pedrofausto/EMC08/ports/design/reports/report_area.txt

============================================================
  Generated by:           Encounter(R) RTL Compiler v07.20-s009_1
  Generated on:           Oct 01 2010  03:59:04 PM
  Module:                 PORT_TOP
  Technology library:     D_CELLS_MOSLP_typ_1_80V_25C V 2.1.0
  Operating conditions:   TYPICAL (balanced_tree)
  Wireload mode:          enclosed
  Area mode:              timing library
============================================================

Instance  Cells  Cell Area  Net Area   Wireload     
----------------------------------------------------
PORT_TOP     32        197        71       0_1k (S) 

 (S) = wireload was automatically selected
