pedrofausto/EMC08/timers/verification/reports/timer2/report_detail_module.html

ICCR HTML Report

Go to First Summary Coverage File
Go to First Detail Coverage File

COVERAGE FILE: | Go to detail report for this coverage file

/home/student/DFund-SBTUSER_6_1_1/Data/SBTBASIC/timer_emc08/verif/timer2_e/cov_work/design/tmr2_cov_test_f1/icc.data

Coverage Summary Report, Module-Based
B = Block, BR = Branch, E = Expression
ToC(%) = Total coverage percentage

Coverage data sorted by: Block Expression
Coverage data sorted using: coverage percentages

ToC(%)  B(%)              E(%)              Name
------------------------------------------------
0        -- (0/0)          -- (0/0)         timers_timer2_top_pdcf_pdf
0        -- (0/0)          -- (0/0)         top_timer2
65       65 (27/41)        65 (13/20)       timers_timer2_acg
68       72 (13/18)        64 (11/17)       timers_timer2_pdf
93       92 (13/14)       100 (2/2)         timers_timer2_pdcf
100     100 (3/3)          -- (0/0)         timer2_tb

COVERAGE FILE: | Go to detail report for this coverage file

/home/student/DFund-SBTUSER_6_1_1/Data/SBTBASIC/timer_emc08/verif/timer2_e/cov_work/design/tmr2_cov_test_f2/icc.data

Coverage Summary Report, Module-Based
B = Block, BR = Branch, E = Expression
ToC(%) = Total coverage percentage

Coverage data sorted by: Block Expression
Coverage data sorted using: coverage percentages

ToC(%)  B(%)              E(%)              Name
------------------------------------------------
0        -- (0/0)          -- (0/0)         timers_timer2_top_pdcf_pdf
0        -- (0/0)          -- (0/0)         top_timer2
68       72 (13/18)        64 (11/17)       timers_timer2_pdf
85       85 (35/41)        85 (17/20)       timers_timer2_acg
93       92 (13/14)       100 (2/2)         timers_timer2_pdcf
100     100 (3/3)          -- (0/0)         timer2_tb

COVERAGE FILE: | Go to detail report for this coverage file

/home/student/DFund-SBTUSER_6_1_1/Data/SBTBASIC/timer_emc08/verif/timer2_e/cov_work/design/tmr2_cov_test_f3/icc.data

Coverage Summary Report, Module-Based
B = Block, BR = Branch, E = Expression
ToC(%) = Total coverage percentage

Coverage data sorted by: Block Expression
Coverage data sorted using: coverage percentages

ToC(%)  B(%)              E(%)              Name
------------------------------------------------
0        -- (0/0)          -- (0/0)         timers_timer2_top_pdcf_pdf
0        -- (0/0)          -- (0/0)         top_timer2
68       72 (13/18)        64 (11/17)       timers_timer2_pdf
90       90 (37/41)        90 (18/20)       timers_timer2_acg
93       92 (13/14)       100 (2/2)         timers_timer2_pdcf
100     100 (3/3)          -- (0/0)         timer2_tb

COVERAGE FILE: | Go to detail report for this coverage file

/home/student/DFund-SBTUSER_6_1_1/Data/SBTBASIC/timer_emc08/verif/timer2_e/cov_work/design/tap_test_merge/icc.data

Coverage Summary Report, Module-Based
B = Block, BR = Branch, E = Expression
ToC(%) = Total coverage percentage

Coverage data sorted by: Block Expression
Coverage data sorted using: coverage percentages

ToC(%)  B(%)              E(%)              Name
------------------------------------------------
0        -- (0/0)          -- (0/0)         timers_timer2_top_pdcf_pdf
0        -- (0/0)          -- (0/0)         top_timer2
68       72 (13/18)        64 (11/17)       timers_timer2_pdf
93       92 (13/14)       100 (2/2)         timers_timer2_pdcf
93       92 (38/41)        95 (19/20)       timers_timer2_acg
100     100 (3/3)          -- (0/0)         timer2_tb

COVERAGE FILE: | Go to summary report for this coverage file

/home/student/DFund-SBTUSER_6_1_1/Data/SBTBASIC/timer_emc08/verif/timer2_e/cov_work/design/tmr2_cov_test_f1/icc.data

All Block Detail Report, Module/Entity-Based

Module/Entity name: timer2_tb

File name: /home/student/DFund-SBTUSER_6_1_1/Data/SBTBASIC/timer_emc08/verif/timer2_e/rtl_t2/tmr2_tb.v

Number of covered blocks: 3 of 3

Number of blocks marked COV: 0

Number of blocks marked IGN: 0

 cnt  block line number             line origin description
-----------------------------------------------------------------------
   1     110                           110   begin
   1     113                           113   #(PERIOD/2)			;
   1     115                           115   #(PERIOD/2)			;

Module/Entity name: timers_timer2_pdcf

File name: /home/student/DFund-SBTUSER_6_1_1/Data/SBTBASIC/timer_emc08/verif/timer2_e/rtl_t2/timers_timer2_pdcf.v

Number of covered blocks: 13 of 14

Number of blocks marked COV: 0

Number of blocks marked IGN: 0

 cnt  block line number             line origin description
-----------------------------------------------------------------------
   1      55                            55   begin
   1      57     true part of           56   if(!timers_timer2_pdcf_reset_i_b) 
   1      62     false part of          56   if(!timers_timer2_pdcf_reset_i_b) 
   1      71                            71   begin
   1      78                            78   begin
   1      80     a case item of         79   case (selector)
   1      84     a case item of         79   case (selector)
   1      88     a case item of         79   case (selector)
   1      92     a case item of         79   case (selector)
   1      96     a case item of         79   case (selector)
   1     100     a case item of         79   case (selector)
   1     104     a case item of         79   case (selector)
   1     108     a case item of         79   case (selector)
   0      79  *  implicit default:      79   case (selector)

Module/Entity name: timers_timer2_pdf

File name: /home/student/DFund-SBTUSER_6_1_1/Data/SBTBASIC/timer_emc08/verif/timer2_e/rtl_t2/timers_timer2_pdf.v

Number of covered blocks: 13 of 18

Number of blocks marked COV: 0

Number of blocks marked IGN: 0

 cnt  block line number             line origin description
-----------------------------------------------------------------------
   1      60                            60   begin
   1      62     true part of           61   if (!timers_timer2_reset_i)
   1      70     false part of          61   if (!timers_timer2_reset_i)
   1      75     true part of           74   if(timers_timer2_pdf_enable_i)
   1      81     false part of          74   if(timers_timer2_pdf_enable_i)
   1      85                            85   q_flop <= timers_timer2_pht_o         ; // output flop
   1      90     true part of           89   if (timers_sfr_tcon2_edsel_i)
   1      94     false part of          89   if (timers_sfr_tcon2_edsel_i)
   1     103                           103   begin
   1     110                           110   begin
   0     113     true part of          112   if(timers_sfr_tcon2_dfsel_i) // Digital filter sampling selection
   0     115     true part of          114   if(pdf_2sample[0] && pdf_2sample[1])
   0     118     true part of          117   if(pdf_2sample[1] && pdf_2sample[2])
   0     124     false part of         117   if(pdf_2sample[1] && pdf_2sample[2])
   0     130     false part of         114   if(pdf_2sample[0] && pdf_2sample[1])
   1     135     false part of         112   if(timers_sfr_tcon2_dfsel_i) // Digital filter sampling selection
   1     138     true part of          137   if(pdf_2sample[0] && pdf_2sample[1])
   1     142     false part of         137   if(pdf_2sample[0] && pdf_2sample[1])

Module/Entity name: timers_timer2_acg

File name: /home/student/DFund-SBTUSER_6_1_1/Data/SBTBASIC/timer_emc08/verif/timer2_e/rtl_t2/timers_timer2_acg.v

Number of covered blocks: 27 of 41

Number of blocks marked COV: 0

Number of blocks marked IGN: 0

 cnt  block line number             line origin description
-----------------------------------------------------------------------
   1      74                            74   begin
   1      76     true part of           75   if ( !timers_timer2_acg_reset_i_b )
   1      89     false part of          75   if ( !timers_timer2_acg_reset_i_b )
   1     111                           111   begin
   1     115     a case item of        113   case( state )
   1     118     true part of          117   if(phy_tooth == 1'b0)
   1     120     false part of         117   if(phy_tooth == 1'b0)
   1     123     a case item of        113   case( state )
   1     126     true part of          125   if(angle_clk == 24'd0)
   1     128     false part of         125   if(angle_clk == 24'd0)
   1     131     a case item of        113   case( state )
   1     134     true part of          133   if(ctrl_tooth == 1'b1)
   1     137     false part of         133   if(ctrl_tooth == 1'b1)
   0     140     a case item of        113   case( state )
   0     143     true part of          142   if(ctrl_tooth == 1'b1)
   0     146     false part of         142   if(ctrl_tooth == 1'b1)
   0     149     a case item of        113   case( state )
   1     158                           158   begin
   1     162     a case item of        160   case(state)
   1     170     true part of          169   if(phy_tooth)
   1     175     false part of         169   if(phy_tooth)
   1     181     a case item of        160   case(state)
   1     188     a case item of        160   case(state)
   0     193     true part of          192   if(phy_tooth)
   1     200     false part of         192   if(phy_tooth)
   0     206     a case item of        160   case(state)
   0     209     true part of          208   if(phy_tooth)
   0     216     false part of         208   if(phy_tooth)
   0     160  *  implicit default:     160   case(state)
   1     227                           227   if(state == STATE_DEC)
   1     228     true part of          227   if(state == STATE_DEC)
   0     230     true part of          229   if(!acr_inc)
   1     235     false part of         229   if(!acr_inc)
   1     240     false part of         227   if(state == STATE_DEC)
   0     242     true part of          241   if(state == STATE_INC)
   0     244     true part of          243   if(!acr_inc)
   0     249     false part of         243   if(!acr_inc)
   1     254     false part of         241   if(state == STATE_INC)
   1     259                           259   if(acr_aux2[24] == 1'b1)
   0     260     true part of          259   if(acr_aux2[24] == 1'b1)
   1     267     false part of         259   if(acr_aux2[24] == 1'b1)

All Expression Detail Report, Module/Entity-Based

Coverage Table Legend

- don't care

O (odd), E (even), B (both), X (not scored), V (marked covered),

I (marked ignore) for parity trees

COV Marked covered by user - included in covered and totals

IGN Marked ignore by user or through COM - excluded from

uncovered and totals

CON Impossible expression term as determined by instrumentation

due to literal constants - excluded from uncovered and totals

rval Resulting value of the expression for coverage purposes given

the input values

<-n-> Shows the n-th term composition

Module/Entity name: timers_timer2_pdcf
File name: /home/student/DFund-SBTUSER_6_1_1/Data/SBTBASIC/timer_emc08/verif/timer2_e/rtl_t2/timers_timer2_pdcf.v
Number of covered expressions: 2 of 2
Number of expr items marked COV: 0
Number of expr items marked IGN: 0

Line Coverage Expression description -------------------------------------------------------------------------------- 56 100% (2/2) if(!timers_timer2_pdcf_reset_i_b) !timers_timer2_pdcf_reset_i_b <-------------1-------------> hit | <1> ! ----------- 1 | 1 1 | 0

Module/Entity name: timers_timer2_pdf
File name: /home/student/DFund-SBTUSER_6_1_1/Data/SBTBASIC/timer_emc08/verif/timer2_e/rtl_t2/timers_timer2_pdf.v
Number of covered expressions: 11 of 17
Number of expr items marked COV: 0
Number of expr items marked IGN: 0

Line Coverage Expression description -------------------------------------------------------------------------------- 61 100% (2/2) if (!timers_timer2_reset_i) !timers_timer2_reset_i <---------1----------> hit | <1> ! ----------- 1 | 1 1 | 0 86 100% (3/3) rise <= timers_timer2_pht_o & ~q_flop ; // rise detector timers_timer2_pht_o & ( ~q_flop ) <--------1---------> <--2---> hit | rval | <1> <2> ---------------------- 1 | 1 | 1 0 1 | 0 | - 1 1 | 0 | 0 - 87 100% (3/3) fall <= ~timers_timer2_pht_o & q_flop ; // fall detector ( ~timers_timer2_pht_o ) & q_flop <---------1---------> <--2---> hit | rval | <1> <2> ---------------------- 1 | 1 | 0 1 1 | 0 | - 0 1 | 0 | 1 - 114 0% (0/3) if(pdf_2sample[0] && pdf_2sample[1]) pdf_2sample[0] && pdf_2sample[1] <------1------> <-------2-------> hit | <1> <2> && --------------- 0 | 0 - 0 | - 0 0 | 1 1 117 0% (0/3) if(pdf_2sample[1] && pdf_2sample[2]) pdf_2sample[1] && pdf_2sample[2] <------1------> <-------2-------> hit | <1> <2> && --------------- 0 | 0 - 0 | - 0 0 | 1 1 137 100% (3/3) if(pdf_2sample[0] && pdf_2sample[1]) pdf_2sample[0] && pdf_2sample[1] <------1------> <-------2-------> hit | <1> <2> && --------------- 1 | 0 - 1 | - 0 1 | 1 1

Module/Entity name: timers_timer2_acg
File name: /home/student/DFund-SBTUSER_6_1_1/Data/SBTBASIC/timer_emc08/verif/timer2_e/rtl_t2/timers_timer2_acg.v
Number of covered expressions: 13 of 20
Number of expr items marked COV: 0
Number of expr items marked IGN: 0

Line Coverage Expression description -------------------------------------------------------------------------------- 75 100% (2/2) if ( !timers_timer2_acg_reset_i_b ) !timers_timer2_acg_reset_i_b <------------1-------------> hit | <1> ! ----------- 1 | 1 1 | 0 117 100% (2/2) if(phy_tooth == 1'b0) phy_tooth == 1'b0 <---1----> <--2--> hit | <1> <2> == ------------------------- 1 | lhs == rhs 1 | lhs != rhs 125 100% (2/2) if(angle_clk == 24'd0) angle_clk == 24'd0 <---1----> <--2---> hit | <1> <2> == ------------------------- 1 | lhs == rhs 1 | lhs != rhs 133 100% (2/2) if(ctrl_tooth == 1'b1) ctrl_tooth == 1'b1 <----1----> <--2--> hit | <1> <2> == ------------------------- 1 | lhs == rhs 1 | lhs != rhs 142 0% (0/2) if(ctrl_tooth == 1'b1) ctrl_tooth == 1'b1 <----1----> <--2--> hit | <1> <2> == ------------------------- 0 | lhs == rhs 0 | lhs != rhs 227 100% (2/2) if(state == STATE_DEC) state == STATE_DEC <-1--> <----2-----> hit | <1> <2> == ------------------------- 1 | lhs == rhs 1 | lhs != rhs 229 50% (1/2) if(!acr_inc) !acr_inc <--1---> hit | <1> ! ----------- 1 | 1 0 | 0 241 50% (1/2) if(state == STATE_INC) state == STATE_INC <-1--> <----2-----> hit | <1> <2> == ------------------------- 0 | lhs == rhs 1 | lhs != rhs 243 0% (0/2) if(!acr_inc) !acr_inc <--1---> hit | <1> ! ----------- 0 | 1 0 | 0 259 50% (1/2) if(acr_aux2[24] == 1'b1) acr_aux2[24] == 1'b1 <-----1-----> <--2--> hit | <1> <2> == ------------------------- 0 | lhs == rhs 1 | lhs != rhs

COVERAGE FILE: | Go to summary report for this coverage file

/home/student/DFund-SBTUSER_6_1_1/Data/SBTBASIC/timer_emc08/verif/timer2_e/cov_work/design/tmr2_cov_test_f2/icc.data

All Block Detail Report, Module/Entity-Based

Module/Entity name: timer2_tb

File name: /home/student/DFund-SBTUSER_6_1_1/Data/SBTBASIC/timer_emc08/verif/timer2_e/rtl_t2/tmr2_tb.v

Number of covered blocks: 3 of 3

Number of blocks marked COV: 0

Number of blocks marked IGN: 0

 cnt  block line number             line origin description
-----------------------------------------------------------------------
   1     110                           110   begin
   1     113                           113   #(PERIOD/2)			;
   1     115                           115   #(PERIOD/2)			;

Module/Entity name: timers_timer2_pdcf

File name: /home/student/DFund-SBTUSER_6_1_1/Data/SBTBASIC/timer_emc08/verif/timer2_e/rtl_t2/timers_timer2_pdcf.v

Number of covered blocks: 13 of 14

Number of blocks marked COV: 0

Number of blocks marked IGN: 0

 cnt  block line number             line origin description
-----------------------------------------------------------------------
   1      55                            55   begin
   1      57     true part of           56   if(!timers_timer2_pdcf_reset_i_b) 
   1      62     false part of          56   if(!timers_timer2_pdcf_reset_i_b) 
   1      71                            71   begin
   1      78                            78   begin
   1      80     a case item of         79   case (selector)
   1      84     a case item of         79   case (selector)
   1      88     a case item of         79   case (selector)
   1      92     a case item of         79   case (selector)
   1      96     a case item of         79   case (selector)
   1     100     a case item of         79   case (selector)
   1     104     a case item of         79   case (selector)
   1     108     a case item of         79   case (selector)
   0      79  *  implicit default:      79   case (selector)

Module/Entity name: timers_timer2_pdf

File name: /home/student/DFund-SBTUSER_6_1_1/Data/SBTBASIC/timer_emc08/verif/timer2_e/rtl_t2/timers_timer2_pdf.v

Number of covered blocks: 13 of 18

Number of blocks marked COV: 0

Number of blocks marked IGN: 0

 cnt  block line number             line origin description
-----------------------------------------------------------------------
   1      60                            60   begin
   1      62     true part of           61   if (!timers_timer2_reset_i)
   1      70     false part of          61   if (!timers_timer2_reset_i)
   1      75     true part of           74   if(timers_timer2_pdf_enable_i)
   1      81     false part of          74   if(timers_timer2_pdf_enable_i)
   1      85                            85   q_flop <= timers_timer2_pht_o         ; // output flop
   1      90     true part of           89   if (timers_sfr_tcon2_edsel_i)
   1      94     false part of          89   if (timers_sfr_tcon2_edsel_i)
   1     103                           103   begin
   1     110                           110   begin
   0     113     true part of          112   if(timers_sfr_tcon2_dfsel_i) // Digital filter sampling selection
   0     115     true part of          114   if(pdf_2sample[0] && pdf_2sample[1])
   0     118     true part of          117   if(pdf_2sample[1] && pdf_2sample[2])
   0     124     false part of         117   if(pdf_2sample[1] && pdf_2sample[2])
   0     130     false part of         114   if(pdf_2sample[0] && pdf_2sample[1])
   1     135     false part of         112   if(timers_sfr_tcon2_dfsel_i) // Digital filter sampling selection
   1     138     true part of          137   if(pdf_2sample[0] && pdf_2sample[1])
   1     142     false part of         137   if(pdf_2sample[0] && pdf_2sample[1])

Module/Entity name: timers_timer2_acg

File name: /home/student/DFund-SBTUSER_6_1_1/Data/SBTBASIC/timer_emc08/verif/timer2_e/rtl_t2/timers_timer2_acg.v

Number of covered blocks: 35 of 41

Number of blocks marked COV: 0

Number of blocks marked IGN: 0

 cnt  block line number             line origin description
-----------------------------------------------------------------------
   1      74                            74   begin
   1      76     true part of           75   if ( !timers_timer2_acg_reset_i_b )
   1      89     false part of          75   if ( !timers_timer2_acg_reset_i_b )
   1     111                           111   begin
   1     115     a case item of        113   case( state )
   1     118     true part of          117   if(phy_tooth == 1'b0)
   1     120     false part of         117   if(phy_tooth == 1'b0)
   1     123     a case item of        113   case( state )
   1     126     true part of          125   if(angle_clk == 24'd0)
   1     128     false part of         125   if(angle_clk == 24'd0)
   1     131     a case item of        113   case( state )
   1     134     true part of          133   if(ctrl_tooth == 1'b1)
   1     137     false part of         133   if(ctrl_tooth == 1'b1)
   1     140     a case item of        113   case( state )
   0     143     true part of          142   if(ctrl_tooth == 1'b1)
   1     146     false part of         142   if(ctrl_tooth == 1'b1)
   0     149     a case item of        113   case( state )
   1     158                           158   begin
   1     162     a case item of        160   case(state)
   1     170     true part of          169   if(phy_tooth)
   1     175     false part of         169   if(phy_tooth)
   1     181     a case item of        160   case(state)
   1     188     a case item of        160   case(state)
   1     193     true part of          192   if(phy_tooth)
   1     200     false part of         192   if(phy_tooth)
   1     206     a case item of        160   case(state)
   0     209     true part of          208   if(phy_tooth)
   1     216     false part of         208   if(phy_tooth)
   0     160  *  implicit default:     160   case(state)
   1     227                           227   if(state == STATE_DEC)
   1     228     true part of          227   if(state == STATE_DEC)
   1     230     true part of          229   if(!acr_inc)
   1     235     false part of         229   if(!acr_inc)
   1     240     false part of         227   if(state == STATE_DEC)
   1     242     true part of          241   if(state == STATE_INC)
   0     244     true part of          243   if(!acr_inc)
   1     249     false part of         243   if(!acr_inc)
   1     254     false part of         241   if(state == STATE_INC)
   1     259                           259   if(acr_aux2[24] == 1'b1)
   0     260     true part of          259   if(acr_aux2[24] == 1'b1)
   1     267     false part of         259   if(acr_aux2[24] == 1'b1)

All Expression Detail Report, Module/Entity-Based

Coverage Table Legend

- don't care

O (odd), E (even), B (both), X (not scored), V (marked covered),

I (marked ignore) for parity trees

COV Marked covered by user - included in covered and totals

IGN Marked ignore by user or through COM - excluded from

uncovered and totals

CON Impossible expression term as determined by instrumentation

due to literal constants - excluded from uncovered and totals

rval Resulting value of the expression for coverage purposes given

the input values

<-n-> Shows the n-th term composition

Module/Entity name: timers_timer2_pdcf
File name: /home/student/DFund-SBTUSER_6_1_1/Data/SBTBASIC/timer_emc08/verif/timer2_e/rtl_t2/timers_timer2_pdcf.v
Number of covered expressions: 2 of 2
Number of expr items marked COV: 0
Number of expr items marked IGN: 0

Line Coverage Expression description -------------------------------------------------------------------------------- 56 100% (2/2) if(!timers_timer2_pdcf_reset_i_b) !timers_timer2_pdcf_reset_i_b <-------------1-------------> hit | <1> ! ----------- 1 | 1 1 | 0

Module/Entity name: timers_timer2_pdf
File name: /home/student/DFund-SBTUSER_6_1_1/Data/SBTBASIC/timer_emc08/verif/timer2_e/rtl_t2/timers_timer2_pdf.v
Number of covered expressions: 11 of 17
Number of expr items marked COV: 0
Number of expr items marked IGN: 0

Line Coverage Expression description -------------------------------------------------------------------------------- 61 100% (2/2) if (!timers_timer2_reset_i) !timers_timer2_reset_i <---------1----------> hit | <1> ! ----------- 1 | 1 1 | 0 86 100% (3/3) rise <= timers_timer2_pht_o & ~q_flop ; // rise detector timers_timer2_pht_o & ( ~q_flop ) <--------1---------> <--2---> hit | rval | <1> <2> ---------------------- 1 | 1 | 1 0 1 | 0 | - 1 1 | 0 | 0 - 87 100% (3/3) fall <= ~timers_timer2_pht_o & q_flop ; // fall detector ( ~timers_timer2_pht_o ) & q_flop <---------1---------> <--2---> hit | rval | <1> <2> ---------------------- 1 | 1 | 0 1 1 | 0 | - 0 1 | 0 | 1 - 114 0% (0/3) if(pdf_2sample[0] && pdf_2sample[1]) pdf_2sample[0] && pdf_2sample[1] <------1------> <-------2-------> hit | <1> <2> && --------------- 0 | 0 - 0 | - 0 0 | 1 1 117 0% (0/3) if(pdf_2sample[1] && pdf_2sample[2]) pdf_2sample[1] && pdf_2sample[2] <------1------> <-------2-------> hit | <1> <2> && --------------- 0 | 0 - 0 | - 0 0 | 1 1 137 100% (3/3) if(pdf_2sample[0] && pdf_2sample[1]) pdf_2sample[0] && pdf_2sample[1] <------1------> <-------2-------> hit | <1> <2> && --------------- 1 | 0 - 1 | - 0 1 | 1 1

Module/Entity name: timers_timer2_acg
File name: /home/student/DFund-SBTUSER_6_1_1/Data/SBTBASIC/timer_emc08/verif/timer2_e/rtl_t2/timers_timer2_acg.v
Number of covered expressions: 17 of 20
Number of expr items marked COV: 0
Number of expr items marked IGN: 0

Line Coverage Expression description -------------------------------------------------------------------------------- 75 100% (2/2) if ( !timers_timer2_acg_reset_i_b ) !timers_timer2_acg_reset_i_b <------------1-------------> hit | <1> ! ----------- 1 | 1 1 | 0 117 100% (2/2) if(phy_tooth == 1'b0) phy_tooth == 1'b0 <---1----> <--2--> hit | <1> <2> == ------------------------- 1 | lhs == rhs 1 | lhs != rhs 125 100% (2/2) if(angle_clk == 24'd0) angle_clk == 24'd0 <---1----> <--2---> hit | <1> <2> == ------------------------- 1 | lhs == rhs 1 | lhs != rhs 133 100% (2/2) if(ctrl_tooth == 1'b1) ctrl_tooth == 1'b1 <----1----> <--2--> hit | <1> <2> == ------------------------- 1 | lhs == rhs 1 | lhs != rhs 142 50% (1/2) if(ctrl_tooth == 1'b1) ctrl_tooth == 1'b1 <----1----> <--2--> hit | <1> <2> == ------------------------- 0 | lhs == rhs 1 | lhs != rhs 227 100% (2/2) if(state == STATE_DEC) state == STATE_DEC <-1--> <----2-----> hit | <1> <2> == ------------------------- 1 | lhs == rhs 1 | lhs != rhs 229 100% (2/2) if(!acr_inc) !acr_inc <--1---> hit | <1> ! ----------- 1 | 1 1 | 0 241 100% (2/2) if(state == STATE_INC) state == STATE_INC <-1--> <----2-----> hit | <1> <2> == ------------------------- 1 | lhs == rhs 1 | lhs != rhs 243 50% (1/2) if(!acr_inc) !acr_inc <--1---> hit | <1> ! ----------- 1 | 1 0 | 0 259 50% (1/2) if(acr_aux2[24] == 1'b1) acr_aux2[24] == 1'b1 <-----1-----> <--2--> hit | <1> <2> == ------------------------- 0 | lhs == rhs 1 | lhs != rhs

COVERAGE FILE: | Go to summary report for this coverage file

/home/student/DFund-SBTUSER_6_1_1/Data/SBTBASIC/timer_emc08/verif/timer2_e/cov_work/design/tmr2_cov_test_f3/icc.data

All Block Detail Report, Module/Entity-Based

Module/Entity name: timer2_tb

File name: /home/student/DFund-SBTUSER_6_1_1/Data/SBTBASIC/timer_emc08/verif/timer2_e/rtl_t2/tmr2_tb.v

Number of covered blocks: 3 of 3

Number of blocks marked COV: 0

Number of blocks marked IGN: 0

 cnt  block line number             line origin description
-----------------------------------------------------------------------
   1     110                           110   begin
   1     113                           113   #(PERIOD/2)			;
   1     115                           115   #(PERIOD/2)			;

Module/Entity name: timers_timer2_pdcf

File name: /home/student/DFund-SBTUSER_6_1_1/Data/SBTBASIC/timer_emc08/verif/timer2_e/rtl_t2/timers_timer2_pdcf.v

Number of covered blocks: 13 of 14

Number of blocks marked COV: 0

Number of blocks marked IGN: 0

 cnt  block line number             line origin description
-----------------------------------------------------------------------
   1      55                            55   begin
   1      57     true part of           56   if(!timers_timer2_pdcf_reset_i_b) 
   1      62     false part of          56   if(!timers_timer2_pdcf_reset_i_b) 
   1      71                            71   begin
   1      78                            78   begin
   1      80     a case item of         79   case (selector)
   1      84     a case item of         79   case (selector)
   1      88     a case item of         79   case (selector)
   1      92     a case item of         79   case (selector)
   1      96     a case item of         79   case (selector)
   1     100     a case item of         79   case (selector)
   1     104     a case item of         79   case (selector)
   1     108     a case item of         79   case (selector)
   0      79  *  implicit default:      79   case (selector)

Module/Entity name: timers_timer2_pdf

File name: /home/student/DFund-SBTUSER_6_1_1/Data/SBTBASIC/timer_emc08/verif/timer2_e/rtl_t2/timers_timer2_pdf.v

Number of covered blocks: 13 of 18

Number of blocks marked COV: 0

Number of blocks marked IGN: 0

 cnt  block line number             line origin description
-----------------------------------------------------------------------
   1      60                            60   begin
   1      62     true part of           61   if (!timers_timer2_reset_i)
   1      70     false part of          61   if (!timers_timer2_reset_i)
   1      75     true part of           74   if(timers_timer2_pdf_enable_i)
   1      81     false part of          74   if(timers_timer2_pdf_enable_i)
   1      85                            85   q_flop <= timers_timer2_pht_o         ; // output flop
   1      90     true part of           89   if (timers_sfr_tcon2_edsel_i)
   1      94     false part of          89   if (timers_sfr_tcon2_edsel_i)
   1     103                           103   begin
   1     110                           110   begin
   0     113     true part of          112   if(timers_sfr_tcon2_dfsel_i) // Digital filter sampling selection
   0     115     true part of          114   if(pdf_2sample[0] && pdf_2sample[1])
   0     118     true part of          117   if(pdf_2sample[1] && pdf_2sample[2])
   0     124     false part of         117   if(pdf_2sample[1] && pdf_2sample[2])
   0     130     false part of         114   if(pdf_2sample[0] && pdf_2sample[1])
   1     135     false part of         112   if(timers_sfr_tcon2_dfsel_i) // Digital filter sampling selection
   1     138     true part of          137   if(pdf_2sample[0] && pdf_2sample[1])
   1     142     false part of         137   if(pdf_2sample[0] && pdf_2sample[1])

Module/Entity name: timers_timer2_acg

File name: /home/student/DFund-SBTUSER_6_1_1/Data/SBTBASIC/timer_emc08/verif/timer2_e/rtl_t2/timers_timer2_acg.v

Number of covered blocks: 37 of 41

Number of blocks marked COV: 0

Number of blocks marked IGN: 0

 cnt  block line number             line origin description
-----------------------------------------------------------------------
   1      74                            74   begin
   1      76     true part of           75   if ( !timers_timer2_acg_reset_i_b )
   1      89     false part of          75   if ( !timers_timer2_acg_reset_i_b )
   1     111                           111   begin
   1     115     a case item of        113   case( state )
   1     118     true part of          117   if(phy_tooth == 1'b0)
   1     120     false part of         117   if(phy_tooth == 1'b0)
   1     123     a case item of        113   case( state )
   1     126     true part of          125   if(angle_clk == 24'd0)
   1     128     false part of         125   if(angle_clk == 24'd0)
   1     131     a case item of        113   case( state )
   1     134     true part of          133   if(ctrl_tooth == 1'b1)
   1     137     false part of         133   if(ctrl_tooth == 1'b1)
   1     140     a case item of        113   case( state )
   1     143     true part of          142   if(ctrl_tooth == 1'b1)
   1     146     false part of         142   if(ctrl_tooth == 1'b1)
   0     149     a case item of        113   case( state )
   1     158                           158   begin
   1     162     a case item of        160   case(state)
   0     170     true part of          169   if(phy_tooth)
   1     175     false part of         169   if(phy_tooth)
   1     181     a case item of        160   case(state)
   1     188     a case item of        160   case(state)
   1     193     true part of          192   if(phy_tooth)
   1     200     false part of         192   if(phy_tooth)
   1     206     a case item of        160   case(state)
   1     209     true part of          208   if(phy_tooth)
   1     216     false part of         208   if(phy_tooth)
   0     160  *  implicit default:     160   case(state)
   1     227                           227   if(state == STATE_DEC)
   1     228     true part of          227   if(state == STATE_DEC)
   1     230     true part of          229   if(!acr_inc)
   1     235     false part of         229   if(!acr_inc)
   1     240     false part of         227   if(state == STATE_DEC)
   1     242     true part of          241   if(state == STATE_INC)
   1     244     true part of          243   if(!acr_inc)
   1     249     false part of         243   if(!acr_inc)
   1     254     false part of         241   if(state == STATE_INC)
   1     259                           259   if(acr_aux2[24] == 1'b1)
   0     260     true part of          259   if(acr_aux2[24] == 1'b1)
   1     267     false part of         259   if(acr_aux2[24] == 1'b1)

All Expression Detail Report, Module/Entity-Based

Coverage Table Legend

- don't care

O (odd), E (even), B (both), X (not scored), V (marked covered),

I (marked ignore) for parity trees

COV Marked covered by user - included in covered and totals

IGN Marked ignore by user or through COM - excluded from

uncovered and totals

CON Impossible expression term as determined by instrumentation

due to literal constants - excluded from uncovered and totals

rval Resulting value of the expression for coverage purposes given

the input values

<-n-> Shows the n-th term composition

Module/Entity name: timers_timer2_pdcf
File name: /home/student/DFund-SBTUSER_6_1_1/Data/SBTBASIC/timer_emc08/verif/timer2_e/rtl_t2/timers_timer2_pdcf.v
Number of covered expressions: 2 of 2
Number of expr items marked COV: 0
Number of expr items marked IGN: 0

Line Coverage Expression description -------------------------------------------------------------------------------- 56 100% (2/2) if(!timers_timer2_pdcf_reset_i_b) !timers_timer2_pdcf_reset_i_b <-------------1-------------> hit | <1> ! ----------- 1 | 1 1 | 0

Module/Entity name: timers_timer2_pdf
File name: /home/student/DFund-SBTUSER_6_1_1/Data/SBTBASIC/timer_emc08/verif/timer2_e/rtl_t2/timers_timer2_pdf.v
Number of covered expressions: 11 of 17
Number of expr items marked COV: 0
Number of expr items marked IGN: 0

Line Coverage Expression description -------------------------------------------------------------------------------- 61 100% (2/2) if (!timers_timer2_reset_i) !timers_timer2_reset_i <---------1----------> hit | <1> ! ----------- 1 | 1 1 | 0 86 100% (3/3) rise <= timers_timer2_pht_o & ~q_flop ; // rise detector timers_timer2_pht_o & ( ~q_flop ) <--------1---------> <--2---> hit | rval | <1> <2> ---------------------- 1 | 1 | 1 0 1 | 0 | - 1 1 | 0 | 0 - 87 100% (3/3) fall <= ~timers_timer2_pht_o & q_flop ; // fall detector ( ~timers_timer2_pht_o ) & q_flop <---------1---------> <--2---> hit | rval | <1> <2> ---------------------- 1 | 1 | 0 1 1 | 0 | - 0 1 | 0 | 1 - 114 0% (0/3) if(pdf_2sample[0] && pdf_2sample[1]) pdf_2sample[0] && pdf_2sample[1] <------1------> <-------2-------> hit | <1> <2> && --------------- 0 | 0 - 0 | - 0 0 | 1 1 117 0% (0/3) if(pdf_2sample[1] && pdf_2sample[2]) pdf_2sample[1] && pdf_2sample[2] <------1------> <-------2-------> hit | <1> <2> && --------------- 0 | 0 - 0 | - 0 0 | 1 1 137 100% (3/3) if(pdf_2sample[0] && pdf_2sample[1]) pdf_2sample[0] && pdf_2sample[1] <------1------> <-------2-------> hit | <1> <2> && --------------- 1 | 0 - 1 | - 0 1 | 1 1

Module/Entity name: timers_timer2_acg
File name: /home/student/DFund-SBTUSER_6_1_1/Data/SBTBASIC/timer_emc08/verif/timer2_e/rtl_t2/timers_timer2_acg.v
Number of covered expressions: 18 of 20
Number of expr items marked COV: 0
Number of expr items marked IGN: 0

Line Coverage Expression description -------------------------------------------------------------------------------- 75 100% (2/2) if ( !timers_timer2_acg_reset_i_b ) !timers_timer2_acg_reset_i_b <------------1-------------> hit | <1> ! ----------- 1 | 1 1 | 0 117 50% (1/2) if(phy_tooth == 1'b0) phy_tooth == 1'b0 <---1----> <--2--> hit | <1> <2> == ------------------------- 1 | lhs == rhs 0 | lhs != rhs 125 100% (2/2) if(angle_clk == 24'd0) angle_clk == 24'd0 <---1----> <--2---> hit | <1> <2> == ------------------------- 1 | lhs == rhs 1 | lhs != rhs 133 100% (2/2) if(ctrl_tooth == 1'b1) ctrl_tooth == 1'b1 <----1----> <--2--> hit | <1> <2> == ------------------------- 1 | lhs == rhs 1 | lhs != rhs 142 100% (2/2) if(ctrl_tooth == 1'b1) ctrl_tooth == 1'b1 <----1----> <--2--> hit | <1> <2> == ------------------------- 1 | lhs == rhs 1 | lhs != rhs 227 100% (2/2) if(state == STATE_DEC) state == STATE_DEC <-1--> <----2-----> hit | <1> <2> == ------------------------- 1 | lhs == rhs 1 | lhs != rhs 229 100% (2/2) if(!acr_inc) !acr_inc <--1---> hit | <1> ! ----------- 1 | 1 1 | 0 241 100% (2/2) if(state == STATE_INC) state == STATE_INC <-1--> <----2-----> hit | <1> <2> == ------------------------- 1 | lhs == rhs 1 | lhs != rhs 243 100% (2/2) if(!acr_inc) !acr_inc <--1---> hit | <1> ! ----------- 1 | 1 1 | 0 259 50% (1/2) if(acr_aux2[24] == 1'b1) acr_aux2[24] == 1'b1 <-----1-----> <--2--> hit | <1> <2> == ------------------------- 0 | lhs == rhs 1 | lhs != rhs

COVERAGE FILE: | Go to summary report for this coverage file

/home/student/DFund-SBTUSER_6_1_1/Data/SBTBASIC/timer_emc08/verif/timer2_e/cov_work/design/tap_test_merge/icc.data

All Block Detail Report, Module/Entity-Based

Module/Entity name: timer2_tb

File name: /home/student/DFund-SBTUSER_6_1_1/Data/SBTBASIC/timer_emc08/verif/timer2_e/rtl_t2/tmr2_tb.v

Number of covered blocks: 3 of 3

Number of blocks marked COV: 0

Number of blocks marked IGN: 0

 cnt  block line number             line origin description
-----------------------------------------------------------------------
   1     110                           110   begin
   1     113                           113   #(PERIOD/2)			;
   1     115                           115   #(PERIOD/2)			;

Module/Entity name: timers_timer2_pdcf

File name: /home/student/DFund-SBTUSER_6_1_1/Data/SBTBASIC/timer_emc08/verif/timer2_e/rtl_t2/timers_timer2_pdcf.v

Number of covered blocks: 13 of 14

Number of blocks marked COV: 0

Number of blocks marked IGN: 0

 cnt  block line number             line origin description
-----------------------------------------------------------------------
   1      55                            55   begin
   1      57     true part of           56   if(!timers_timer2_pdcf_reset_i_b) 
   1      62     false part of          56   if(!timers_timer2_pdcf_reset_i_b) 
   1      71                            71   begin
   1      78                            78   begin
   1      80     a case item of         79   case (selector)
   1      84     a case item of         79   case (selector)
   1      88     a case item of         79   case (selector)
   1      92     a case item of         79   case (selector)
   1      96     a case item of         79   case (selector)
   1     100     a case item of         79   case (selector)
   1     104     a case item of         79   case (selector)
   1     108     a case item of         79   case (selector)
   0      79  *  implicit default:      79   case (selector)

Module/Entity name: timers_timer2_pdf

File name: /home/student/DFund-SBTUSER_6_1_1/Data/SBTBASIC/timer_emc08/verif/timer2_e/rtl_t2/timers_timer2_pdf.v

Number of covered blocks: 13 of 18

Number of blocks marked COV: 0

Number of blocks marked IGN: 0

 cnt  block line number             line origin description
-----------------------------------------------------------------------
   1      60                            60   begin
   1      62     true part of           61   if (!timers_timer2_reset_i)
   1      70     false part of          61   if (!timers_timer2_reset_i)
   1      75     true part of           74   if(timers_timer2_pdf_enable_i)
   1      81     false part of          74   if(timers_timer2_pdf_enable_i)
   1      85                            85   q_flop <= timers_timer2_pht_o         ; // output flop
   1      90     true part of           89   if (timers_sfr_tcon2_edsel_i)
   1      94     false part of          89   if (timers_sfr_tcon2_edsel_i)
   1     103                           103   begin
   1     110                           110   begin
   0     113     true part of          112   if(timers_sfr_tcon2_dfsel_i) // Digital filter sampling selection
   0     115     true part of          114   if(pdf_2sample[0] && pdf_2sample[1])
   0     118     true part of          117   if(pdf_2sample[1] && pdf_2sample[2])
   0     124     false part of         117   if(pdf_2sample[1] && pdf_2sample[2])
   0     130     false part of         114   if(pdf_2sample[0] && pdf_2sample[1])
   1     135     false part of         112   if(timers_sfr_tcon2_dfsel_i) // Digital filter sampling selection
   1     138     true part of          137   if(pdf_2sample[0] && pdf_2sample[1])
   1     142     false part of         137   if(pdf_2sample[0] && pdf_2sample[1])

Module/Entity name: timers_timer2_acg

File name: /home/student/DFund-SBTUSER_6_1_1/Data/SBTBASIC/timer_emc08/verif/timer2_e/rtl_t2/timers_timer2_acg.v

Number of covered blocks: 38 of 41

Number of blocks marked COV: 0

Number of blocks marked IGN: 0

 cnt  block line number             line origin description
-----------------------------------------------------------------------
   1      74                            74   begin
   1      76     true part of           75   if ( !timers_timer2_acg_reset_i_b )
   1      89     false part of          75   if ( !timers_timer2_acg_reset_i_b )
   1     111                           111   begin
   1     115     a case item of        113   case( state )
   1     118     true part of          117   if(phy_tooth == 1'b0)
   1     120     false part of         117   if(phy_tooth == 1'b0)
   1     123     a case item of        113   case( state )
   1     126     true part of          125   if(angle_clk == 24'd0)
   1     128     false part of         125   if(angle_clk == 24'd0)
   1     131     a case item of        113   case( state )
   1     134     true part of          133   if(ctrl_tooth == 1'b1)
   1     137     false part of         133   if(ctrl_tooth == 1'b1)
   1     140     a case item of        113   case( state )
   1     143     true part of          142   if(ctrl_tooth == 1'b1)
   1     146     false part of         142   if(ctrl_tooth == 1'b1)
   0     149     a case item of        113   case( state )
   1     158                           158   begin
   1     162     a case item of        160   case(state)
   1     170     true part of          169   if(phy_tooth)
   1     175     false part of         169   if(phy_tooth)
   1     181     a case item of        160   case(state)
   1     188     a case item of        160   case(state)
   1     193     true part of          192   if(phy_tooth)
   1     200     false part of         192   if(phy_tooth)
   1     206     a case item of        160   case(state)
   1     209     true part of          208   if(phy_tooth)
   1     216     false part of         208   if(phy_tooth)
   0     160  *  implicit default:     160   case(state)
   1     227                           227   if(state == STATE_DEC)
   1     228     true part of          227   if(state == STATE_DEC)
   1     230     true part of          229   if(!acr_inc)
   1     235     false part of         229   if(!acr_inc)
   1     240     false part of         227   if(state == STATE_DEC)
   1     242     true part of          241   if(state == STATE_INC)
   1     244     true part of          243   if(!acr_inc)
   1     249     false part of         243   if(!acr_inc)
   1     254     false part of         241   if(state == STATE_INC)
   1     259                           259   if(acr_aux2[24] == 1'b1)
   0     260     true part of          259   if(acr_aux2[24] == 1'b1)
   1     267     false part of         259   if(acr_aux2[24] == 1'b1)

All Expression Detail Report, Module/Entity-Based

Coverage Table Legend

- don't care

O (odd), E (even), B (both), X (not scored), V (marked covered),

I (marked ignore) for parity trees

COV Marked covered by user - included in covered and totals

IGN Marked ignore by user or through COM - excluded from

uncovered and totals

CON Impossible expression term as determined by instrumentation

due to literal constants - excluded from uncovered and totals

rval Resulting value of the expression for coverage purposes given

the input values

<-n-> Shows the n-th term composition

Module/Entity name: timers_timer2_pdcf
File name: /home/student/DFund-SBTUSER_6_1_1/Data/SBTBASIC/timer_emc08/verif/timer2_e/rtl_t2/timers_timer2_pdcf.v
Number of covered expressions: 2 of 2
Number of expr items marked COV: 0
Number of expr items marked IGN: 0

Line Coverage Expression description -------------------------------------------------------------------------------- 56 100% (2/2) if(!timers_timer2_pdcf_reset_i_b) !timers_timer2_pdcf_reset_i_b <-------------1-------------> hit | <1> ! ----------- 1 | 1 1 | 0

Module/Entity name: timers_timer2_pdf
File name: /home/student/DFund-SBTUSER_6_1_1/Data/SBTBASIC/timer_emc08/verif/timer2_e/rtl_t2/timers_timer2_pdf.v
Number of covered expressions: 11 of 17
Number of expr items marked COV: 0
Number of expr items marked IGN: 0

Line Coverage Expression description -------------------------------------------------------------------------------- 61 100% (2/2) if (!timers_timer2_reset_i) !timers_timer2_reset_i <---------1----------> hit | <1> ! ----------- 1 | 1 1 | 0 86 100% (3/3) rise <= timers_timer2_pht_o & ~q_flop ; // rise detector timers_timer2_pht_o & ( ~q_flop ) <--------1---------> <--2---> hit | rval | <1> <2> ---------------------- 1 | 1 | 1 0 1 | 0 | - 1 1 | 0 | 0 - 87 100% (3/3) fall <= ~timers_timer2_pht_o & q_flop ; // fall detector ( ~timers_timer2_pht_o ) & q_flop <---------1---------> <--2---> hit | rval | <1> <2> ---------------------- 1 | 1 | 0 1 1 | 0 | - 0 1 | 0 | 1 - 114 0% (0/3) if(pdf_2sample[0] && pdf_2sample[1]) pdf_2sample[0] && pdf_2sample[1] <------1------> <-------2-------> hit | <1> <2> && --------------- 0 | 0 - 0 | - 0 0 | 1 1 117 0% (0/3) if(pdf_2sample[1] && pdf_2sample[2]) pdf_2sample[1] && pdf_2sample[2] <------1------> <-------2-------> hit | <1> <2> && --------------- 0 | 0 - 0 | - 0 0 | 1 1 137 100% (3/3) if(pdf_2sample[0] && pdf_2sample[1]) pdf_2sample[0] && pdf_2sample[1] <------1------> <-------2-------> hit | <1> <2> && --------------- 1 | 0 - 1 | - 0 1 | 1 1

Module/Entity name: timers_timer2_acg
File name: /home/student/DFund-SBTUSER_6_1_1/Data/SBTBASIC/timer_emc08/verif/timer2_e/rtl_t2/timers_timer2_acg.v
Number of covered expressions: 19 of 20
Number of expr items marked COV: 0
Number of expr items marked IGN: 0

Line Coverage Expression description -------------------------------------------------------------------------------- 75 100% (2/2) if ( !timers_timer2_acg_reset_i_b ) !timers_timer2_acg_reset_i_b <------------1-------------> hit | <1> ! ----------- 1 | 1 1 | 0 117 100% (2/2) if(phy_tooth == 1'b0) phy_tooth == 1'b0 <---1----> <--2--> hit | <1> <2> == ------------------------- 1 | lhs == rhs 1 | lhs != rhs 125 100% (2/2) if(angle_clk == 24'd0) angle_clk == 24'd0 <---1----> <--2---> hit | <1> <2> == ------------------------- 1 | lhs == rhs 1 | lhs != rhs 133 100% (2/2) if(ctrl_tooth == 1'b1) ctrl_tooth == 1'b1 <----1----> <--2--> hit | <1> <2> == ------------------------- 1 | lhs == rhs 1 | lhs != rhs 142 100% (2/2) if(ctrl_tooth == 1'b1) ctrl_tooth == 1'b1 <----1----> <--2--> hit | <1> <2> == ------------------------- 1 | lhs == rhs 1 | lhs != rhs 227 100% (2/2) if(state == STATE_DEC) state == STATE_DEC <-1--> <----2-----> hit | <1> <2> == ------------------------- 1 | lhs == rhs 1 | lhs != rhs 229 100% (2/2) if(!acr_inc) !acr_inc <--1---> hit | <1> ! ----------- 1 | 1 1 | 0 241 100% (2/2) if(state == STATE_INC) state == STATE_INC <-1--> <----2-----> hit | <1> <2> == ------------------------- 1 | lhs == rhs 1 | lhs != rhs 243 100% (2/2) if(!acr_inc) !acr_inc <--1---> hit | <1> ! ----------- 1 | 1 1 | 0 259 50% (1/2) if(acr_aux2[24] == 1'b1) acr_aux2[24] == 1'b1 <-----1-----> <--2--> hit | <1> <2> == ------------------------- 0 | lhs == rhs 1 | lhs != rhs
