pedrofausto/EMC08/ports/design/reports/report_gates.txt

============================================================
  Generated by:           Encounter(R) RTL Compiler v07.20-s009_1
  Generated on:           Oct 01 2010  03:59:04 PM
  Module:                 PORT_TOP
  Technology library:     D_CELLS_MOSLP_typ_1_80V_25C V 2.1.0
  Operating conditions:   TYPICAL (balanced_tree)
  Wireload mode:          enclosed
  Area mode:              timing library
============================================================

 Gate Instances   Area               Library            
--------------------------------------------------------
INX0         32  196.762    D_CELLS_MOSLP_typ_1_80V_25C 
--------------------------------------------------------
total        32  196.762                                

  Type   Instances   Area  Area % 
----------------------------------
inverter        32 196.762  100.0 
----------------------------------
total           32 196.762  100.0
