pedrofausto/EMC08/core/design/docs/FSM/opcodes.ods

Sheet: OPCODES
 |  |  |  |  |  | Cycle 1
Hex Code | Bytes | Mnem. | Operands | Mach. Cycle | Our MC | DC1 | DC2 | EX | WB | Done?
0 | 1 | NOP (http://www.keil.com/support/man/docs/is51/is51_nop.htm) |  | 1 | 1 | - | - | - | ROM – addr do PC+1 | OK
1 | 2 | AJMP (http://www.keil.com/support/man/docs/is51/is51_ajmp.htm) | addr11 | 2 | 1 | ROM – coloca addr do OP1 | ROM - recebe dado do OP1 | PC - Calcula e escreve novo valor do PC | ROM – addr do novo PC | OK
2 | 3 | LJMP (http://www.keil.com/support/man/docs/is51/is51_ljmp.htm) | addr16 | 2 | 1 | ROM – coloca addr do OP1 | ROM - recebe dado do OP1 ROM – coloca addr do OP2 | ROM – recebe dado do OP2 PC – Calcula e Escreve novo valor do PC | ROM – addr do novo PC | OK
3 | 1 | RR (http://www.keil.com/support/man/docs/is51/is51_rr.htm) | A | 1 | 1 | SFR – coloca addr do A | SFR – recebe dado do A | Calcula novo A | SFR – addr do A SFR – data do A (WR) ROM – addr do PC+1 | OK
4 | 1 | INC (http://www.keil.com/support/man/docs/is51/is51_inc.htm) | A | 1 | 1 | SFR – coloca addr do A | SFR – recebe dado do A | Calcula novo A | SFR – addr do A SFR – data do A (WR) ROM – addr do PC+1 | OK | ALU
5 | 2 | INC (http://www.keil.com/support/man/docs/is51/is51_inc.htm) | direct | 1 | 1 | ROM – coloca addr do OP1 | ROM – recebe dado do OP1 RAM/SFR – coloca addr direct | RAM/SFR – recebe dado direct Calcula novo dado do direct | RAM/SFR – addr direct RAM/SFR – dado direct ROM – addr do PC+2 | OK | ALU | op1 – Endereco op2 – Dado direct op_aux_1 – dado direct + 1
6 | 1 | INC (http://www.keil.com/support/man/docs/is51/is51_inc.htm) | @R0 | 1 | 1 | RAM – coloca addr do R0 | RAM – recebe dado do R0 RAM – coloco endereco @R0 | RAM – recebe dado do @R0 calcula novo dado @R0 | RAM – coloca addr @R0 RAM – coloca dado @R0 ROM – addr do PC+1 | OK | ALU
7 | 1 | INC (http://www.keil.com/support/man/docs/is51/is51_inc.htm) | @R1 | 1 | 1 | RAM – coloca addr do R1 | RAM – recebe dado do R1 RAM – coloco endereco @R1 | RAM – recebe dado do @R1 calcula novo dado @R1 | RAM – coloca addr @R01 RAM – coloca dado @R1 ROM – addr do PC+1 | OK | M
8 | 1 | INC (http://www.keil.com/support/man/docs/is51/is51_inc.htm) | R0 | 1 | 1 | - | RAM – coloca addr do Rn | RAM – recebe dado do Rn calcula novo dado Rn | RAM – coloca addr Rn RAM – coloca dado Rn ROM – addr do PC+1 | OK | ALU | op1 – N/A op2 – Dado Rn op_aux_1 – dado Rn + 1
9 | 1 | INC (http://www.keil.com/support/man/docs/is51/is51_inc.htm) | R1 | 1 | 1 | - | RAM – coloca addr do Rn | RAM – recebe dado do Rn calcula novo dado Rn | RAM – coloca addr Rn RAM – coloca dado Rn ROM – addr do PC+1 | OK | ALU | op1 – N/A op2 – Dado Rn op_aux_1 – dado Rn + 2
0A | 1 | INC (http://www.keil.com/support/man/docs/is51/is51_inc.htm) | R2 | 1 | 1 | - | RAM – coloca addr do Rn | RAM – recebe dado do Rn calcula novo dado Rn | RAM – coloca addr Rn RAM – coloca dado Rn ROM – addr do PC+1 | OK | ALU | op1 – N/A op2 – Dado Rn op_aux_1 – dado Rn + 3
0B | 1 | INC (http://www.keil.com/support/man/docs/is51/is51_inc.htm) | R3 | 1 | 1 | - | RAM – coloca addr do Rn | RAM – recebe dado do Rn calcula novo dado Rn | RAM – coloca addr Rn RAM – coloca dado Rn ROM – addr do PC+1 | OK | ALU | op1 – N/A op2 – Dado Rn op_aux_1 – dado Rn + 4
0C | 1 | INC (http://www.keil.com/support/man/docs/is51/is51_inc.htm) | R4 | 1 | 1 | - | RAM – coloca addr do Rn | RAM – recebe dado do Rn calcula novo dado Rn | RAM – coloca addr Rn RAM – coloca dado Rn ROM – addr do PC+1 | OK | ALU | op1 – N/A op2 – Dado Rn op_aux_1 – dado Rn + 5
0D | 1 | INC (http://www.keil.com/support/man/docs/is51/is51_inc.htm) | R5 | 1 | 1 | - | RAM – coloca addr do Rn | RAM – recebe dado do Rn calcula novo dado Rn | RAM – coloca addr Rn RAM – coloca dado Rn ROM – addr do PC+1 | OK | ALU | op1 – N/A op2 – Dado Rn op_aux_1 – dado Rn + 6
0E | 1 | INC (http://www.keil.com/support/man/docs/is51/is51_inc.htm) | R6 | 1 | 1 | - | RAM – coloca addr do Rn | RAM – recebe dado do Rn calcula novo dado Rn | RAM – coloca addr Rn RAM – coloca dado Rn ROM – addr do PC+1 | OK | ALU | op1 – N/A op2 – Dado Rn op_aux_1 – dado Rn + 7
0F | 1 | INC (http://www.keil.com/support/man/docs/is51/is51_inc.htm) | R7 | 1 | 1 | - | RAM – coloca addr do Rn | RAM – recebe dado do Rn calcula novo dado Rn | RAM – coloca addr Rn RAM – coloca dado Rn ROM – addr do PC+1 | OK | ALU | op1 – N/A op2 – Dado Rn op_aux_1 – dado Rn + 8
10 | 3 | JBC (http://www.keil.com/support/man/docs/is51/is51_jbc.htm) | bit, offset | 2 | 1 | ROM – coloca addr do OP1 | ROM - recebe dado do OP1 ROM – coloca addr do OP2 RAM/SFR – coloca addr do OP1 | ROM – recebe dado do OP2 RAM/SFR – recebe dado do OP1 PC - Calcula e escreve novo valor no PC (se necessario) | ROM – addr do novo PC (ou PC+3) *ver se soma 3 de qqr forma Clear bit (if was set) | OK | * offset em complemento de 2
11 | 2 | ACALL (http://www.keil.com/support/man/docs/is51/is51_acall.htm) | addr11 | 2 | 2 | ROM – coloca addr do OP1 SFR – coloca addr do SP | ROM - recebe dado do OP1 SFR – recebe dado do SP | PC = PC + 2 Calcula SP+1 | Seta flag CONTINUA_CICLO RAM – coloca addr do @SP+1 RAM – escreve dado (PC[7-0]) | OK
 |  | CICLO 2 |  |  |  | - | - | PC - Calcula e escreve novo valor do PC Calcula SP+2 | Clear flag CONTINUA_CICLO ROM – addr do novo PC RAM – coloca addr do @SP+2 RAM – escreve dado PC[15-8] SFR – coloca addr do SP SFR – coloca dado do SP (SP+2) | OK | *A10,A9 e A8 são tirados do proprio opcode, por isso que acall existe em várias posicoes
12 | 3 | LCALL (http://www.keil.com/support/man/docs/is51/is51_lcall.htm) | addr16 | 2 | 2 | ROM – coloca addr do OP1 SFR – coloca addr do SP | ROM - recebe dado do OP1 ROM – coloca addr do OP2 SFR – recebe dado do SP | ROM - recebe dado do OP2 Calcula SP+1 Calcula PC+3 (+1) | Seta flag CONTINUA_CICLO RAM – coloca addr do @SP RAM – escreve dado (PC[7-0]) | OK
 |  | CICLO 2 |  |  |  |  |  | PC - Calcula e escreve novo valor do PC Calcula SP+2 |  | OK
13 | 1 | RRC (http://www.keil.com/support/man/docs/is51/is51_rrc.htm) | A | 1 | 1 | SFR – coloca addr do A | SFR – recebe dado do A | Calcula novo A | SFR – addr do A SFR – data do A (WR) ROM – addr do PC+1 | OK | ALU
14 | 1 | DEC (http://www.keil.com/support/man/docs/is51/is51_dec.htm) | A | 1 | 1 | SFR – coloca addr do A | SFR – recebe dado do A | Calcula novo A | SFR – addr do A SFR – data do A (WR) ROM – addr do PC+1 | OK | ALU
15 | 2 | DEC (http://www.keil.com/support/man/docs/is51/is51_dec.htm) | direct | 1 | 1 | ROM – coloca addr do OP1 | ROM – recebe dado do OP1 RAM/SFR – coloca addr direct | RAM/SFR – recebe dado direct Calcula novo dado do direct | RAM/SFR – addr direct RAM/SFR – dado direct ROM – addr do PC+2 | OK | ALU
16 | 1 | DEC (http://www.keil.com/support/man/docs/is51/is51_dec.htm) | @R0 | 1 | 1 | RAM – coloca addr do R0 | RAM – recebe dado do R0 RAM – coloco endereco @R0 | RAM – recebe dado do @R0 calcula novo dado @R0 | RAM – coloca addr @R0 RAM – coloca dado @R0 ROM – addr do PC+1 | OK | ALU
17 | 1 | DEC (http://www.keil.com/support/man/docs/is51/is51_dec.htm) | @R1 | 1 | 1 | RAM – coloca addr do R1 | RAM – recebe dado do R1 RAM – coloco endereco @R1 | RAM – recebe dado do @R1 calcula novo dado @R1 | RAM – coloca addr @R01 RAM – coloca dado @R1 ROM – addr do PC+1 | OK | ALU
18 | 1 | DEC (http://www.keil.com/support/man/docs/is51/is51_dec.htm) | R0 | 1 | 1 | - | RAM – coloca addr do Rn | RAM – recebe dado do Rn calcula novo dado Rn | RAM – coloca addr Rn RAM – coloca dado Rn ROM – addr do PC+1 | OK | ALU
19 | 1 | DEC (http://www.keil.com/support/man/docs/is51/is51_dec.htm) | R1 | 1 | 1 | - | RAM – coloca addr do Rn | RAM – recebe dado do Rn calcula novo dado Rn | RAM – coloca addr Rn RAM – coloca dado Rn ROM – addr do PC+1 | OK | ALU
1A | 1 | DEC (http://www.keil.com/support/man/docs/is51/is51_dec.htm) | R2 | 1 | 1 | - | RAM – coloca addr do Rn | RAM – recebe dado do Rn calcula novo dado Rn | RAM – coloca addr Rn RAM – coloca dado Rn ROM – addr do PC+1 | OK | ALU
1B | 1 | DEC (http://www.keil.com/support/man/docs/is51/is51_dec.htm) | R3 | 1 | 1 | - | RAM – coloca addr do Rn | RAM – recebe dado do Rn calcula novo dado Rn | RAM – coloca addr Rn RAM – coloca dado Rn ROM – addr do PC+1 | OK | ALU
1C | 1 | DEC (http://www.keil.com/support/man/docs/is51/is51_dec.htm) | R4 | 1 | 1 | - | RAM – coloca addr do Rn | RAM – recebe dado do Rn calcula novo dado Rn | RAM – coloca addr Rn RAM – coloca dado Rn ROM – addr do PC+1 | OK | ALU
1D | 1 | DEC (http://www.keil.com/support/man/docs/is51/is51_dec.htm) | R5 | 1 | 1 | - | RAM – coloca addr do Rn | RAM – recebe dado do Rn calcula novo dado Rn | RAM – coloca addr Rn RAM – coloca dado Rn ROM – addr do PC+1 | OK | ALU
1E | 1 | DEC (http://www.keil.com/support/man/docs/is51/is51_dec.htm) | R6 | 1 | 1 | - | RAM – coloca addr do Rn | RAM – recebe dado do Rn calcula novo dado Rn | RAM – coloca addr Rn RAM – coloca dado Rn ROM – addr do PC+1 | OK | ALU
1F | 1 | DEC (http://www.keil.com/support/man/docs/is51/is51_dec.htm) | R7 | 1 | 1 | - | RAM – coloca addr do Rn | RAM – recebe dado do Rn calcula novo dado Rn | RAM – coloca addr Rn RAM – coloca dado Rn ROM – addr do PC+1 | OK | ALU
20 | 3 | JB (http://www.keil.com/support/man/docs/is51/is51_jb.htm) | bit, offset | 2 | 1 | ROM – coloca addr do OP1 | ROM - recebe dado do OP1 ROM – coloca addr do OP2 RAM/SFR – coloca addr do OP1 | ROM – recebe dado do OP2 RAM/SFR – escreve dado no OP1 PC - Calcula e escreve novo valor no PC (se necessario) | ROM – addr do novo PC (ou PC+3) *ver se soma 3 de qqr forma | OK | * offset em complemento de 2
21 | 2 | AJMP (http://www.keil.com/support/man/docs/is51/is51_ajmp.htm) | addr11 | 2 | 2 |  |  |  |  | OK
22 | 1 | RET (http://www.keil.com/support/man/docs/is51/is51_ret.htm) |  | 2 | 2 | SFR – coloca addr do SP | SFR – recebe dado do SP RAM – coloca addr do @SP | RAM – recebe dado do @SP | seta flag CICLO_CONTINUA | OK
 |  | CICLO 2 |  |  |  | RAM- coloca addr do @SP+1 | RAM – recebe addr do @SP+1 | PC – escreve novo valor no PC | clear flag CICLO_CONTINUA ROM – addr do PC+0 | OK
23 | 1 | RL (http://www.keil.com/support/man/docs/is51/is51_rl.htm) | A | 1 | 1 | SFR – coloca addr do A | SFR – recebe dado do A Calcula novo A | Calcula novo A | SFR – addr do A SFR – data do A (WR) ROM – addr do PC+1 | OK
24 | 2 | ADD (http://www.keil.com/support/man/docs/is51/is51_add.htm) | A, #immed | 1 | 1 | ROM – coloca addr do OP1 SFR – coloca addr do A | ROM - recebe dado do OP1 SFR – recebe dado do A | Calcula A + immed | ROM – addr do PC+2 SFR – coloca addr do A SFR – escreve dado no A | OK
25 | 2 | ADD (http://www.keil.com/support/man/docs/is51/is51_add.htm) | A, direct | 1 | 1 | ROM – coloca addr do OP1 SFR – coloca addr do A | ROM - recebe dado do OP1 SFR – recebe dado do A RAM/SFR – coloca addr do @OP1 | RAM/SFR – recebe dado do @OP1 Calcula A + direct | ROM – addr do PC+2 SFR – coloca addr do A SFR – escreve dado no A | OK
26 | 1 | ADD (http://www.keil.com/support/man/docs/is51/is51_add.htm) | A, @R0 | 1 | 1 | SFR – coloca addr do A RAM – coloca addr do R0 | SFR – recebe dado do A RAM – recebe dado do R0 RAM – coloca addr do @R0 | RAM – recebe dado do @R0 Calcula A + @R0 | ROM – addr do PC+1 SFR – coloca addr do A SFR – escreve dado no A | OK
27 | 1 | ADD (http://www.keil.com/support/man/docs/is51/is51_add.htm) | A, @R1 | 1 | 1 | SFR – coloca addr do A RAM – coloca addr do R1 | SFR – recebe dado do A RAM – recebe dado do R1 RAM – coloca addr do @R1 | RAM – recebe dado do @R1 Calcula A + @R1 | ROM – addr do PC+1 SFR – coloca addr do A SFR – escreve dado no A | OK
28 | 1 | ADD (http://www.keil.com/support/man/docs/is51/is51_add.htm) | A, R0 | 1 | 1 | SFR – coloca addr do A | SFR – recebe dado do A RAM – coloca addr do Rn | RAM – recebe dado do Rn Calcula A +Rn | ROM – addr do PC+1 SFR – coloca addr do A SFR – escreve dado no A | OK
29 | 1 | ADD (http://www.keil.com/support/man/docs/is51/is51_add.htm) | A, R1 | 1 | 1 | SFR – coloca addr do A | RAM – coloca addr do Rn | RAM – recebe dado do Rn Calcula A +Rn | ROM – addr do PC+1 SFR – coloca addr do A SFR – escreve dado no A | OK
2A | 1 | ADD (http://www.keil.com/support/man/docs/is51/is51_add.htm) | A, R2 | 1 | 1 | SFR – coloca addr do A | RAM – coloca addr do Rn | RAM – recebe dado do Rn Calcula A +Rn | ROM – addr do PC+1 SFR – coloca addr do A SFR – escreve dado no A | OK
2B | 1 | ADD (http://www.keil.com/support/man/docs/is51/is51_add.htm) | A, R3 | 1 | 1 | SFR – coloca addr do A | RAM – coloca addr do Rn | RAM – recebe dado do Rn Calcula A +Rn | ROM – addr do PC+1 SFR – coloca addr do A SFR – escreve dado no A | OK
2C | 1 | ADD (http://www.keil.com/support/man/docs/is51/is51_add.htm) | A, R4 | 1 | 1 | SFR – coloca addr do A | RAM – coloca addr do Rn | RAM – recebe dado do Rn Calcula A +Rn | ROM – addr do PC+1 SFR – coloca addr do A SFR – escreve dado no A | OK
2D | 1 | ADD (http://www.keil.com/support/man/docs/is51/is51_add.htm) | A, R5 | 1 | 1 | SFR – coloca addr do A | RAM – coloca addr do Rn | RAM – recebe dado do Rn Calcula A +Rn | ROM – addr do PC+1 SFR – coloca addr do A SFR – escreve dado no A | OK
2E | 1 | ADD (http://www.keil.com/support/man/docs/is51/is51_add.htm) | A, R6 | 1 | 1 | SFR – coloca addr do A | RAM – coloca addr do Rn | RAM – recebe dado do Rn Calcula A +Rn | ROM – addr do PC+1 SFR – coloca addr do A SFR – escreve dado no A | OK
2F | 1 | ADD (http://www.keil.com/support/man/docs/is51/is51_add.htm) | A, R7 | 1 | 1 | SFR – coloca addr do A | RAM – coloca addr do Rn | RAM – recebe dado do Rn Calcula A +Rn | ROM – addr do PC+1 SFR – coloca addr do A SFR – escreve dado no A | OK
30 | 3 | JNB (http://www.keil.com/support/man/docs/is51/is51_jnb.htm) | bit, offset | 2 | 1 | ROM – coloca addr do OP1 | ROM - recebe dado do OP1 ROM – coloca addr do OP2 RAM/SFR – coloca addr do OP1 | ROM – recebe dado do OP2 RAM/SFR – escreve dado no OP1 PC - Calcula e escreve novo valor no PC (se necessario) | ROM – addr do novo PC (ou PC+3) *ver se soma 3 de qqr forma | OK | * offset em complemento de 2
31 | 2 | ACALL (http://www.keil.com/support/man/docs/is51/is51_acall.htm) | addr11 | 2 | 2 |  |  |  |  | OK
32 | 1 | RETI (http://www.keil.com/support/man/docs/is51/is51_reti.htm) |  | 2 | 2 | SFR – coloca addr do SP Seta flag CONTINUA_CICLO | SFR – recebe dado do SP RAM – coloca addr do @SP | RAM – recebe dado do @SP | Informa interrupt que terminou (core_fsm_rdy_o) | OK
 |  | CICLO 2 |  |  |  | RAM- coloca addr do @SP-1 | RAM – recebe dado do @SP-1 | PC – escreve novo valor no PC | clear flag CICLO_CONTINUA ROM – addr do PC+0 SFR – coloca addr do SP SFR – escreve dado SP-2 | OK
33 | 1 | RLC (http://www.keil.com/support/man/docs/is51/is51_rlc.htm) | A | 1 | 1 | SFR – coloca addr do A | SFR – recebe dado do A | Calcula novo A | SFR – addr do A SFR – data do A (WR) ROM – addr do PC+1 | OK
34 | 2 | ADDC (http://www.keil.com/support/man/docs/is51/is51_addc.htm) | A, #immed | 1 | 1 | ROM – coloca addr do OP1 SFR – coloca addr do A | SFR – recebe dado do A ROM - recebe dado do OP1 | Calcula A + C + immed | ROM – addr do PC+2 SFR – coloca addr do A SFR – escreve dado no A | OK | *Considerando que o PSW está sendo lido o tempo todo pela FSM
35 | 2 | ADDC (http://www.keil.com/support/man/docs/is51/is51_addc.htm) | A, direct | 1 | 1 | ROM – coloca addr do OP1 SFR – coloca addr do A | ROM - recebe dado do OP1 SFR – recebe dado do A RAM/SFR – coloca addr do @OP1 | Calcula A + direct + C | ROM – addr do PC+2 SFR – coloca addr do A SFR – escreve dado no A | OK
36 | 1 | ADDC (http://www.keil.com/support/man/docs/is51/is51_addc.htm) | A, @R0 | 1 | 1 | SFR – coloca addr do A RAM – coloca addr do R0 | SFR – recebe dado do A RAM – recebe dado do R0 RAM – coloca addr do @R0 | RAM – recebe dado do @R0 Calcula A + @R0 + C | ROM – addr do PC+1 SFR – coloca addr do A SFR – escreve dado no A | OK
37 | 1 | ADDC (http://www.keil.com/support/man/docs/is51/is51_addc.htm) | A, @R1 | 1 | 1 | SFR – coloca addr do A RAM – coloca addr do R1 | SFR – recebe dado do A RAM – recebe dado do R1 RAM – coloca addr do @R1 | RAM – recebe dado do @R1 Calcula A + @R1 + C | ROM – addr do PC+1 SFR – coloca addr do A SFR – escreve dado no A | OK
38 | 1 | ADDC (http://www.keil.com/support/man/docs/is51/is51_addc.htm) | A, R0 | 1 | 1 | SFR – coloca addr do A | SFR – recebe dado do A RAM – coloca addr do Rn | RAM – recebe dado do Rn Calcula A +Rn + C | ROM – addr do PC+1 SFR – coloca addr do A SFR – escreve dado no A | OK
39 | 1 | ADDC (http://www.keil.com/support/man/docs/is51/is51_addc.htm) | A, R1 | 1 | 1 | SFR – coloca addr do A | RAM – coloca addr do Rn | RAM – recebe dado do Rn Calcula A +Rn + C | ROM – addr do PC+1 SFR – coloca addr do A SFR – escreve dado no A | OK
3A | 1 | ADDC (http://www.keil.com/support/man/docs/is51/is51_addc.htm) | A, R2 | 1 | 1 | SFR – coloca addr do A | RAM – coloca addr do Rn | RAM – recebe dado do Rn Calcula A +Rn + C | ROM – addr do PC+1 SFR – coloca addr do A SFR – escreve dado no A | OK
3B | 1 | ADDC (http://www.keil.com/support/man/docs/is51/is51_addc.htm) | A, R3 | 1 | 1 | SFR – coloca addr do A | RAM – coloca addr do Rn | RAM – recebe dado do Rn Calcula A +Rn + C | ROM – addr do PC+1 SFR – coloca addr do A SFR – escreve dado no A | OK
3C | 1 | ADDC (http://www.keil.com/support/man/docs/is51/is51_addc.htm) | A, R4 | 1 | 1 | SFR – coloca addr do A | RAM – coloca addr do Rn | RAM – recebe dado do Rn Calcula A +Rn + C | ROM – addr do PC+1 SFR – coloca addr do A SFR – escreve dado no A | OK
3D | 1 | ADDC (http://www.keil.com/support/man/docs/is51/is51_addc.htm) | A, R5 | 1 | 1 | SFR – coloca addr do A | RAM – coloca addr do Rn | RAM – recebe dado do Rn Calcula A +Rn + C | ROM – addr do PC+1 SFR – coloca addr do A SFR – escreve dado no A | OK
3E | 1 | ADDC (http://www.keil.com/support/man/docs/is51/is51_addc.htm) | A, R6 | 1 | 1 | SFR – coloca addr do A | RAM – coloca addr do Rn | RAM – recebe dado do Rn Calcula A +Rn + C | ROM – addr do PC+1 SFR – coloca addr do A SFR – escreve dado no A | OK
3F | 1 | ADDC (http://www.keil.com/support/man/docs/is51/is51_addc.htm) | A, R7 | 1 | 1 | SFR – coloca addr do A | RAM – coloca addr do Rn | RAM – recebe dado do Rn Calcula A +Rn + C | ROM – addr do PC+1 SFR – coloca addr do A SFR – escreve dado no A | OK
40 | 2 | JC (http://www.keil.com/support/man/docs/is51/is51_jc.htm) | offset | 2 | 1 | ROM – coloca addr do OP1 | ROM - recebe dado do OP1 | PC - Calcula e escreve novo valor no PC (se necessario) | ROM – addr do novo PC (ou PC+2) *ver se soma 2 de qqr forma | OK | * offset em complemento de 2
41 | 2 | AJMP (http://www.keil.com/support/man/docs/is51/is51_ajmp.htm) | addr11 | 2 | 2 |  |  |  |  | OK
42 | 2 | ORL (http://www.keil.com/support/man/docs/is51/is51_orl.htm) | direct, A | 1 | 1 | ROM – coloca addr do OP1 SFR – coloca addr do A | ROM – recebe dado do OP1 SFR – recebe dado do A RAM/SFR – coloca addr do @OP1 | RAM/SFR – recebe dado direct Calcula A OR direct | RAM/SFR – addr direct RAM/SFR – dado direct ROM – addr do PC+2 | OK
43 | 3 | ORL (http://www.keil.com/support/man/docs/is51/is51_orl.htm) | direct, #immed | 2 | 1 | ROM – coloca addr do OP1 | ROM – recebe dado do OP1 ROM – coloca addr do OP2 RAM/SFR – coloca addr do @OP1 | RAM/SFR – recebe dado direct ROM – recebe dado immed Calcula direct OR immed | RAM/SFR – addr direct RAM/SFR – dado direct ROM – addr do PC+3 | OK
44 | 2 | ORL (http://www.keil.com/support/man/docs/is51/is51_orl.htm) | A, #immed | 1 | 1 | ROM – coloca addr do OP1 SFR – coloca addr do A | ROM – recebe dado do OP1 SFR – recebe dado do A | Calcula A OR immed | ROM – addr do PC+2 SFR – coloca addr do A SFR – escreve dado no A | OK
45 | 2 | ORL (http://www.keil.com/support/man/docs/is51/is51_orl.htm) | A, direct | 1 | 1 | ROM – coloca addr do OP1 SFR – coloca addr do A | ROM – recebe dado do OP1 SFR – recebe dado do A RAM/SFR – coloca addr do @OP1 | RAM/SFR – recebe dado direct Calcula A OR direct | ROM – addr do PC+2 SFR – coloca addr do A SFR – escreve dado no A | OK
46 | 1 | ORL (http://www.keil.com/support/man/docs/is51/is51_orl.htm) | A, @R0 | 1 | 1 | SFR – coloca addr do A RAM – coloca addr do R0 | SFR – recebe dado do A RAM – recebe dado do R0 RAM – coloca addr do @R0 | RAM – recebe dado do @R0 Calcula A OR @R0 | ROM – addr do PC+1 SFR – coloca addr do A SFR – escreve dado no A | OK
47 | 1 | ORL (http://www.keil.com/support/man/docs/is51/is51_orl.htm) | A, @R1 | 1 | 1 | SFR – coloca addr do A RAM – coloca addr do R1 | SFR – recebe dado do A RAM – recebe dado do R1 RAM – coloca addr do @R1 | RAM – recebe dado do @R1 Calcula A OR @R1 | ROM – addr do PC+1 SFR – coloca addr do A SFR – escreve dado no A | OK
48 | 1 | ORL (http://www.keil.com/support/man/docs/is51/is51_orl.htm) | A, R0 | 1 | 1 | SFR – coloca addr do A | SFR – recebe dado do A RAM – coloca addr do Rn | RAM – recebe dado do Rn Calcula A OR Rn | ROM – addr do PC+1 SFR – coloca addr do A SFR – escreve dado no A | OK
49 | 1 | ORL (http://www.keil.com/support/man/docs/is51/is51_orl.htm) | A, R1 | 1 | 1 | SFR – coloca addr do A | SFR – recebe dado do A RAM – coloca addr do Rn | RAM – recebe dado do Rn Calcula A OR Rn | ROM – addr do PC+1 SFR – coloca addr do A SFR – escreve dado no A | OK
4A | 1 | ORL (http://www.keil.com/support/man/docs/is51/is51_orl.htm) | A, R2 | 1 | 1 | SFR – coloca addr do A | SFR – recebe dado do A RAM – coloca addr do Rn | RAM – recebe dado do Rn Calcula A OR Rn | ROM – addr do PC+1 SFR – coloca addr do A SFR – escreve dado no A | OK
4B | 1 | ORL (http://www.keil.com/support/man/docs/is51/is51_orl.htm) | A, R3 | 1 | 1 | SFR – coloca addr do A | SFR – recebe dado do A RAM – coloca addr do Rn | RAM – recebe dado do Rn Calcula A OR Rn | ROM – addr do PC+1 SFR – coloca addr do A SFR – escreve dado no A | OK
4C | 1 | ORL (http://www.keil.com/support/man/docs/is51/is51_orl.htm) | A, R4 | 1 | 1 | SFR – coloca addr do A | SFR – recebe dado do A RAM – coloca addr do Rn | RAM – recebe dado do Rn Calcula A OR Rn | ROM – addr do PC+1 SFR – coloca addr do A SFR – escreve dado no A | OK
4D | 1 | ORL (http://www.keil.com/support/man/docs/is51/is51_orl.htm) | A, R5 | 1 | 1 | SFR – coloca addr do A | SFR – recebe dado do A RAM – coloca addr do Rn | RAM – recebe dado do Rn Calcula A OR Rn | ROM – addr do PC+1 SFR – coloca addr do A SFR – escreve dado no A | OK
4E | 1 | ORL (http://www.keil.com/support/man/docs/is51/is51_orl.htm) | A, R6 | 1 | 1 | SFR – coloca addr do A | SFR – recebe dado do A RAM – coloca addr do Rn | RAM – recebe dado do Rn Calcula A OR Rn | ROM – addr do PC+1 SFR – coloca addr do A SFR – escreve dado no A | OK
4F | 1 | ORL (http://www.keil.com/support/man/docs/is51/is51_orl.htm) | A, R7 | 1 | 1 | SFR – coloca addr do A | SFR – recebe dado do A RAM – coloca addr do Rn | RAM – recebe dado do Rn Calcula A OR Rn | ROM – addr do PC+1 SFR – coloca addr do A SFR – escreve dado no A | OK
50 | 2 | JNC (http://www.keil.com/support/man/docs/is51/is51_jnc.htm) | offset | 2 | 1 | ROM – coloca addr do OP1 | ROM - recebe dado do OP1 | PC - Calcula e escreve novo valor no PC (se necessario) | ROM – addr do novo PC (ou PC+2) *ver se soma 2 de qqr forma | OK
51 | 2 | ACALL (http://www.keil.com/support/man/docs/is51/is51_acall.htm) | addr11 | 2 | 2 |  |  |  |  | OK
52 | 2 | ANL (http://www.keil.com/support/man/docs/is51/is51_anl.htm) | direct, A | 1 | 1 | ROM – coloca addr do OP1 SFR – coloca addr do A | ROM – recebe dado do OP1 SFR – recebe dado do A RAM/SFR – coloca addr do @OP1 | RAM/SFR – recebe dado direct Calcula A AND direct | RAM/SFR – addr direct RAM/SFR – dado direct ROM – addr do PC+2 | OK
53 | 3 | ANL (http://www.keil.com/support/man/docs/is51/is51_anl.htm) | direct, #immed | 2 | 1 | ROM – coloca addr do OP1 | ROM – recebe dado do OP1 ROM – coloca addr do OP2 RAM/SFR – coloca addr do @OP1 | RAM/SFR – recebe dado direct ROM – recebe dado immed Calcula direct AND immed | RAM/SFR – addr direct RAM/SFR – dado direct ROM – addr do PC+3 | OK
54 | 2 | ANL (http://www.keil.com/support/man/docs/is51/is51_anl.htm) | A, #immed | 1 | 1 | ROM – coloca addr do OP1 SFR – coloca addr do A | ROM – recebe dado do OP1 SFR – recebe dado do A | Calcula A AND immed | ROM – addr do PC+2 SFR – coloca addr do A SFR – escreve dado no A | OK
55 | 2 | ANL (http://www.keil.com/support/man/docs/is51/is51_anl.htm) | A, direct | 1 | 1 | ROM – coloca addr do OP1 SFR – coloca addr do A | ROM – recebe dado do OP1 SFR – recebe dado do A RAM/SFR – coloca addr do @OP1 | RAM/SFR – recebe dado direct Calcula A AND direct | ROM – addr do PC+2 SFR – coloca addr do A SFR – escreve dado no A | OK
56 | 1 | ANL (http://www.keil.com/support/man/docs/is51/is51_anl.htm) | A, @R0 | 1 | 1 | SFR – coloca addr do A RAM – coloca addr do R0 | SFR – recebe dado do A RAM – recebe dado do R0 RAM – coloca addr do @R0 | RAM – recebe dado do @R0 Calcula A AND @R0 | ROM – addr do PC+1 SFR – coloca addr do A SFR – escreve dado no A | OK
57 | 1 | ANL (http://www.keil.com/support/man/docs/is51/is51_anl.htm) | A, @R1 | 1 | 1 | SFR – coloca addr do A RAM – coloca addr do R1 | SFR – recebe dado do A RAM – recebe dado do R1 RAM – coloca addr do @R1 | RAM – recebe dado do @R1 Calcula A AND @R1 | ROM – addr do PC+1 SFR – coloca addr do A SFR – escreve dado no A | OK
58 | 1 | ANL (http://www.keil.com/support/man/docs/is51/is51_anl.htm) | A, R0 | 1 | 1 | SFR – coloca addr do A | SFR – recebe dado do A RAM – coloca addr do Rn | RAM – recebe dado do Rn Calcula A AND Rn | ROM – addr do PC+1 SFR – coloca addr do A SFR – escreve dado no A | OK
59 | 1 | ANL (http://www.keil.com/support/man/docs/is51/is51_anl.htm) | A, R1 | 1 | 1 | SFR – coloca addr do A | SFR – recebe dado do A RAM – coloca addr do Rn | RAM – recebe dado do Rn Calcula A AND Rn | ROM – addr do PC+1 SFR – coloca addr do A SFR – escreve dado no A | OK
5A | 1 | ANL (http://www.keil.com/support/man/docs/is51/is51_anl.htm) | A, R2 | 1 | 1 | SFR – coloca addr do A | SFR – recebe dado do A RAM – coloca addr do Rn | RAM – recebe dado do Rn Calcula A AND Rn | ROM – addr do PC+1 SFR – coloca addr do A SFR – escreve dado no A | OK
5B | 1 | ANL (http://www.keil.com/support/man/docs/is51/is51_anl.htm) | A, R3 | 1 | 1 | SFR – coloca addr do A | SFR – recebe dado do A RAM – coloca addr do Rn | RAM – recebe dado do Rn Calcula A AND Rn | ROM – addr do PC+1 SFR – coloca addr do A SFR – escreve dado no A | OK
5C | 1 | ANL (http://www.keil.com/support/man/docs/is51/is51_anl.htm) | A, R4 | 1 | 1 | SFR – coloca addr do A | SFR – recebe dado do A RAM – coloca addr do Rn | RAM – recebe dado do Rn Calcula A AND Rn | ROM – addr do PC+1 SFR – coloca addr do A SFR – escreve dado no A | OK
5D | 1 | ANL (http://www.keil.com/support/man/docs/is51/is51_anl.htm) | A, R5 | 1 | 1 | SFR – coloca addr do A | SFR – recebe dado do A RAM – coloca addr do Rn | RAM – recebe dado do Rn Calcula A AND Rn | ROM – addr do PC+1 SFR – coloca addr do A SFR – escreve dado no A | OK
5E | 1 | ANL (http://www.keil.com/support/man/docs/is51/is51_anl.htm) | A, R6 | 1 | 1 | SFR – coloca addr do A | SFR – recebe dado do A RAM – coloca addr do Rn | RAM – recebe dado do Rn Calcula A AND Rn | ROM – addr do PC+1 SFR – coloca addr do A SFR – escreve dado no A | OK
5F | 1 | ANL (http://www.keil.com/support/man/docs/is51/is51_anl.htm) | A, R7 | 1 | 1 | SFR – coloca addr do A | SFR – recebe dado do A RAM – coloca addr do Rn | RAM – recebe dado do Rn Calcula A AND Rn | ROM – addr do PC+1 SFR – coloca addr do A SFR – escreve dado no A | OK
60 | 2 | JZ (http://www.keil.com/support/man/docs/is51/is51_jz.htm) | offset | 2 | 1 | ROM – coloca addr do OP1 SFR – coloca addr do A | ROM – recebe dado do OP1 SFR – recebe dado do A | PC - Calcula e escreve novo valor no PC (se necessario) | ROM – addr do novo PC (ou PC+2) *ver se soma 2 de qqr forma | OK
61 | 2 | AJMP (http://www.keil.com/support/man/docs/is51/is51_ajmp.htm) | addr11 | 2 | 2 |  |  |  |  | OK
62 | 2 | XRL (http://www.keil.com/support/man/docs/is51/is51_xrl.htm) | direct, A | 1 | 1 | ROM – coloca addr do OP1 SFR – coloca addr do A | ROM – recebe dado do OP1 SFR – recebe dado do A RAM/SFR – coloca addr do @OP1 | RAM/SFR – recebe dado direct Calcula A XOR direct | RAM/SFR – addr direct RAM/SFR – dado direct ROM – addr do PC+2 | OK
63 | 3 | XRL (http://www.keil.com/support/man/docs/is51/is51_xrl.htm) | direct, #immed | 2 | 1 | ROM – coloca addr do OP1 | ROM – recebe dado do OP1 ROM – coloca addr do OP2 RAM/SFR – coloca addr do @OP1 | RAM/SFR – recebe dado direct ROM – recebe dado immed Calcula direct XOR immed | RAM/SFR – addr direct RAM/SFR – dado direct ROM – addr do PC+3 | OK
64 | 2 | XRL (http://www.keil.com/support/man/docs/is51/is51_xrl.htm) | A, #immed | 1 | 1 | ROM – coloca addr do OP1 SFR – coloca addr do A | ROM – recebe dado do OP1 SFR – recebe dado do A | Calcula A XOR immed | ROM – addr do PC+2 SFR – coloca addr do A SFR – escreve dado no A | OK
65 | 2 | XRL (http://www.keil.com/support/man/docs/is51/is51_xrl.htm) | A, direct | 1 | 1 | ROM – coloca addr do OP1 SFR – coloca addr do A | ROM – recebe dado do OP1 SFR – recebe dado do A RAM/SFR – coloca addr do @OP1 | RAM/SFR – recebe dado direct Calcula A XOR direct | ROM – addr do PC+2 SFR – coloca addr do A SFR – escreve dado no A | OK
66 | 1 | XRL (http://www.keil.com/support/man/docs/is51/is51_xrl.htm) | A, @R0 | 1 | 1 | SFR – coloca addr do A RAM – coloca addr do R0 | SFR – recebe dado do A RAM – recebe dado do R0 RAM – coloca addr do @R0 | RAM – recebe dado do @R0 Calcula A XOR @R0 | ROM – addr do PC+1 SFR – coloca addr do A SFR – escreve dado no A | OK
67 | 1 | XRL (http://www.keil.com/support/man/docs/is51/is51_xrl.htm) | A, @R1 | 1 | 1 | SFR – coloca addr do A RAM – coloca addr do R1 | SFR – recebe dado do A RAM – recebe dado do R1 RAM – coloca addr do @R1 | RAM – recebe dado do @R1 Calcula A XOR @R1 | ROM – addr do PC+1 SFR – coloca addr do A SFR – escreve dado no A | OK
68 | 1 | XRL (http://www.keil.com/support/man/docs/is51/is51_xrl.htm) | A, R0 | 1 | 1 | SFR – coloca addr do A | SFR – recebe dado do A RAM – coloca addr do Rn | RAM – recebe dado do Rn Calcula A XOR Rn | ROM – addr do PC+1 SFR – coloca addr do A SFR – escreve dado no A | OK
69 | 1 | XRL (http://www.keil.com/support/man/docs/is51/is51_xrl.htm) | A, R1 | 1 | 1 | SFR – coloca addr do A | SFR – recebe dado do A RAM – coloca addr do Rn | RAM – recebe dado do Rn Calcula A XOR Rn | ROM – addr do PC+1 SFR – coloca addr do A SFR – escreve dado no A | OK
6A | 1 | XRL (http://www.keil.com/support/man/docs/is51/is51_xrl.htm) | A, R2 | 1 | 1 | SFR – coloca addr do A | SFR – recebe dado do A RAM – coloca addr do Rn | RAM – recebe dado do Rn Calcula A XOR Rn | ROM – addr do PC+1 SFR – coloca addr do A SFR – escreve dado no A | OK
6B | 1 | XRL (http://www.keil.com/support/man/docs/is51/is51_xrl.htm) | A, R3 | 1 | 1 | SFR – coloca addr do A | SFR – recebe dado do A RAM – coloca addr do Rn | RAM – recebe dado do Rn Calcula A XOR Rn | ROM – addr do PC+1 SFR – coloca addr do A SFR – escreve dado no A | OK
6C | 1 | XRL (http://www.keil.com/support/man/docs/is51/is51_xrl.htm) | A, R4 | 1 | 1 | SFR – coloca addr do A | SFR – recebe dado do A RAM – coloca addr do Rn | RAM – recebe dado do Rn Calcula A XOR Rn | ROM – addr do PC+1 SFR – coloca addr do A SFR – escreve dado no A | OK
6D | 1 | XRL (http://www.keil.com/support/man/docs/is51/is51_xrl.htm) | A, R5 | 1 | 1 | SFR – coloca addr do A | SFR – recebe dado do A RAM – coloca addr do Rn | RAM – recebe dado do Rn Calcula A XOR Rn | ROM – addr do PC+1 SFR – coloca addr do A SFR – escreve dado no A | OK
6E | 1 | XRL (http://www.keil.com/support/man/docs/is51/is51_xrl.htm) | A, R6 | 1 | 1 | SFR – coloca addr do A | SFR – recebe dado do A RAM – coloca addr do Rn | RAM – recebe dado do Rn Calcula A XOR Rn | ROM – addr do PC+1 SFR – coloca addr do A SFR – escreve dado no A | OK
6F | 1 | XRL (http://www.keil.com/support/man/docs/is51/is51_xrl.htm) | A, R7 | 1 | 1 | SFR – coloca addr do A | SFR – recebe dado do A RAM – coloca addr do Rn | RAM – recebe dado do Rn Calcula A XOR Rn | ROM – addr do PC+1 SFR – coloca addr do A SFR – escreve dado no A | OK
70 | 2 | JNZ (http://www.keil.com/support/man/docs/is51/is51_jnz.htm) | offset | 2 | 2 | ROM – coloca addr do OP1 SFR – coloca addr do A | ROM – recebe dado do OP1 SFR – recebe dado do A | PC - Calcula e escreve novo valor no PC (se necessario) | ROM – addr do novo PC (ou PC+2) *ver se soma 2 de qqr forma | OK
71 | 2 | ACALL (http://www.keil.com/support/man/docs/is51/is51_acall.htm) | addr11 | 2 | 2 |  |  |  |  | OK
72 | 2 | ORL (http://www.keil.com/support/man/docs/is51/is51_orl.htm) | C, bit | 2 | 1 | ROM – coloca addr do OP1 | ROM – recebe dado do OP1 RAM/SFR – coloca addr do @OP1 | RAM/SFR – recebe dado bit Calcula C OR bit | SFR - addr C (PSW) SFR - dado C (PSW) ROM – addr do PC+2 | OK
73 | 1 | JMP (http://www.keil.com/support/man/docs/is51/is51_jmp.htm) | @A+DPTR | 2 | 2 | SFR – coloca addr do A | SFR – recebe dado do A SFR – coloca addr do DPL | SFR – recebe dado do DPL Calcula DPL temporario | SFR – coloca addr do DPH | OK
 |  | CICLO 2 |  |  |  | SFR – recebe dado do DPH | Calcula e DPH temporario | ROM – addr do novo PC | PC + 1 | OK
74 | 2 | MOV (http://www.keil.com/support/man/docs/is51/is51_mov.htm) | A, #immed | 1 | 1 | ROM – coloca addr do OP1 | ROM – recebe dado do OP1 | - | ROM – addr do PC+2 SFR – coloca addr do A SFR – escreve dado no A | OK
75 | 3 | MOV (http://www.keil.com/support/man/docs/is51/is51_mov.htm) | direct, #immed | 2 | 1 | ROM – coloca addr do OP1 | ROM - recebe dado do OP1 ROM – coloca addr do OP2 | ROM – recebe dado do OP2 | ROM – addr do PC+3 RAM/SFR – addr do @OP1 RAM/SFR – dado do OP2 | OK
76 | 2 | MOV (http://www.keil.com/support/man/docs/is51/is51_mov.htm) | @R0, #immed | 2 | 1 | RAM – coloca addr do Ri | ROM – coloca addr do OP1 RAM – recebe dado do Ri | ROM – recebe dado do OP1 | ROM – addr do PC+2 RAM – addr do @Ri RAM – dado do @Ri | OK
77 | 2 | MOV (http://www.keil.com/support/man/docs/is51/is51_mov.htm) | @R1, #immed | 2 | 1 | RAM – coloca addr do Ri | ROM – coloca addr do OP1 RAM – recebe dado do Ri | ROM – recebe dado do OP1 | ROM – addr do PC+2 RAM – addr do @Ri RAM – dado do @Ri | OK
78 | 2 | MOV (http://www.keil.com/support/man/docs/is51/is51_mov.htm) | R0, #immed | 1 | 1 |  | ROM – coloca addr do OP1 | ROM – recebe dado do OP1 | ROM – addr do PC+2 RAM – addr do Rn RAM – dado do Rn | OK
79 | 2 | MOV (http://www.keil.com/support/man/docs/is51/is51_mov.htm) | R1, #immed | 1 | 1 |  | ROM – coloca addr do OP1 | ROM – recebe dado do OP1 | ROM – addr do PC+2 RAM – addr do Rn RAM – dado do Rn | OK
7A | 2 | MOV (http://www.keil.com/support/man/docs/is51/is51_mov.htm) | R2, #immed | 1 | 1 |  | ROM – coloca addr do OP1 | ROM – recebe dado do OP1 | ROM – addr do PC+2 RAM – addr do Rn RAM – dado do Rn | OK
7B | 2 | MOV (http://www.keil.com/support/man/docs/is51/is51_mov.htm) | R3, #immed | 1 | 1 |  | ROM – coloca addr do OP1 | ROM – recebe dado do OP1 | ROM – addr do PC+2 RAM – addr do Rn RAM – dado do Rn | OK
7C | 2 | MOV (http://www.keil.com/support/man/docs/is51/is51_mov.htm) | R4, #immed | 1 | 1 |  | ROM – coloca addr do OP1 | ROM – recebe dado do OP1 | ROM – addr do PC+2 RAM – addr do Rn RAM – dado do Rn | OK
7D | 2 | MOV (http://www.keil.com/support/man/docs/is51/is51_mov.htm) | R5, #immed | 1 | 1 |  | ROM – coloca addr do OP1 | ROM – recebe dado do OP1 | ROM – addr do PC+2 RAM – addr do Rn RAM – dado do Rn | OK
7E | 2 | MOV (http://www.keil.com/support/man/docs/is51/is51_mov.htm) | R6, #immed | 1 | 1 |  | ROM – coloca addr do OP1 | ROM – recebe dado do OP1 | ROM – addr do PC+2 RAM – addr do Rn RAM – dado do Rn | OK
7F | 2 | MOV (http://www.keil.com/support/man/docs/is51/is51_mov.htm) | R7, #immed | 1 | 1 |  | ROM – coloca addr do OP1 | ROM – recebe dado do OP1 | ROM – addr do PC+2 RAM – addr do Rn RAM – dado do Rn | OK
80 | 2 | SJMP (http://www.keil.com/support/man/docs/is51/is51_sjmp.htm) | offset | 2 | 1 | ROM – coloca addr do OP1 | ROM - recebe dado do OP1 | PC - Calcula e escreve novo valor no PC | ROM – addr do novo PC (ou PC+2) *ver se soma 2 de qqr forma | OK
81 | 2 | AJMP (http://www.keil.com/support/man/docs/is51/is51_ajmp.htm) | addr11 | 2 | 2 |  |  |  |  | OK
82 | 2 | ANL (http://www.keil.com/support/man/docs/is51/is51_anl.htm) | C, bit | 2 | 1 | ROM – coloca addr do OP1 | ROM – recebe dado do OP1 RAM/SFR – coloca addr do @OP1 | RAM/SFR – recebe dado bit Calcula C AND bit | SFR - addr C (PSW) SFR - dado C (PSW) ROM – addr do PC+2 | OK
83 | 1 | MOVC (http://www.keil.com/support/man/docs/is51/is51_movc.htm) | A, @A+PC | 2 | 2 | SFR – coloca addr do A (comb.) op1 – guarda LSB (seq.) SFR – recebe dado do A (seq.) | Calcula LSB + A (comb.) Op_aux_2 – resultado LSB + A (seq.) Op2 – guarda MSB (seq.) |  | Calcula MSB + C (comb.) op_aux_2_2 – MSB + C (seq.) | OK
 |  | CICLO 2 |  |  |  | PCAU – coloca PC (op_aux_2_2,op_aux_2) (comb.) | ROM – pede dado apontado por PC (comb.) ROM – recebe dado no op_aux_2 (seq.) | Recupera PC (op2,op1) - (MSB, LSB) | SFR – escreve dado da ROM no Acc ROM – addr do PC+1 | OK
84 | 1 | DIV (http://www.keil.com/support/man/docs/is51/is51_div.htm) | AB | 4 | 2 | SFR – coloca addr do A (comb.) SFR – recebe dado do A (seq.) | SFR – coloca addr do B (comb.) SFR – recebe dado do B (seq.) | Calcula A/B (comb.) op1 – fsm_alu_result [15:8] (seq.) Op_aux_1 – fsm_alu_result [7:0] (seq.) | seta flag CICLO_CONTINUA SFR – coloca addr do A SFR – escreve dado no A | OK
 |  | CICLO 2 |  |  |  | - | - | - | clear flag CICLO_CONTINUA ROM – addr do PC+1 SFR – coloca addr do B SFR – escreve dado no B | OK
85 | 3 | MOV (http://www.keil.com/support/man/docs/is51/is51_mov.htm) | direct, direct | 2 | 1 | ROM – coloca addr do OP1 | ROM - recebe dado do OP1 ROM – coloca addr do OP2 RAM/SFR – coloca addr do OP1 | ROM – recebe dado do OP2 RAM/SFR – recebe dado do OP1 | ROM – addr do PC+3 RAM/SFR – addr do @OP2 RAM/SFR – dado do OP1 | OK
86 | 2 | MOV (http://www.keil.com/support/man/docs/is51/is51_mov.htm) | direct, @R0 | 2 | 1 | ROM – coloca addr do OP1 RAM – coloca addr do Ri | ROM – recebe dado do OP1 RAM – recebe dado do Ri RAM – coloca addr do @Ri | RAM – recebe dado do @Ri | ROM – addr do PC+2 RAM – addr do direct RAM – dado do @Ri | OK
87 | 2 | MOV (http://www.keil.com/support/man/docs/is51/is51_mov.htm) | direct, @R1 | 2 | 1 | ROM – coloca addr do OP1 RAM – coloca addr do Ri | ROM – recebe dado do OP1 RAM – recebe dado do Ri RAM – coloca addr do @Ri | RAM – recebe dado do @Ri | ROM – addr do PC+2 RAM – addr do direct RAM – dado do @Ri | OK
88 | 2 | MOV (http://www.keil.com/support/man/docs/is51/is51_mov.htm) | direct, R0 | 2 | 1 | ROM – coloca addr do OP1 RAM – coloca addr do Rn | ROM – recebe dado do OP1 RAM – recebe dado do Rn | - | ROM – addr do PC+2 RAM/SFR – addr do direct RAM/SFR – dado do Rn | OK
89 | 2 | MOV (http://www.keil.com/support/man/docs/is51/is51_mov.htm) | direct, R1 | 2 | 1 | ROM – coloca addr do OP1 RAM – coloca addr do Rn | ROM – recebe dado do OP1 RAM – recebe dado do Rn | - | ROM – addr do PC+2 RAM/SFR – addr do direct RAM/SFR – dado do Rn | OK
8A | 2 | MOV (http://www.keil.com/support/man/docs/is51/is51_mov.htm) | direct, R2 | 2 | 1 | ROM – coloca addr do OP1 RAM – coloca addr do Rn | ROM – recebe dado do OP1 RAM – recebe dado do Rn | - | ROM – addr do PC+2 RAM/SFR – addr do direct RAM/SFR – dado do Rn | OK
8B | 2 | MOV (http://www.keil.com/support/man/docs/is51/is51_mov.htm) | direct, R3 | 2 | 1 | ROM – coloca addr do OP1 RAM – coloca addr do Rn | ROM – recebe dado do OP1 RAM – recebe dado do Rn | - | ROM – addr do PC+2 RAM/SFR – addr do direct RAM/SFR – dado do Rn | OK
8C | 2 | MOV (http://www.keil.com/support/man/docs/is51/is51_mov.htm) | direct, R4 | 2 | 1 | ROM – coloca addr do OP1 RAM – coloca addr do Rn | ROM – recebe dado do OP1 RAM – recebe dado do Rn | - | ROM – addr do PC+2 RAM/SFR – addr do direct RAM/SFR – dado do Rn | OK
8D | 2 | MOV (http://www.keil.com/support/man/docs/is51/is51_mov.htm) | direct, R5 | 2 | 1 | ROM – coloca addr do OP1 RAM – coloca addr do Rn | ROM – recebe dado do OP1 RAM – recebe dado do Rn | - | ROM – addr do PC+2 RAM/SFR – addr do direct RAM/SFR – dado do Rn | OK
8E | 2 | MOV (http://www.keil.com/support/man/docs/is51/is51_mov.htm) | direct, R6 | 2 | 1 | ROM – coloca addr do OP1 RAM – coloca addr do Rn | ROM – recebe dado do OP1 RAM – recebe dado do Rn | - | ROM – addr do PC+2 RAM/SFR – addr do direct RAM/SFR – dado do Rn | OK
8F | 2 | MOV (http://www.keil.com/support/man/docs/is51/is51_mov.htm) | direct, R7 | 2 | 1 | ROM – coloca addr do OP1 RAM – coloca addr do Rn | ROM – recebe dado do OP1 RAM – recebe dado do Rn | - | ROM – addr do PC+2 RAM/SFR – addr do direct RAM/SFR – dado do Rn | OK
90 | 3 | MOV (http://www.keil.com/support/man/docs/is51/is51_mov.htm) | DPTR, #immed | 2 | 1 | ROM – coloca addr do OP1 (comb) ROM – recebe dado do OP1 (seq) | ROM – coloca addr do OP2 (comb.) SFR – addr DPH e dado OP1 (comb.) ROM – recebe dado do OP2 (seq) | - | SFR – addr DPL e dado DPL (comb) | OK
91 | 2 | ACALL (http://www.keil.com/support/man/docs/is51/is51_acall.htm) | addr11 | 2 | 2 |  |  |  |  | OK
92 | 2 | MOV (http://www.keil.com/support/man/docs/is51/is51_mov.htm) | bit, C | 2 | 1 | ROM – coloca addr do OP1 (comb) SFR – coloca addr do CY (comb) ROM – recebe addr bit em op1 SFR – recebe dado CY em op_aux_1 | SFR/RAM – coloca addr de op1 (comb) SFR/RAM – recebe dado em op2 (seq) | Calcula A + Direct (comb) op_aux_1 recebe novo dado (seq) | ROM – addr do PC+2 RAM/SFR – addr do bit RAM/SFR – escreve dado do C no bit | OK
93 | 1 | MOVC (http://www.keil.com/support/man/docs/is51/is51_movc.htm) | A, @A+DPTR | 2 | 2 | SFR – coloca addr do A ROM – PC + 1 | SFR – recebe dado do A SFR – coloca addr do DPL | SFR – recebe dado do DPL Calcula DPL + A Armazena LSB | Armazena MSB Recebe DPL + A SFR – coloca dado do DPH set flag CONTINUA_CICLO | OK
 |  | CICLO 2 |  |  |  | SFR – recebe dado do DPH ALU – Calcula DPH + C | ALU – recebe DPH + C ROM – coloca direto addr A+DPTR | ROM – recebe dado A+DPTR | Clear flag CONTINUA_CICLO SFR – coloca addr do A SFR – coloca dado @A+DPTR no A ROM – addr do PC+1 | OK
94 | 2 | SUBB (http://www.keil.com/support/man/docs/is51/is51_subb.htm) | A, #immed | 1 | 1 | ROM – coloca addr do OP1 SFR – coloca addr do A | ROM – recebe dado do OP1 SFR – recebe dado do A | Calcula A – C – immed | ROM – addr do PC+2 SFR – coloca addr do A SFR – escreve dado no A | OK
95 | 2 | SUBB (http://www.keil.com/support/man/docs/is51/is51_subb.htm) | A, direct | 1 | 1 | ROM – coloca addr do OP1 SFR – coloca addr do A | ROM – recebe dado do OP1 SFR – recebe dado do A RAM/SFR – coloca addr do @OP1 | RAM/SFR – recebe dado do @OP1 Calcula A – C – (direct) | ROM – addr do PC+2 SFR – coloca addr do A SFR – escreve dado no A | OK
96 | 1 | SUBB (http://www.keil.com/support/man/docs/is51/is51_subb.htm) | A, @R0 | 1 | 1 | SFR – coloca addr do A RAM – coloca addr do Ri | SFR – recebe dado do A RAM – recebe dado do Ri RAM – coloca addr do @Ri | RAM – recebe dado do @Ri Calcula A – C - @Ri | ROM – addr do PC+1 SFR – coloca addr do A SFR – escreve dado no A | OK
97 | 1 | SUBB (http://www.keil.com/support/man/docs/is51/is51_subb.htm) | A, @R1 | 1 | 1 | SFR – coloca addr do A RAM – coloca addr do Ri | SFR – recebe dado do A RAM – recebe dado do Ri RAM – coloca addr do @Ri | RAM – recebe dado do @Ri Calcula A – C - @Ri | ROM – addr do PC+1 SFR – coloca addr do A SFR – escreve dado no A | OK
98 | 1 | SUBB (http://www.keil.com/support/man/docs/is51/is51_subb.htm) | A, R0 | 1 | 1 | SFR – coloca addr do A | SFR – recebe dado do A RAM – coloca addr do Rn | RAM – recebe dado do Rn Calcula A – C – Rn | ROM – addr do PC+1 SFR – coloca addr do A SFR – escreve dado no A | OK
99 | 1 | SUBB (http://www.keil.com/support/man/docs/is51/is51_subb.htm) | A, R1 | 1 | 1 | SFR – coloca addr do A | SFR – recebe dado do A RAM – coloca addr do Rn | RAM – recebe dado do Rn Calcula A – C – Rn | ROM – addr do PC+1 SFR – coloca addr do A SFR – escreve dado no A | OK
9A | 1 | SUBB (http://www.keil.com/support/man/docs/is51/is51_subb.htm) | A, R2 | 1 | 1 | SFR – coloca addr do A | SFR – recebe dado do A RAM – coloca addr do Rn | RAM – recebe dado do Rn Calcula A – C – Rn | ROM – addr do PC+1 SFR – coloca addr do A SFR – escreve dado no A | OK
9B | 1 | SUBB (http://www.keil.com/support/man/docs/is51/is51_subb.htm) | A, R3 | 1 | 1 | SFR – coloca addr do A | SFR – recebe dado do A RAM – coloca addr do Rn | RAM – recebe dado do Rn Calcula A – C – Rn | ROM – addr do PC+1 SFR – coloca addr do A SFR – escreve dado no A | OK
9C | 1 | SUBB (http://www.keil.com/support/man/docs/is51/is51_subb.htm) | A, R4 | 1 | 1 | SFR – coloca addr do A | SFR – recebe dado do A RAM – coloca addr do Rn | RAM – recebe dado do Rn Calcula A – C – Rn | ROM – addr do PC+1 SFR – coloca addr do A SFR – escreve dado no A | OK
9D | 1 | SUBB (http://www.keil.com/support/man/docs/is51/is51_subb.htm) | A, R5 | 1 | 1 | SFR – coloca addr do A | SFR – recebe dado do A RAM – coloca addr do Rn | RAM – recebe dado do Rn Calcula A – C – Rn | ROM – addr do PC+1 SFR – coloca addr do A SFR – escreve dado no A | OK
9E | 1 | SUBB (http://www.keil.com/support/man/docs/is51/is51_subb.htm) | A, R6 | 1 | 1 | SFR – coloca addr do A | SFR – recebe dado do A RAM – coloca addr do Rn | RAM – recebe dado do Rn Calcula A – C – Rn | ROM – addr do PC+1 SFR – coloca addr do A SFR – escreve dado no A | OK
9F | 1 | SUBB (http://www.keil.com/support/man/docs/is51/is51_subb.htm) | A, R7 | 1 | 1 | SFR – coloca addr do A | SFR – recebe dado do A RAM – coloca addr do Rn | RAM – recebe dado do Rn Calcula A – C – Rn | ROM – addr do PC+1 SFR – coloca addr do A SFR – escreve dado no A | OK
A0 | 2 | ORL (http://www.keil.com/support/man/docs/is51/is51_orl.htm) | C, /bit | 2 | 1 | ROM – coloca addr do OP1 | ROM – recebe dado do OP1 RAM/SFR – coloca addr do @OP1 | RAM/SFR – recebe dado bit Calcula C OR ~bit | SFR - addr C (PSW) SFR - dado C (PSW) ROM – addr do PC+2 | OK
A1 | 2 | AJMP (http://www.keil.com/support/man/docs/is51/is51_ajmp.htm) | addr11 | 2 | 2 |  |  |  |  | OK
A2 | 2 | MOV (http://www.keil.com/support/man/docs/is51/is51_mov.htm) | C, bit | 1 | 1 | ROM – coloca addr do OP1 | ROM – recebe dado do OP1 RAM/SFR – coloca addr do @OP1 | RAM/SFR – recebe dado bit | SFR - addr C (PSW) RAM – dado do bit no C (PSW) ROM – addr do PC+2 | OK
A3 | 1 | INC (http://www.keil.com/support/man/docs/is51/is51_inc.htm) | DPTR | 2 | 2 | SFR – coloca addr do DPL | SFR – recebe dado do DPL | Calcula DPL + 1 | Seta flag CICLO_CONTINUA SFR – addr do DPL SFR – escreve dado no DPL | OK
 |  | CICLO 2 |  |  |  | SFR – coloca addr do DPH | SFR – recebe dado do DPH | Calcula DPH + C | clear flag CICLO_CONTINUA ROM – addr do PC+1 SFR – coloca addr do DPH SFR – escreve dado no DPH | OK
A4 | 1 | MUL (http://www.keil.com/support/man/docs/is51/is51_mul.htm) | AB | 4 | 2 | SFR – coloca addr do A (comb.) SFR – recebe dado do A (seq.) | SFR – coloca addr do B (comb.) SFR – recebe dado do B (seq.) | Calcula A*B (comb.) op1 – fsm_alu_result [15:8] (seq.) Op_aux_1 – fsm_alu_result [7:0] (seq.) | seta flag CICLO_CONTINUA SFR – coloca addr do A SFR – escreve dado no A | OK
 |  | CICLO 2 |  |  |  | - | - | - | clear flag CICLO_CONTINUA ROM – addr do PC+1 SFR – coloca addr do B SFR – escreve dado no B | OK
A5 |  | reserved |  |  |  |  |  |  |  | OK
A6 | 2 | MOV (http://www.keil.com/support/man/docs/is51/is51_mov.htm) | @R0, direct | 2 | 1 | ROM – coloca addr do OP1 RAM – coloca addr do Ri | ROM – recebe dado do OP1 RAM – recebe dado do Ri RAM/SFR – coloca addr do @OP1 | RAM/SFR – recebe dado do @OP1 | ROM – addr do PC+2 RAM – addr do @Ri RAM – dado do direct | OK
A7 | 2 | MOV (http://www.keil.com/support/man/docs/is51/is51_mov.htm) | @R1, direct | 2 | 1 | ROM – coloca addr do OP1 RAM – coloca addr do Ri | ROM – recebe dado do OP1 RAM – recebe dado do Ri RAM/SFR – coloca addr do @OP1 | RAM/SFR – recebe dado do @OP1 | ROM – addr do PC+2 RAM – addr do @Ri RAM – dado do direct | OK
A8 | 2 | MOV (http://www.keil.com/support/man/docs/is51/is51_mov.htm) | R0, direct | 2 | 1 | ROM – coloca addr do OP1 | ROM - recebe dado do OP1 RAM/SFR – coloca addr do OP1 | RAM/SFR – recebe dado do OP1 | ROM – addr do PC+2 RAM– addr do Rn RAM – dado do direct | OK
A9 | 2 | MOV (http://www.keil.com/support/man/docs/is51/is51_mov.htm) | R1, direct | 2 | 1 | ROM – coloca addr do OP1 | ROM - recebe dado do OP1 RAM/SFR – coloca addr do OP1 | RAM/SFR – recebe dado do OP1 | ROM – addr do PC+2 RAM– addr do Rn RAM – dado do direct | OK
AA | 2 | MOV (http://www.keil.com/support/man/docs/is51/is51_mov.htm) | R2, direct | 2 | 1 | ROM – coloca addr do OP1 | ROM - recebe dado do OP1 RAM/SFR – coloca addr do OP1 | RAM/SFR – recebe dado do OP1 | ROM – addr do PC+2 RAM– addr do Rn RAM – dado do direct | OK
AB | 2 | MOV (http://www.keil.com/support/man/docs/is51/is51_mov.htm) | R3, direct | 2 | 1 | ROM – coloca addr do OP1 | ROM - recebe dado do OP1 RAM/SFR – coloca addr do OP1 | RAM/SFR – recebe dado do OP1 | ROM – addr do PC+2 RAM– addr do Rn RAM – dado do direct | OK
AC | 2 | MOV (http://www.keil.com/support/man/docs/is51/is51_mov.htm) | R4, direct | 2 | 1 | ROM – coloca addr do OP1 | ROM - recebe dado do OP1 RAM/SFR – coloca addr do OP1 | RAM/SFR – recebe dado do OP1 | ROM – addr do PC+2 RAM– addr do Rn RAM – dado do direct | OK
AD | 2 | MOV (http://www.keil.com/support/man/docs/is51/is51_mov.htm) | R5, direct | 2 | 1 | ROM – coloca addr do OP1 | ROM - recebe dado do OP1 RAM/SFR – coloca addr do OP1 | RAM/SFR – recebe dado do OP1 | ROM – addr do PC+2 RAM– addr do Rn RAM – dado do direct | OK
AE | 2 | MOV (http://www.keil.com/support/man/docs/is51/is51_mov.htm) | R6, direct | 2 | 1 | ROM – coloca addr do OP1 | ROM - recebe dado do OP1 RAM/SFR – coloca addr do OP1 | RAM/SFR – recebe dado do OP1 | ROM – addr do PC+2 RAM– addr do Rn RAM – dado do direct | OK
AF | 2 | MOV (http://www.keil.com/support/man/docs/is51/is51_mov.htm) | R7, direct | 2 | 1 | ROM – coloca addr do OP1 | ROM - recebe dado do OP1 RAM/SFR – coloca addr do OP1 | RAM/SFR – recebe dado do OP1 | ROM – addr do PC+2 RAM– addr do Rn RAM – dado do direct | OK
B0 | 2 | ANL (http://www.keil.com/support/man/docs/is51/is51_anl.htm) | C, /bit | 2 | 1 | ROM – coloca addr do OP1 | ROM – recebe dado do OP1 RAM/SFR – coloca addr do @OP1 | RAM/SFR – recebe dado bit Calcula C AND ~bit | SFR - addr C (PSW) SFR - dado C (PSW) ROM – addr do PC+2 | OK
B1 | 2 | ACALL (http://www.keil.com/support/man/docs/is51/is51_acall.htm) | addr11 | 2 | 2 |  |  |  |  | OK
B2 | 2 | CPL (http://www.keil.com/support/man/docs/is51/is51_cpl.htm) | bit | 1 | 1 | ROM – coloca addr do OP1 | ROM - recebe dado do OP1 RAM/SFR – coloca addr do @OP1 | RAM/SFR – recebe dado bit Calcula ~bit | ROM – addr do PC+2 RAM/SFR – addr do bit RAM/SFR – dado do bit | OK
B3 | 1 | CPL (http://www.keil.com/support/man/docs/is51/is51_cpl.htm) | C | 1 | 1 | - | - | Calcula ~C | SFR - addr C (PSW) SFR - dado C (PSW) ROM – addr do PC+1 | OK
B4 | 3 | CJNE (http://www.keil.com/support/man/docs/is51/is51_cjne.htm) | A, #immed, offset | 2 | 2 | ROM – coloca addr do OP1 SFR – coloca addr do A | ROM – recebe dado do OP1 SFR – recebe dado do A ROM – coloca addr do OP2 | ROM – recebe dado do OP2 Calcula A == immed | ALU – recebe dado do compare ROM – addr do novo PC (ou PC+2) seta flag CICLO_CONTINUA | OK | *ALU faz comparacao e seta Carry
 |  | CICLO 2 |  |  |  |  |  |  | Clear flag CICLO_CONTINUA ROM – (PC+3) | OK
B5 | 3 | CJNE (http://www.keil.com/support/man/docs/is51/is51_cjne.htm) | A, direct, offset | 2 | 2 | ROM – coloca addr do OP1 SFR – coloca addr do A | ROM – recebe dado do OP1 SFR – recebe dado do A RAM/SFR – coloca addr @OP1 ROM – coloca addr do OP2 | RAM/SFR – recebe dado @OP1 ROM – recebe dado do OP2 Calcula A == direct | ALU – recebe dado do Compare ROM – addr do novo PC (ou PC+2) seta flag CICLO_CONTINUA | OK
 |  | CICLO 2 |  |  |  |  |  |  | Clear flag CICLO_CONTINUA ROM – (PC+3) | OK
B6 | 3 | CJNE (http://www.keil.com/support/man/docs/is51/is51_cjne.htm) | @R0, #immed, offset | 2 | 2 | ROM – coloca addr do OP1 RAM – coloca addr do Ri | ROM – recebe dado do OP1 RAM – recebe dado do Ri RAM – coloca addr @Ri ROM – coloca addr do OP2 | RAM – recebe dado @Ri ROM – recebe dado do OP2 Calcula @Ri == immed | ALU – recebe dado do Compare ROM – addr do novo PC (ou PC+2) seta flag CICLO_CONTINUA | OK
 |  | CICLO 2 |  |  |  |  |  |  | Clear flag CICLO_CONTINUA ROM – (PC+3) | OK
B7 | 3 | CJNE (http://www.keil.com/support/man/docs/is51/is51_cjne.htm) | @R1, #immed, offset | 2 | 2 | ROM – coloca addr do OP1 RAM – coloca addr do Ri | ROM – recebe dado do OP1 RAM – recebe dado do Ri RAM – coloca addr @Ri ROM – coloca addr do OP2 | RAM – recebe dado @Ri ROM – recebe dado do OP2 Calcula @Ri == immed | ALU – recebe dado do Compare ROM – addr do novo PC (ou PC+2) seta flag CICLO_CONTINUA | OK
 |  | CICLO 2 |  |  |  |  |  |  | Clear flag CICLO_CONTINUA ROM – (PC+3) | OK
B8 | 3 | CJNE (http://www.keil.com/support/man/docs/is51/is51_cjne.htm) | R0, #immed, offset | 2 | 2 | ROM – coloca addr do OP1 RAM – coloca addr do Rn | ROM – recebe dado do OP1 RAM – recebe dado do Ri ROM – coloca addr do OP2 | ROM – recebe dado do OP2 Calcula Rn == immed | ALU – recebe dado do Compare ROM – addr do novo PC (ou PC+2) seta flag CICLO_CONTINUA | OK
 |  | CICLO 2 |  |  |  |  |  |  | Clear flag CICLO_CONTINUA ROM – (PC+3) | OK
B9 | 3 | CJNE (http://www.keil.com/support/man/docs/is51/is51_cjne.htm) | R1, #immed, offset | 2 | 2 | ROM – coloca addr do OP1 RAM – coloca addr do Rn | ROM – recebe dado do OP1 RAM – recebe dado do Ri ROM – coloca addr do OP2 | ROM – recebe dado do OP2 Calcula Rn == immed | ALU – recebe dado do Compare ROM – addr do novo PC (ou PC+2) seta flag CICLO_CONTINUA | OK
 |  | CICLO 2 |  |  |  |  |  |  | Clear flag CICLO_CONTINUA ROM – (PC+3) | OK
BA | 3 | CJNE (http://www.keil.com/support/man/docs/is51/is51_cjne.htm) | R2, #immed, offset | 2 | 2 | ROM – coloca addr do OP1 RAM – coloca addr do Rn | ROM – recebe dado do OP1 RAM – recebe dado do Ri ROM – coloca addr do OP2 | ROM – recebe dado do OP2 Calcula Rn == immed | ALU – recebe dado do Compare ROM – addr do novo PC (ou PC+2) seta flag CICLO_CONTINUA | OK
 |  | CICLO 2 |  |  |  |  |  |  | Clear flag CICLO_CONTINUA ROM – (PC+3) | OK
BB | 3 | CJNE (http://www.keil.com/support/man/docs/is51/is51_cjne.htm) | R3, #immed, offset | 2 | 2 | ROM – coloca addr do OP1 RAM – coloca addr do Rn | ROM – recebe dado do OP1 RAM – recebe dado do Ri ROM – coloca addr do OP2 | ROM – recebe dado do OP2 Calcula Rn == immed | ALU – recebe dado do Compare ROM – addr do novo PC (ou PC+2) seta flag CICLO_CONTINUA | OK
 |  | CICLO 2 |  |  |  |  |  |  | Clear flag CICLO_CONTINUA ROM – (PC+3) | OK
BC | 3 | CJNE (http://www.keil.com/support/man/docs/is51/is51_cjne.htm) | R4, #immed, offset | 2 | 2 | ROM – coloca addr do OP1 RAM – coloca addr do Rn | ROM – recebe dado do OP1 RAM – recebe dado do Ri ROM – coloca addr do OP2 | ROM – recebe dado do OP2 Calcula Rn == immed | ALU – recebe dado do Compare ROM – addr do novo PC (ou PC+2) seta flag CICLO_CONTINUA | OK
 |  | CICLO 2 |  |  |  |  |  |  | Clear flag CICLO_CONTINUA ROM – (PC+3) | OK
BD | 3 | CJNE (http://www.keil.com/support/man/docs/is51/is51_cjne.htm) | R5, #immed, offset | 2 | 2 | ROM – coloca addr do OP1 RAM – coloca addr do Rn | ROM – recebe dado do OP1 RAM – recebe dado do Ri ROM – coloca addr do OP2 | ROM – recebe dado do OP2 Calcula Rn == immed | ALU – recebe dado do Compare ROM – addr do novo PC (ou PC+2) seta flag CICLO_CONTINUA | OK
 |  | CICLO 2 |  |  |  |  |  |  | Clear flag CICLO_CONTINUA ROM – (PC+3) | OK
BE | 3 | CJNE (http://www.keil.com/support/man/docs/is51/is51_cjne.htm) | R6, #immed, offset | 2 | 2 | ROM – coloca addr do OP1 RAM – coloca addr do Rn | ROM – recebe dado do OP1 RAM – recebe dado do Ri ROM – coloca addr do OP2 | ROM – recebe dado do OP2 Calcula Rn == immed | ALU – recebe dado do Compare ROM – addr do novo PC (ou PC+2) seta flag CICLO_CONTINUA | OK
 |  | CICLO 2 |  |  |  |  |  |  | Clear flag CICLO_CONTINUA ROM – (PC+3) | OK
BF | 3 | CJNE (http://www.keil.com/support/man/docs/is51/is51_cjne.htm) | R7, #immed, offset | 2 | 2 | ROM – coloca addr do OP1 RAM – coloca addr do Rn | ROM – recebe dado do OP1 RAM – recebe dado do Ri ROM – coloca addr do OP2 | ROM – recebe dado do OP2 Calcula Rn == immed | ALU – recebe dado do Compare ROM – addr do novo PC (ou PC+2) seta flag CICLO_CONTINUA | OK
 |  | CICLO 2 |  |  |  |  |  |  | Clear flag CICLO_CONTINUA ROM – (PC+3) | OK
C0 | 2 | PUSH (http://www.keil.com/support/man/docs/is51/is51_push.htm) | direct | 2 | 1 | ROM – coloca addr do OP1 SFR – coloca addr do SP | ROM - recebe dado do OP1 SFR – recebe dado do SP RAM/SFR – coloca addr @OP1 | RAM/SFR – recebe dado @OP1 Calcula SP+1 | ROM – addr do PC+2 RAM – Coloca addr @SP+1 RAM – Escreve dado @OP1 SFR – Coloca addr do SP SFR – Escreve dado SP+1 | OK
C1 | 2 | AJMP (http://www.keil.com/support/man/docs/is51/is51_ajmp.htm) | addr11 | 2 | 2 |  |  |  |  | OK
C2 | 2 | CLR (http://www.keil.com/support/man/docs/is51/is51_clr.htm) | bit | 1 | 1 | ROM – coloca addr do OP1 | ROM - recebe dado do OP1 | Clear bit | ROM – addr do PC+2 RAM/SFR – addr do bit RAM/SFR – dado 0 | OK
C3 | 1 | CLR (http://www.keil.com/support/man/docs/is51/is51_clr.htm) | C | 1 | 1 | SFR – coloca addr do PSW | SFR – recebe dado do PSW | Clear C | ROM – addr do PC+1 SFR - addr C (PSW) SFR – dado 0 | OK
C4 | 1 | SWAP (http://www.keil.com/support/man/docs/is51/is51_swap.htm) | A | 1 | 1 | SFR – coloca addr do A | SFR – recebe dado do A | Calcula A swapped | ROM – addr do PC+1 SFR – addr do A SFR – dado do A | OK
C5 | 2 | XCH (http://www.keil.com/support/man/docs/is51/is51_xch.htm) | A, direct | 1 | 1 | ROM – coloca addr do OP1 SFR – coloca addr do A | ROM - recebe dado do OP1 SFR – recebe dado do A RAM/SFR – coloca addr do @OP1 | RAM/SFR – recebe dado @OP1 SFR – addr do A SFR – dado do A | RAM/SFR – addr direct RAM/SFR – dado do direct | OK
C6 | 1 | XCH (http://www.keil.com/support/man/docs/is51/is51_xch.htm) | A, @R0 | 1 | 1 | SFR – coloca addr do A RAM – coloca addr do Ri | SFR – recebe dado do A RAM – recebe dado do Ri RAM – coloca addr do @Ri | RAM – recebe dado @Ri SFR – addr do A SFR – dado do A | ROM – addr do PC+1 RAM – addr do Ri RAM – dado do Ri | OK
C7 | 1 | XCH (http://www.keil.com/support/man/docs/is51/is51_xch.htm) | A, @R1 | 1 | 1 | SFR – coloca addr do A RAM – coloca addr do Ri | SFR – recebe dado do A RAM – recebe dado do Ri RAM – coloca addr do @Ri | RAM – recebe dado @Ri SFR – addr do A SFR – dado do A | ROM – addr do PC+1 RAM – addr do Ri RAM – dado do Ri | OK
C8 | 1 | XCH (http://www.keil.com/support/man/docs/is51/is51_xch.htm) | A, R0 | 1 | 1 | SFR – coloca addr do A RAM – coloca addr do Rn | SFR – recebe dado do A RAM – recebe dado do Rn | Calcula A swap @Rn | ROM – addr do PC+1 SFR – addr do A SFR – dado do A RAM – addr do Rn RAM – dado do Rn | OK
C9 | 1 | XCH (http://www.keil.com/support/man/docs/is51/is51_xch.htm) | A, R1 | 1 | 1 | SFR – coloca addr do A RAM – coloca addr do Rn | SFR – recebe dado do A RAM – recebe dado do Rn | Calcula A swap @Rn | ROM – addr do PC+1 SFR – addr do A SFR – dado do A RAM – addr do Rn RAM – dado do Rn | OK
CA | 1 | XCH (http://www.keil.com/support/man/docs/is51/is51_xch.htm) | A, R2 | 1 | 1 | SFR – coloca addr do A RAM – coloca addr do Rn | SFR – recebe dado do A RAM – recebe dado do Rn | Calcula A swap @Rn | ROM – addr do PC+1 SFR – addr do A SFR – dado do A RAM – addr do Rn RAM – dado do Rn | OK
CB | 1 | XCH (http://www.keil.com/support/man/docs/is51/is51_xch.htm) | A, R3 | 1 | 1 | SFR – coloca addr do A RAM – coloca addr do Rn | SFR – recebe dado do A RAM – recebe dado do Rn | Calcula A swap @Rn | ROM – addr do PC+1 SFR – addr do A SFR – dado do A RAM – addr do Rn RAM – dado do Rn | OK
CC | 1 | XCH (http://www.keil.com/support/man/docs/is51/is51_xch.htm) | A, R4 | 1 | 1 | SFR – coloca addr do A RAM – coloca addr do Rn | SFR – recebe dado do A RAM – recebe dado do Rn | Calcula A swap @Rn | ROM – addr do PC+1 SFR – addr do A SFR – dado do A RAM – addr do Rn RAM – dado do Rn | OK
CD | 1 | XCH (http://www.keil.com/support/man/docs/is51/is51_xch.htm) | A, R5 | 1 | 1 | SFR – coloca addr do A RAM – coloca addr do Rn | SFR – recebe dado do A RAM – recebe dado do Rn | Calcula A swap @Rn | ROM – addr do PC+1 SFR – addr do A SFR – dado do A RAM – addr do Rn RAM – dado do Rn | OK
CE | 1 | XCH (http://www.keil.com/support/man/docs/is51/is51_xch.htm) | A, R6 | 1 | 1 | SFR – coloca addr do A RAM – coloca addr do Rn | SFR – recebe dado do A RAM – recebe dado do Rn | Calcula A swap @Rn | ROM – addr do PC+1 SFR – addr do A SFR – dado do A RAM – addr do Rn RAM – dado do Rn | OK
CF | 1 | XCH (http://www.keil.com/support/man/docs/is51/is51_xch.htm) | A, R7 | 1 | 1 | SFR – coloca addr do A RAM – coloca addr do Rn | SFR – recebe dado do A RAM – recebe dado do Rn | Calcula A swap @Rn | ROM – addr do PC+1 SFR – addr do A SFR – dado do A RAM – addr do Rn RAM – dado do Rn | OK
D0 | 2 | POP (http://www.keil.com/support/man/docs/is51/is51_pop.htm) | direct | 2 | 1 | ROM – coloca addr do OP1 SFR – coloca addr do SP | ROM - recebe dado do OP1 SFR – recebe dado do SP RAM – coloca addr @SP | RAM – recebe dado @SP Calcula SP-1 | ROM – addr do PC+2 RAM – Coloca addr @SP+1 RAM – Escreve dado @OP1 SFR – Coloca addr do SP SFR – Escreve dado SP+1 | OK
D1 | 2 | ACALL (http://www.keil.com/support/man/docs/is51/is51_acall.htm) | addr11 | 2 | 2 |  |  |  |  | OK
D2 | 2 | SETB (http://www.keil.com/support/man/docs/is51/is51_setb.htm) | bit | 1 | 1 | ROM – coloca addr do OP1 | ROM - recebe dado do OP1 | - | ROM – addr do PC+2 RAM/SFR – addr do bit RAM/SFR – dado 1 | OK
D3 | 1 | SETB (http://www.keil.com/support/man/docs/is51/is51_setb.htm) | C | 1 | 1 | - | - | - | ROM – addr do PC+1 SFR - addr C (PSW) SFR – dado 1 | OK
D4 | 1 | DA (http://www.keil.com/support/man/docs/is51/is51_da.htm) | A | 1 | 1 | SFR – coloca addr do A | SFR – recebe dado do A | Calcula decimal ajust A | ROM – addr do PC+1 SFR – addr do A SFR – dado do A | OK
D5 | 3 | DJNZ (http://www.keil.com/support/man/docs/is51/is51_djnz.htm) | direct, offset | 2 | 2 | ROM – coloca addr do OP1 | ROM – recebe dado do OP1 ROM – coloca addr do OP2 RAM/SFR – coloca addr @OP1 | ROM – recebe dado do OP2 RAM/SFR – recebe dado @OP1 Calcula (direct – 1) == 0 | ALU – recebe dado do decrement ROM – addr do novo PC (ou PC+2) seta flag CICLO_CONTINUA | OK | *lembrar de ALU retornar valor do decremento além do resultado da comparacao com 0
 |  | CICLO 2 |  |  |  |  |  |  | Clear flag CICLO_CONTINUA ROM – (PC+3) | OK
D6 | 1 | XCHD (http://www.keil.com/support/man/docs/is51/is51_xchd.htm) | A, @R0 | 1 | 1 | RAM – coloca addr do Ri SFR – coloca addr do A | RAM – recebe dado do Ri RAM – coloco endereco @Ri SFR – recebe dado do A | RAM – recebe dado @Ri Calcula A[3-0] swap @R[3-0] | ROM – addr do PC+1 SFR – addr do A SFR – dado do A RAM – addr do Ri RAM – dado do Ri | OK
D7 | 1 | XCHD (http://www.keil.com/support/man/docs/is51/is51_xchd.htm) | A, @R1 | 1 | 1 | RAM – coloca addr do Ri SFR – coloca addr do A | RAM – recebe dado do Ri RAM – coloco endereco @Ri SFR – recebe dado do A | RAM – recebe dado @Ri Calcula A[3-0] swap @R[3-0] | ROM – addr do PC+1 SFR – addr do A SFR – dado do A RAM – addr do Ri RAM – dado do Ri | OK
D8 | 2 | DJNZ (http://www.keil.com/support/man/docs/is51/is51_djnz.htm) | R0, offset | 2 | 2 | RAM – coloca addr do Rn ROM – coloca addr do OP1 | RAM – recebe dado do Rn ROM – recebe dado do OP1 | Calcula (Rn-1) == 0 | ALU – recebe dado do decrement ROM – addr do novo PC (ou PC+2) seta flag CICLO_CONTINUA | OK
 |  | CICLO 2 |  |  |  |  |  | Calcula e Escreve novo valor no PC (se necessário) | Clear flag CICLO_CONTINUA ROM – (PC+3) | OK
D9 | 2 | DJNZ (http://www.keil.com/support/man/docs/is51/is51_djnz.htm) | R1, offset | 2 | 2 | RAM – coloca addr do Rn ROM – coloca addr do OP1 | RAM – recebe dado do Rn ROM – recebe dado do OP1 | Calcula (Rn-1) == 0 | ALU – recebe dado do decrement ROM – addr do novo PC (ou PC+2) seta flag CICLO_CONTINUA | OK
 |  | CICLO 2 |  |  |  |  |  | Calcula e Escreve novo valor no PC (se necessário) | Clear flag CICLO_CONTINUA ROM – (PC+3) | OK
DA | 2 | DJNZ (http://www.keil.com/support/man/docs/is51/is51_djnz.htm) | R2, offset | 2 | 2 | RAM – coloca addr do Rn ROM – coloca addr do OP1 | RAM – recebe dado do Rn ROM – recebe dado do OP1 | Calcula (Rn-1) == 0 | ALU – recebe dado do decrement ROM – addr do novo PC (ou PC+2) seta flag CICLO_CONTINUA | OK
 |  | CICLO 2 |  |  |  |  |  | Calcula e Escreve novo valor no PC (se necessário) | Clear flag CICLO_CONTINUA ROM – (PC+3) | OK
DB | 2 | DJNZ (http://www.keil.com/support/man/docs/is51/is51_djnz.htm) | R3, offset | 2 | 2 | RAM – coloca addr do Rn ROM – coloca addr do OP1 | RAM – recebe dado do Rn ROM – recebe dado do OP1 | Calcula (Rn-1) == 0 | ALU – recebe dado do decrement ROM – addr do novo PC (ou PC+2) seta flag CICLO_CONTINUA | OK
 |  | CICLO 2 |  |  |  |  |  | Calcula e Escreve novo valor no PC (se necessário) | Clear flag CICLO_CONTINUA ROM – (PC+3) | OK
DC | 2 | DJNZ (http://www.keil.com/support/man/docs/is51/is51_djnz.htm) | R4, offset | 2 | 2 | RAM – coloca addr do Rn ROM – coloca addr do OP1 | RAM – recebe dado do Rn ROM – recebe dado do OP1 | Calcula (Rn-1) == 0 | ALU – recebe dado do decrement ROM – addr do novo PC (ou PC+2) seta flag CICLO_CONTINUA | OK
 |  | CICLO 2 |  |  |  |  |  | Calcula e Escreve novo valor no PC (se necessário) | Clear flag CICLO_CONTINUA ROM – (PC+3) | OK
DD | 2 | DJNZ (http://www.keil.com/support/man/docs/is51/is51_djnz.htm) | R5, offset | 2 | 2 | RAM – coloca addr do Rn ROM – coloca addr do OP1 | RAM – recebe dado do Rn ROM – recebe dado do OP1 | Calcula (Rn-1) == 0 | ALU – recebe dado do decrement ROM – addr do novo PC (ou PC+2) seta flag CICLO_CONTINUA | OK
 |  | CICLO 2 |  |  |  |  |  | Calcula e Escreve novo valor no PC (se necessário) | Clear flag CICLO_CONTINUA ROM – (PC+3) | OK
DE | 2 | DJNZ (http://www.keil.com/support/man/docs/is51/is51_djnz.htm) | R6, offset | 2 | 2 | RAM – coloca addr do Rn ROM – coloca addr do OP1 | RAM – recebe dado do Rn ROM – recebe dado do OP1 | Calcula (Rn-1) == 0 | ALU – recebe dado do decrement ROM – addr do novo PC (ou PC+2) seta flag CICLO_CONTINUA | OK
 |  | CICLO 2 |  |  |  |  |  | Calcula e Escreve novo valor no PC (se necessário) | Clear flag CICLO_CONTINUA ROM – (PC+3) | OK
DF | 2 | DJNZ (http://www.keil.com/support/man/docs/is51/is51_djnz.htm) | R7, offset | 2 | 2 | RAM – coloca addr do Rn ROM – coloca addr do OP1 | RAM – recebe dado do Rn ROM – recebe dado do OP1 | Calcula (Rn-1) == 0 | ALU – recebe dado do decrement ROM – addr do novo PC (ou PC+2) seta flag CICLO_CONTINUA | OK
 |  | CICLO 2 |  |  |  |  |  | Calcula e Escreve novo valor no PC (se necessário) | Clear flag CICLO_CONTINUA ROM – (PC+3) | OK
E0 | 1 | MOVX (http://www.keil.com/support/man/docs/is51/is51_movx.htm) | A, @DPTR | 2 | 2 | SFR – coloca addr do DPL | SFR – recebe dado do DPL SFR – coloca addr do DPH | SFR – recebe dado do DPH SFR – coloca addr do P2EN SFR – coloca dado do P2EN | SFR – coloca addr do P2 SFR – coloca dado do P2 | OK
 |  | CICLO 2 |  |  |  | RAM – coloca addr do DPL Habilita ext_ram | RAM – recebe dado do @DPTR |  | Clear flag CICLO_CONTINUA SFR – coloca addr do A SFR – coloca dado do @DPTR ROM – addr do PC+1 | OK
E1 | 2 | AJMP (http://www.keil.com/support/man/docs/is51/is51_ajmp.htm) | addr11 | 2 | 2 |  |  |  |  | OK
E2 | 1 | MOVX (http://www.keil.com/support/man/docs/is51/is51_movx.htm) | A, @R0 | 2 | 1 | RAM – coloca addr do Ri | RAM – recebe dado do Ri RAM – coloca addr do @Ri | RAM – recebe dado @Ri | ROM – addr do PC+1 SFR – addr do A SFR – dado @Ri no A | OK | *avisar que é mem externa
E3 | 1 | MOVX (http://www.keil.com/support/man/docs/is51/is51_movx.htm) | A, @R1 | 2 | 1 | RAM – coloca addr do Ri | RAM – recebe dado do Ri RAM – coloca addr do @Ri | RAM – recebe dado @Ri | ROM – addr do PC+1 SFR – addr do A SFR – dado @Ri no A | OK
E4 | 1 | CLR (http://www.keil.com/support/man/docs/is51/is51_clr.htm) | A | 1 | 1 | - | - | - | ROM – addr do PC+1 SFR – addr do A SFR – dado 00h | OK
E5 | 2 | MOV (http://www.keil.com/support/man/docs/is51/is51_mov.htm) | A, direct | 1 | 1 | ROM – coloca addr do OP1 | ROM - recebe dado do OP1 RAM/SFR – coloca addr do @OP1 | RAM/SFR – recebe dado @OP1 | ROM – addr do PC+2 SFR – addr do A SFR – dado direct | OK
E6 | 1 | MOV (http://www.keil.com/support/man/docs/is51/is51_mov.htm) | A, @R0 | 1 | 1 | RAM – coloca addr do Ri | RAM – recebe dado do Ri RAM – coloca addr do @Ri | RAM – recebe dado @Ri | ROM – addr do PC+1 SFR – addr do A SFR – dado @Ri | OK
E7 | 1 | MOV (http://www.keil.com/support/man/docs/is51/is51_mov.htm) | A, @R1 | 1 | 1 | RAM – coloca addr do Ri | RAM – recebe dado do Ri RAM – coloca addr do @Ri | RAM – recebe dado @Ri | ROM – addr do PC+1 SFR – addr do A SFR – dado @Ri | OK
E8 | 1 | MOV (http://www.keil.com/support/man/docs/is51/is51_mov.htm) | A, R0 | 1 | 1 | RAM – coloca addr do Rn | RAM – recebe dado do Rn | - | ROM – addr do PC+1 SFR – addr do A SFR – dado Rn | OK
E9 | 1 | MOV (http://www.keil.com/support/man/docs/is51/is51_mov.htm) | A, R1 | 1 | 1 | RAM – coloca addr do Rn | RAM – recebe dado do Rn | - | ROM – addr do PC+1 SFR – addr do A SFR – dado Rn | OK
EA | 1 | MOV (http://www.keil.com/support/man/docs/is51/is51_mov.htm) | A, R2 | 1 | 1 | RAM – coloca addr do Rn | RAM – recebe dado do Rn | - | ROM – addr do PC+1 SFR – addr do A SFR – dado Rn | OK
EB | 1 | MOV (http://www.keil.com/support/man/docs/is51/is51_mov.htm) | A, R3 | 1 | 1 | RAM – coloca addr do Rn | RAM – recebe dado do Rn | - | ROM – addr do PC+1 SFR – addr do A SFR – dado Rn | OK
EC | 1 | MOV (http://www.keil.com/support/man/docs/is51/is51_mov.htm) | A, R4 | 1 | 1 | RAM – coloca addr do Rn | RAM – recebe dado do Rn | - | ROM – addr do PC+1 SFR – addr do A SFR – dado Rn | OK
ED | 1 | MOV (http://www.keil.com/support/man/docs/is51/is51_mov.htm) | A, R5 | 1 | 1 | RAM – coloca addr do Rn | RAM – recebe dado do Rn | - | ROM – addr do PC+1 SFR – addr do A SFR – dado Rn | OK
EE | 1 | MOV (http://www.keil.com/support/man/docs/is51/is51_mov.htm) | A, R6 | 1 | 1 | RAM – coloca addr do Rn | RAM – recebe dado do Rn | - | ROM – addr do PC+1 SFR – addr do A SFR – dado Rn | OK
EF | 1 | MOV (http://www.keil.com/support/man/docs/is51/is51_mov.htm) | A, R7 | 1 | 1 | RAM – coloca addr do Rn | RAM – recebe dado do Rn | - | ROM – addr do PC+1 SFR – addr do A SFR – dado Rn | OK
F0 | 1 | MOVX (http://www.keil.com/support/man/docs/is51/is51_movx.htm) | @DPTR, A | 2 | 2 | SFR – coloca addr do DPL | SFR – recebe dado do DPL SFR – coloca addr do DPH | SFR – recebe dado do DPH SFR – coloca addr do P2EN SFR – coloca dado do P2EN | SFR – coloca addr do P2 SFR – coloca dado do P2 | OK
 |  | CICLO 2 |  |  |  |  | SFR – coloca addr do A | SFR – recebe dado do A | Clear flag CICLO_CONTINUA RAM – coloca addr do @DPTR Habilita ext_ram RAM – coloca dado do A ROM – addr do PC+1 | OK
F1 | 2 | ACALL (http://www.keil.com/support/man/docs/is51/is51_acall.htm) | addr11 | 2 | 2 |  |  |  |  | OK
F2 | 1 | MOVX (http://www.keil.com/support/man/docs/is51/is51_movx.htm) | @R0, A | 2 | 2 | SFR – coloca addr do A RAM – coloca addr do Ri | SFR – recebe dado do A RAM – recebe dado do Ri | - | ROM – addr do PC+1 RAM – addr do @Ri RAM – dado do A | OK
F3 | 1 | MOVX (http://www.keil.com/support/man/docs/is51/is51_movx.htm) | @R1, A | 2 | 2 | SFR – coloca addr do A RAM – coloca addr do Ri | SFR – recebe dado do A RAM – recebe dado do Ri | - | ROM – addr do PC+1 RAM – addr do @Ri RAM – dado do A | OK
F4 | 1 | CPL (http://www.keil.com/support/man/docs/is51/is51_cpl.htm) | A | 1 | 1 | SFR – coloca addr do A | SFR – recebe dado do A | Calcula ~A | ROM – addr do PC+1 SFR - addr do A SFR – dado do A | OK
F5 | 2 | MOV (http://www.keil.com/support/man/docs/is51/is51_mov.htm) | direct, A | 1 | 1 | ROM – coloca addr do OP1 SFR – coloca addr do A | ROM - recebe dado do OP1 SFR – recebe dado do A | - | ROM – addr do PC+2 RAM/SFR – addr do @OP1 RAM/SFR – dado do A | OK
F6 | 1 | MOV (http://www.keil.com/support/man/docs/is51/is51_mov.htm) | @R0, A | 1 | 1 | SFR – coloca addr do A RAM – coloca addr do Ri | SFR – recebe dado do A RAM – recebe dado do Ri | - | ROM – addr do PC+1 RAM – addr do @Ri RAM – dado do A | OK
F7 | 1 | MOV (http://www.keil.com/support/man/docs/is51/is51_mov.htm) | @R1, A | 1 | 1 | SFR – coloca addr do A RAM – coloca addr do Ri | SFR – recebe dado do A RAM – recebe dado do Ri | - | ROM – addr do PC+1 RAM – addr do @Ri RAM – dado do A | OK
F8 | 1 | MOV (http://www.keil.com/support/man/docs/is51/is51_mov.htm) | R0, A | 1 | 1 | SFR – coloca addr do A | SFR – recebe dado do A | - | ROM – addr do PC+1 RAM – addr do Rn RAM – dado do A | OK
F9 | 1 | MOV (http://www.keil.com/support/man/docs/is51/is51_mov.htm) | R1, A | 1 | 1 | SFR – coloca addr do A | SFR – recebe dado do A | - | ROM – addr do PC+1 RAM – addr do Rn RAM – dado do A | OK
FA | 1 | MOV (http://www.keil.com/support/man/docs/is51/is51_mov.htm) | R2, A | 1 | 1 | SFR – coloca addr do A | SFR – recebe dado do A | - | ROM – addr do PC+1 RAM – addr do Rn RAM – dado do A | OK
FB | 1 | MOV (http://www.keil.com/support/man/docs/is51/is51_mov.htm) | R3, A | 1 | 1 | SFR – coloca addr do A | SFR – recebe dado do A | - | ROM – addr do PC+1 RAM – addr do Rn RAM – dado do A | OK
FC | 1 | MOV (http://www.keil.com/support/man/docs/is51/is51_mov.htm) | R4, A | 1 | 1 | SFR – coloca addr do A | SFR – recebe dado do A | - | ROM – addr do PC+1 RAM – addr do Rn RAM – dado do A | OK
FD | 1 | MOV (http://www.keil.com/support/man/docs/is51/is51_mov.htm) | R5, A | 1 | 1 | SFR – coloca addr do A | SFR – recebe dado do A | - | ROM – addr do PC+1 RAM – addr do Rn RAM – dado do A | OK
FE | 1 | MOV (http://www.keil.com/support/man/docs/is51/is51_mov.htm) | R6, A | 1 | 1 | SFR – coloca addr do A | SFR – recebe dado do A | - | ROM – addr do PC+1 RAM – addr do Rn RAM – dado do A | OK
FF | 1 | MOV (http://www.keil.com/support/man/docs/is51/is51_mov.htm) | R7, A | 1 | 1 | SFR – coloca addr do A | SFR – recebe dado do A | - | ROM – addr do PC+1 RAM – addr do Rn RAM – dado do A | OK
 |  |  |  |  |  |  |  |  |  | 289
 |  |  |  |  |  |  |  |  | 289 | 100.00%

Sheet: AUXILIAR
Hex Code | Bytes | Mnemonic | Operands | Mach. Cycle | Our MC | DC1 | DC2 | EX | WB | Done?
E0 | 1 | MOVX (http://www.keil.com/support/man/docs/is51/is51_movx.htm) | A, @DPTR | 2 |  | SFR – coloca addr do DPL | SFR – recebe dado do DPL SFR – coloca addr do DPH | SFR – recebe dado do DPH SFR – coloca addr do P2EN SFR – coloca dado do P2EN | SFR – coloca addr do P2 SFR – coloca dado do P2 | OK
 |  | CICLO 2 |  |  |  | RAM – coloca addr do DPL Habilita ext_ram | RAM – recebe dado do @DPTR |  | Clear flag CICLO_CONTINUA SFR – coloca addr do A SFR – coloca dado do @DPTR ROM – addr do PC+1 | OK
F0 | 1 | MOVX (http://www.keil.com/support/man/docs/is51/is51_movx.htm) | @DPTR, A | 2 |  | SFR – coloca addr do DPL | SFR – recebe dado do DPL SFR – coloca addr do DPH | SFR – recebe dado do DPH SFR – coloca addr do P2EN SFR – coloca dado do P2EN | SFR – coloca addr do P2 SFR – coloca dado do P2 | Missing
 |  | CICLO 2 |  |  |  | RAM – coloca addr do DPL Habilita ext_ram | RAM – recebe dado do @DPTR SFR – coloca addr do A | SFR – recebe dado do A | Clear flag CICLO_CONTINUA SFR – coloca addr do @DPTR SFR – coloca dado do A ROM – addr do PC+1 | OK
