pedrofausto/EMC08/core/design/docs/ALU/alu_waveform01.png

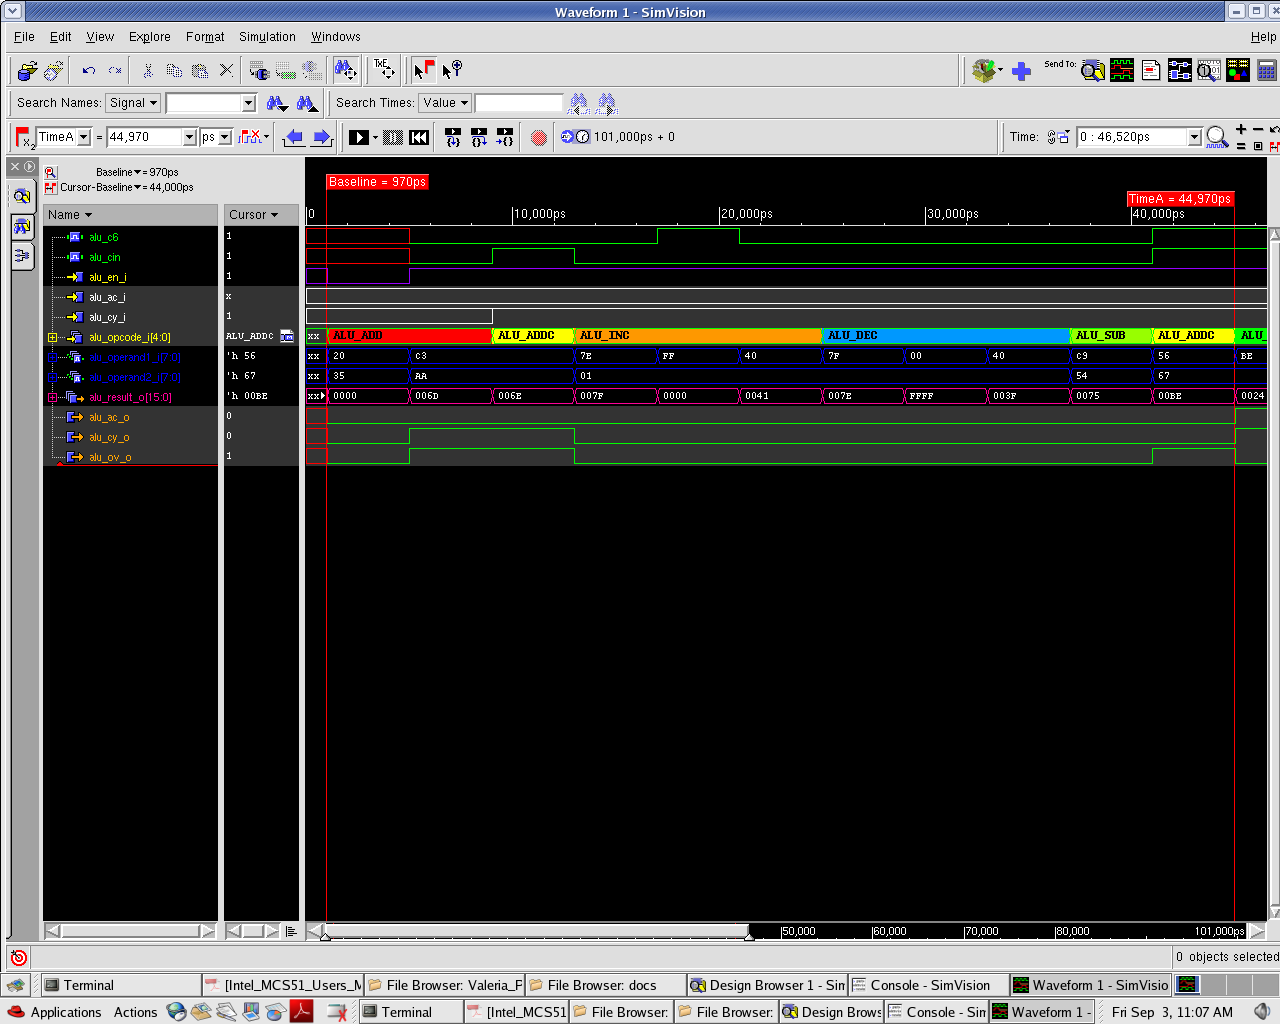
core/design/docs/ALU/alu_waveform01.png
