pedrofausto/EMC08/core/design/docs/ALU/alu_waveform02.png

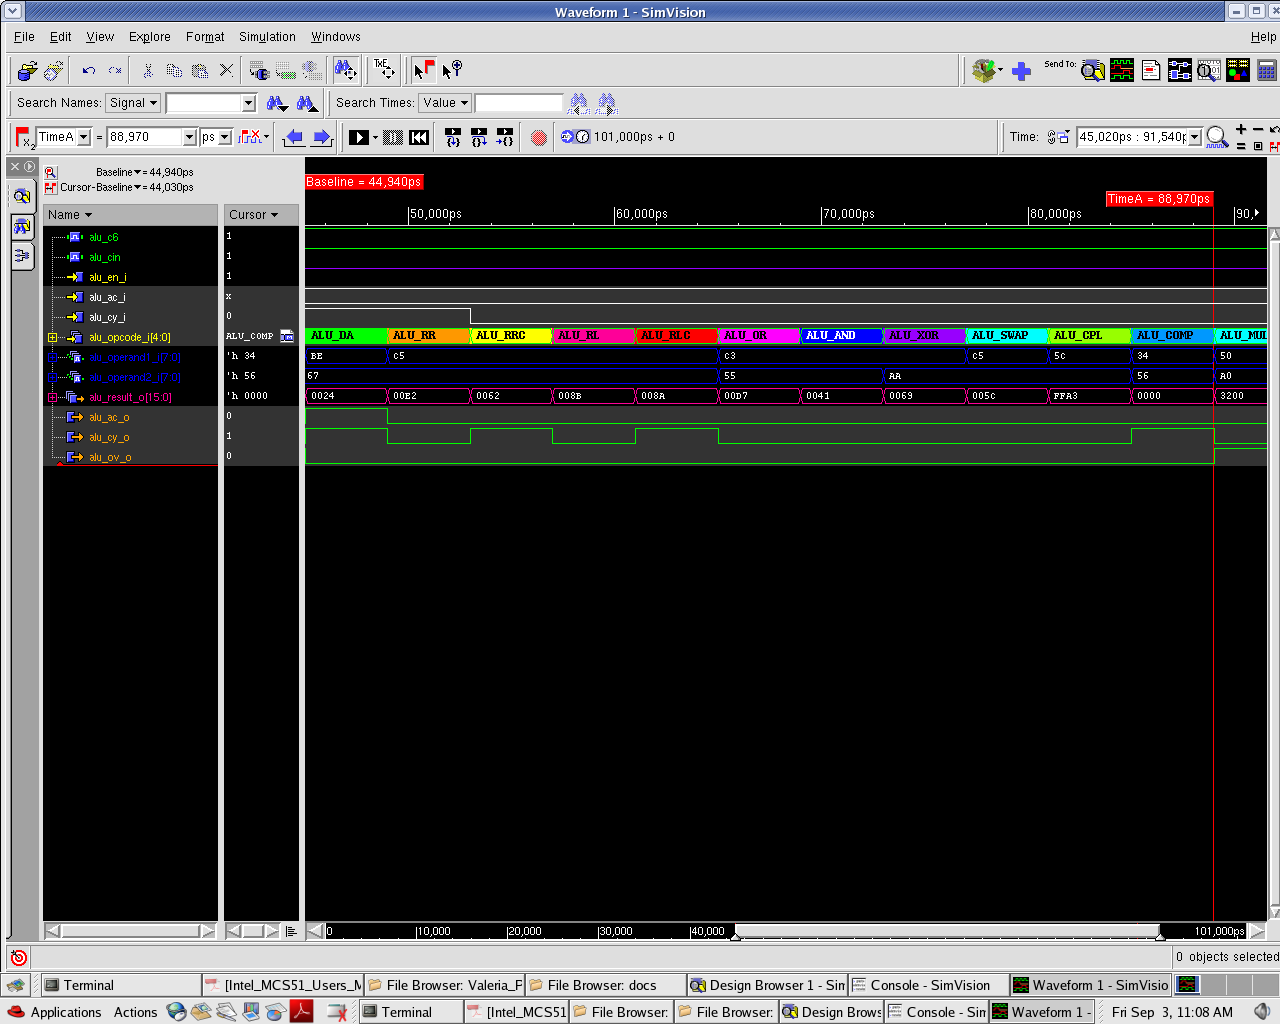
core/design/docs/ALU/alu_waveform02.png
