pedrofausto/EMC08/core/design/docs/ALU/alu_waveform03.png

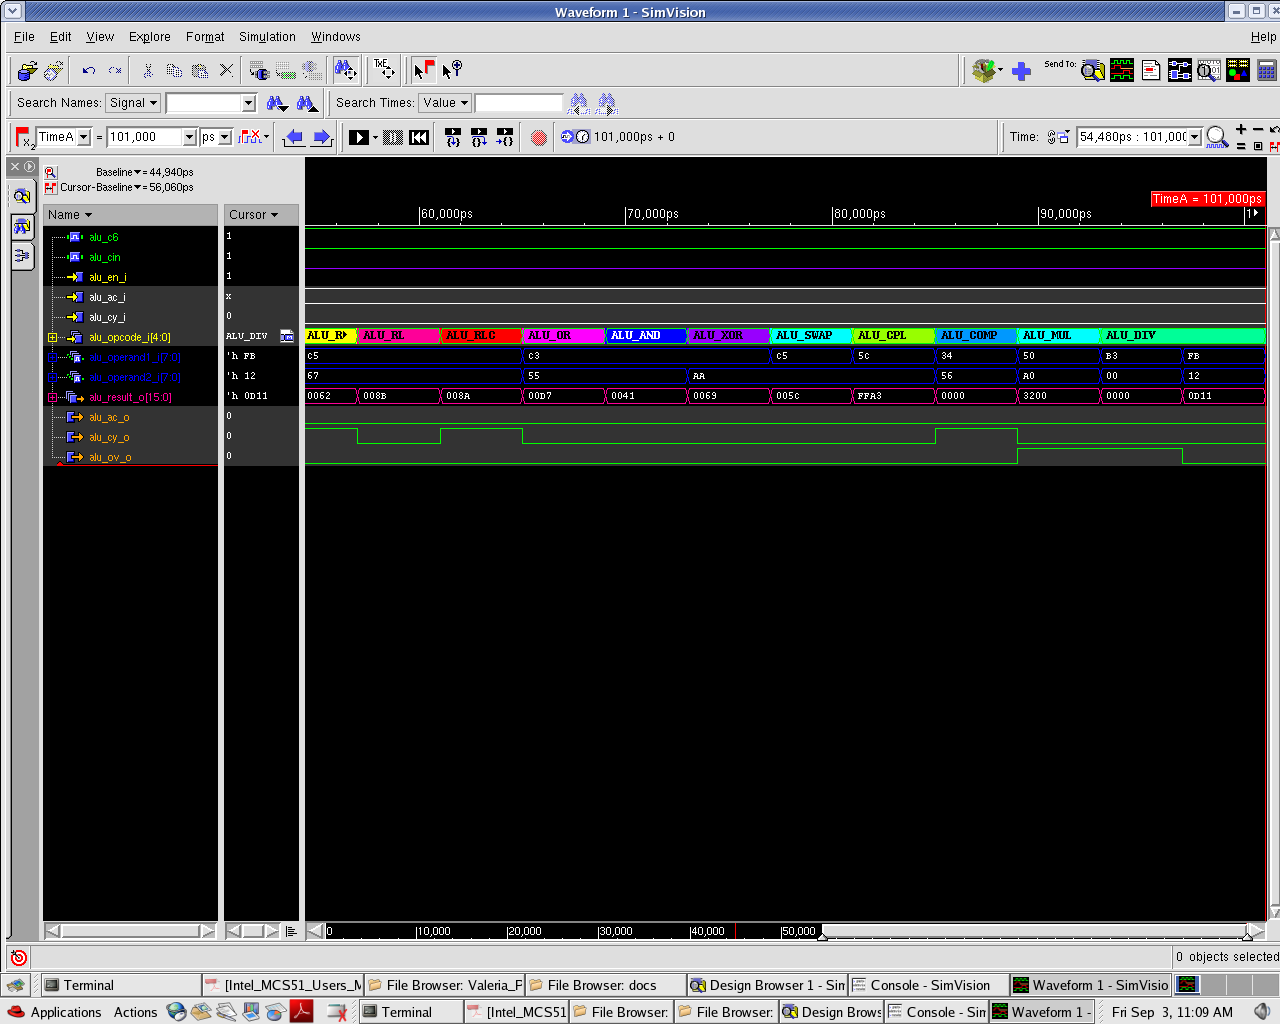
core/design/docs/ALU/alu_waveform03.png
