pedrofausto/EMC08/core/design/docs/ALU/LEC_alu.png

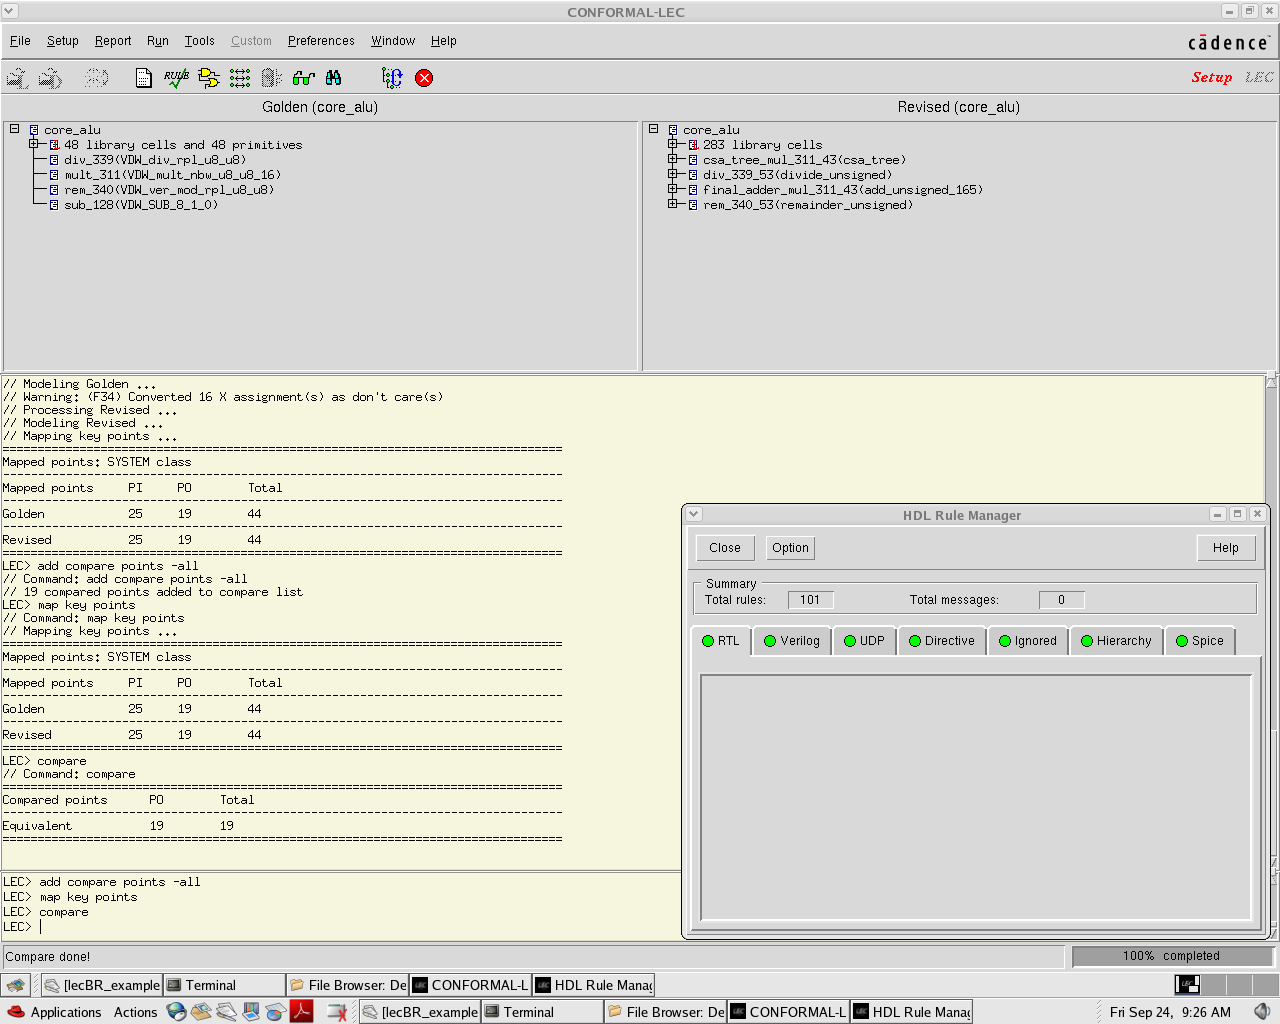
core/design/docs/ALU/LEC_alu.png
