pedrofausto/EMC08/core/design/docs/FSM/LEC_core_fsm_ignores.png

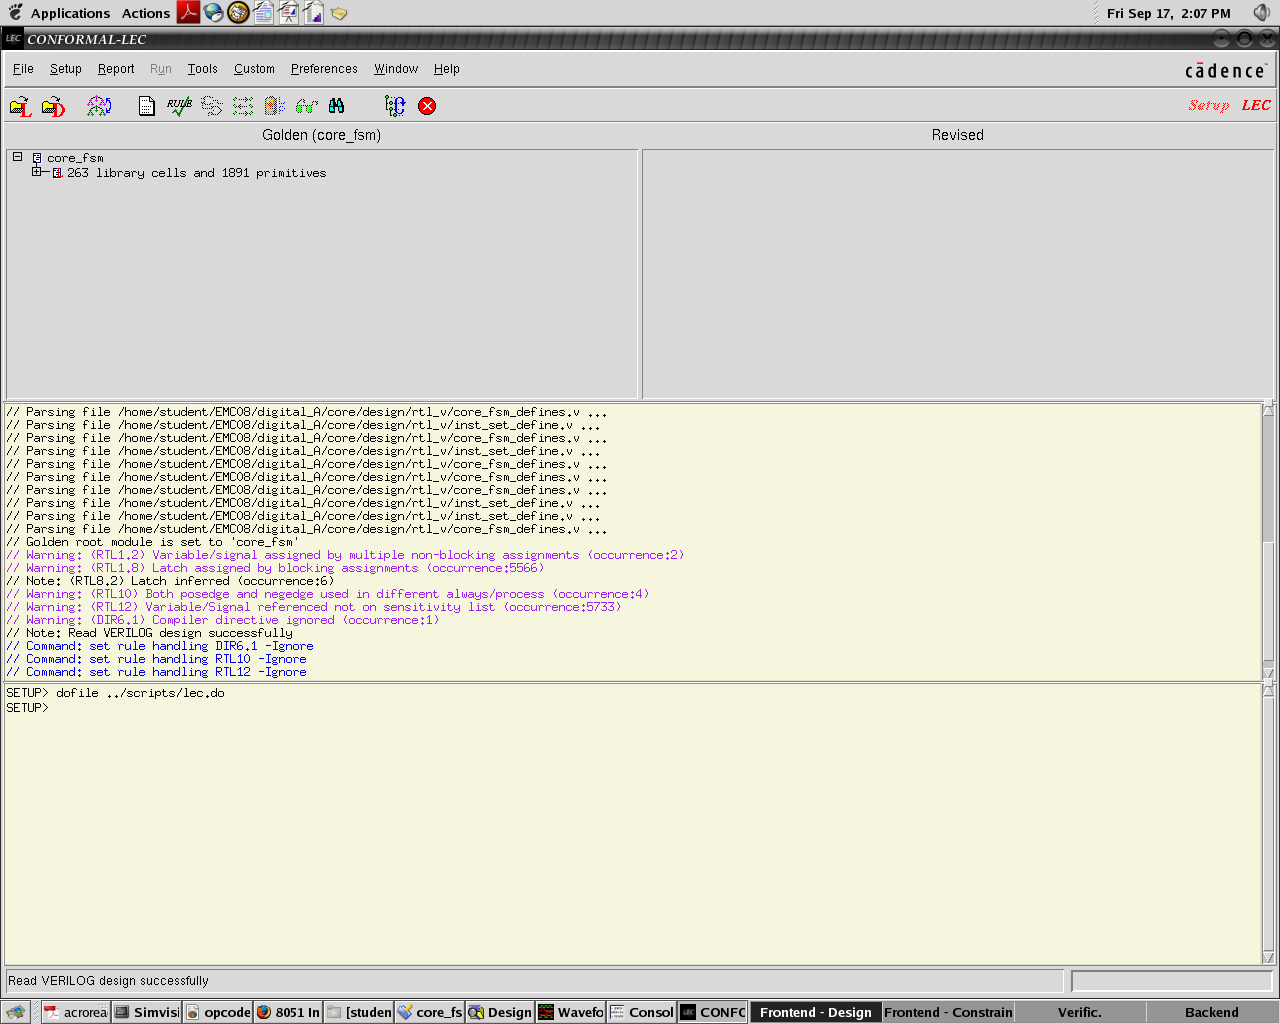
core/design/docs/FSM/LEC_core_fsm_ignores.png
