pedrofausto/EMC08/core/design/docs/FSM/LEC_core_fsm_warnings.png

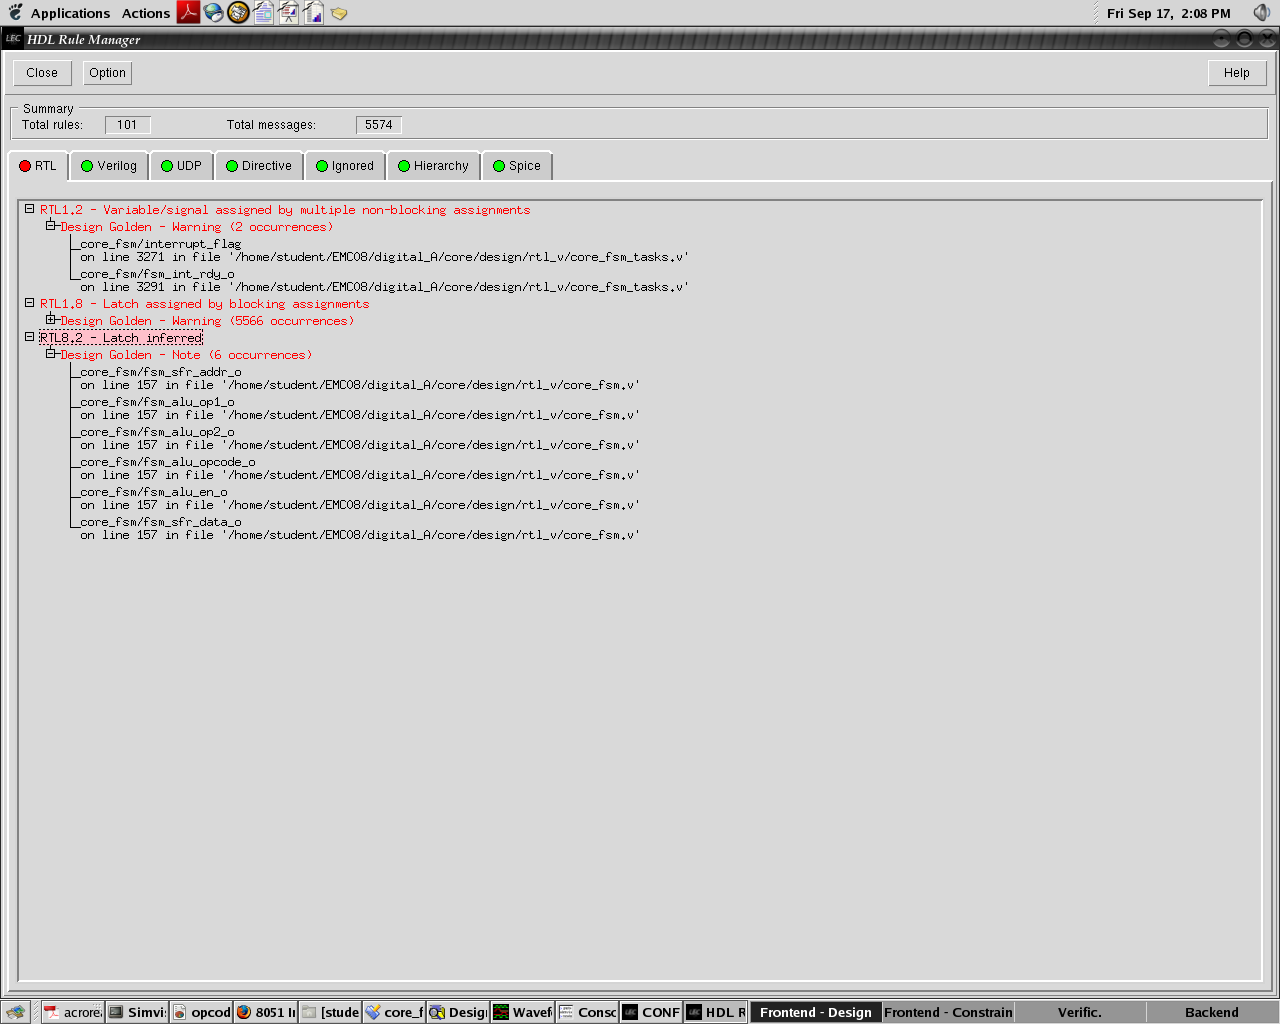
core/design/docs/FSM/LEC_core_fsm_warnings.png
