pedrofausto/EMC08/core/design/docs/FSM/LEC_final.png

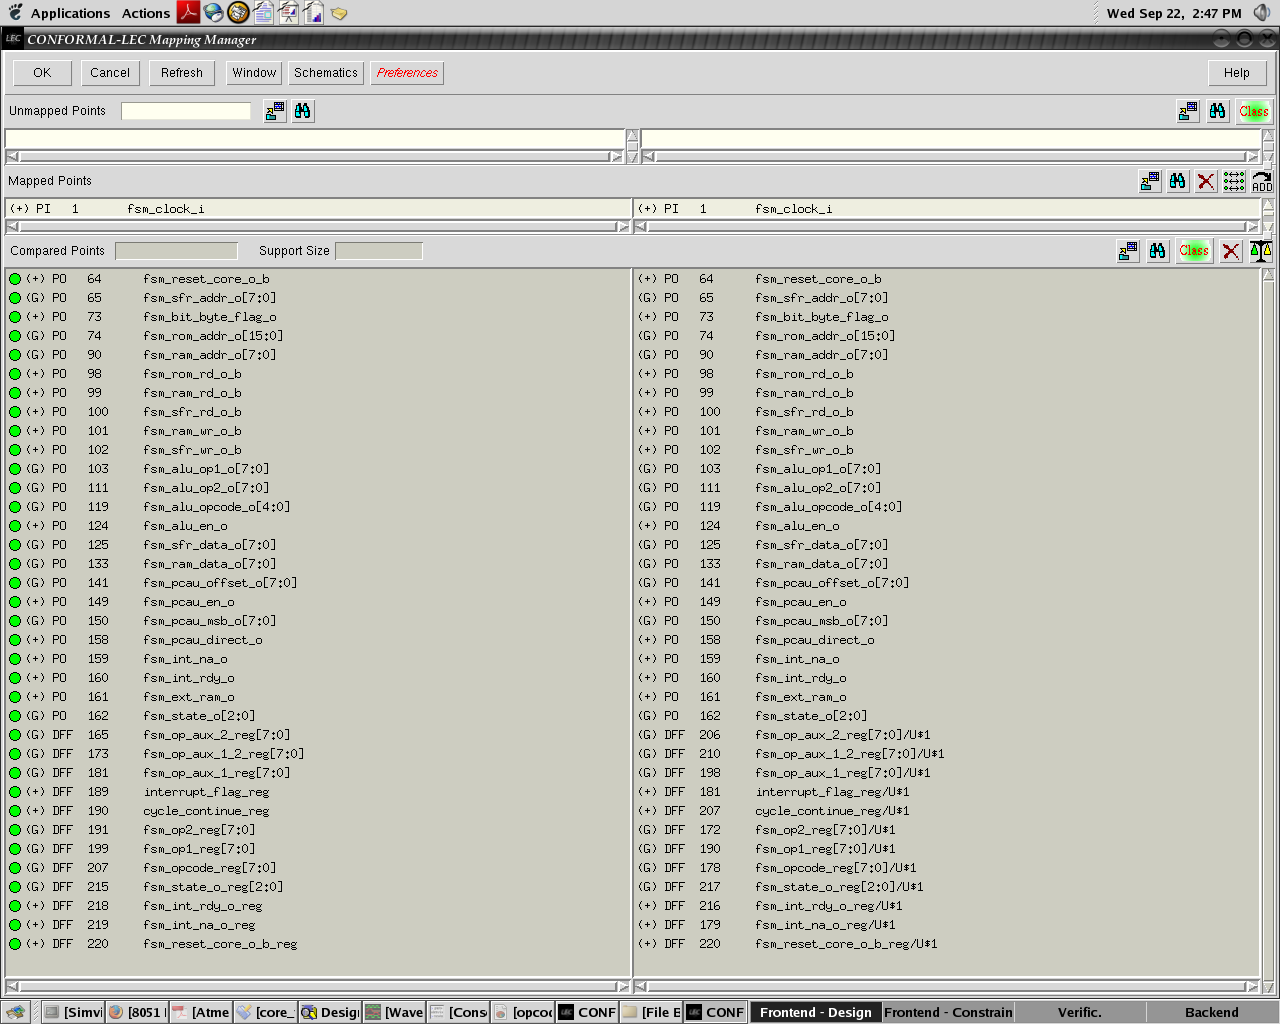
core/design/docs/FSM/LEC_final.png
