pedrofausto/EMC08/core/design/docs/FSM/RC_deleted_instances.png

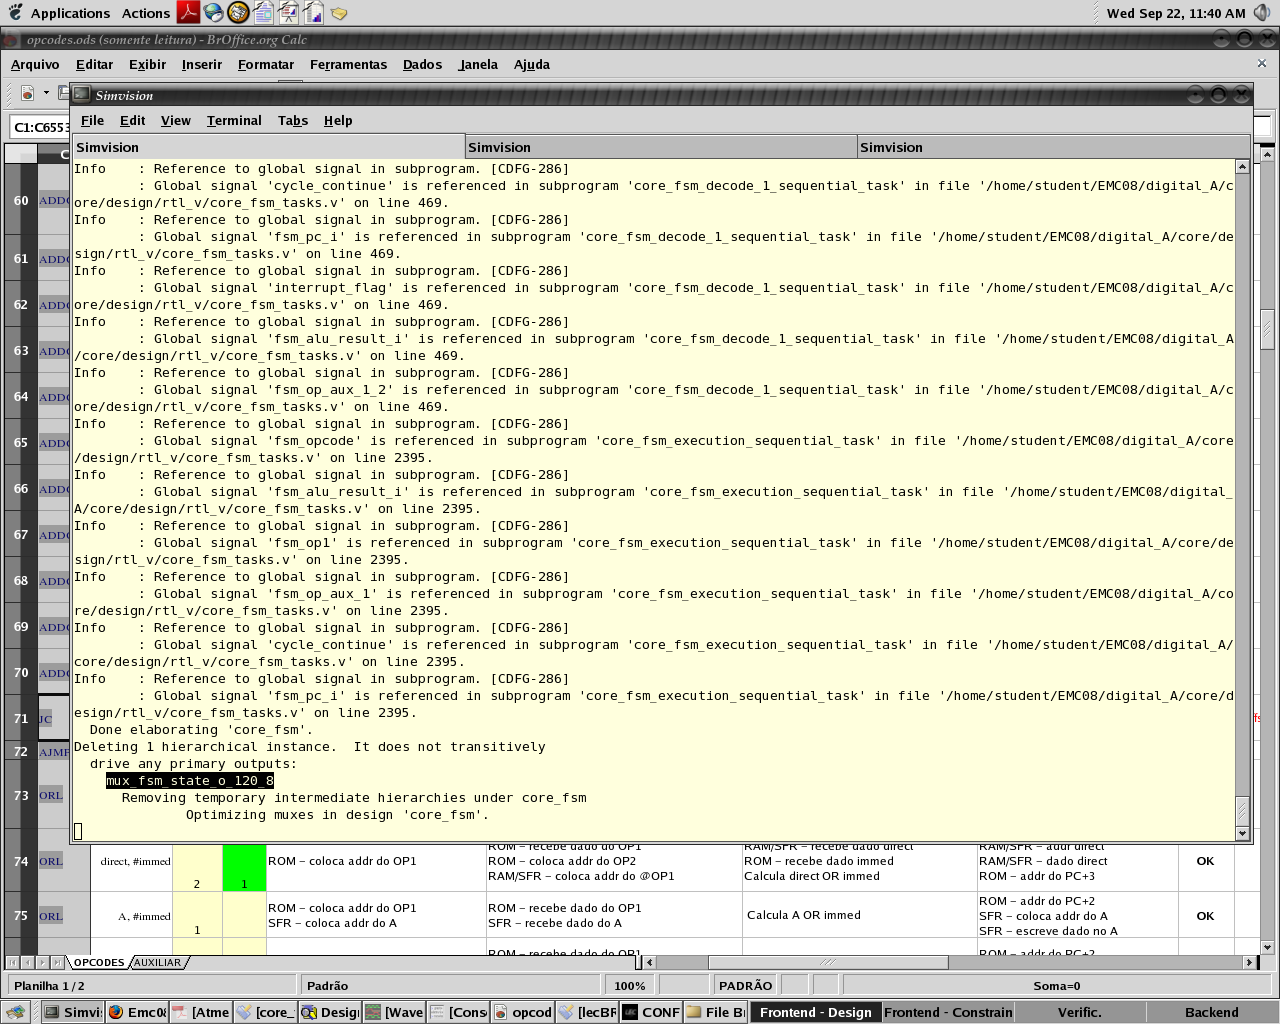
core/design/docs/FSM/RC_deleted_instances.png
