pedrofausto/EMC08/ports/design/reports/graficos_ports/compare1.png

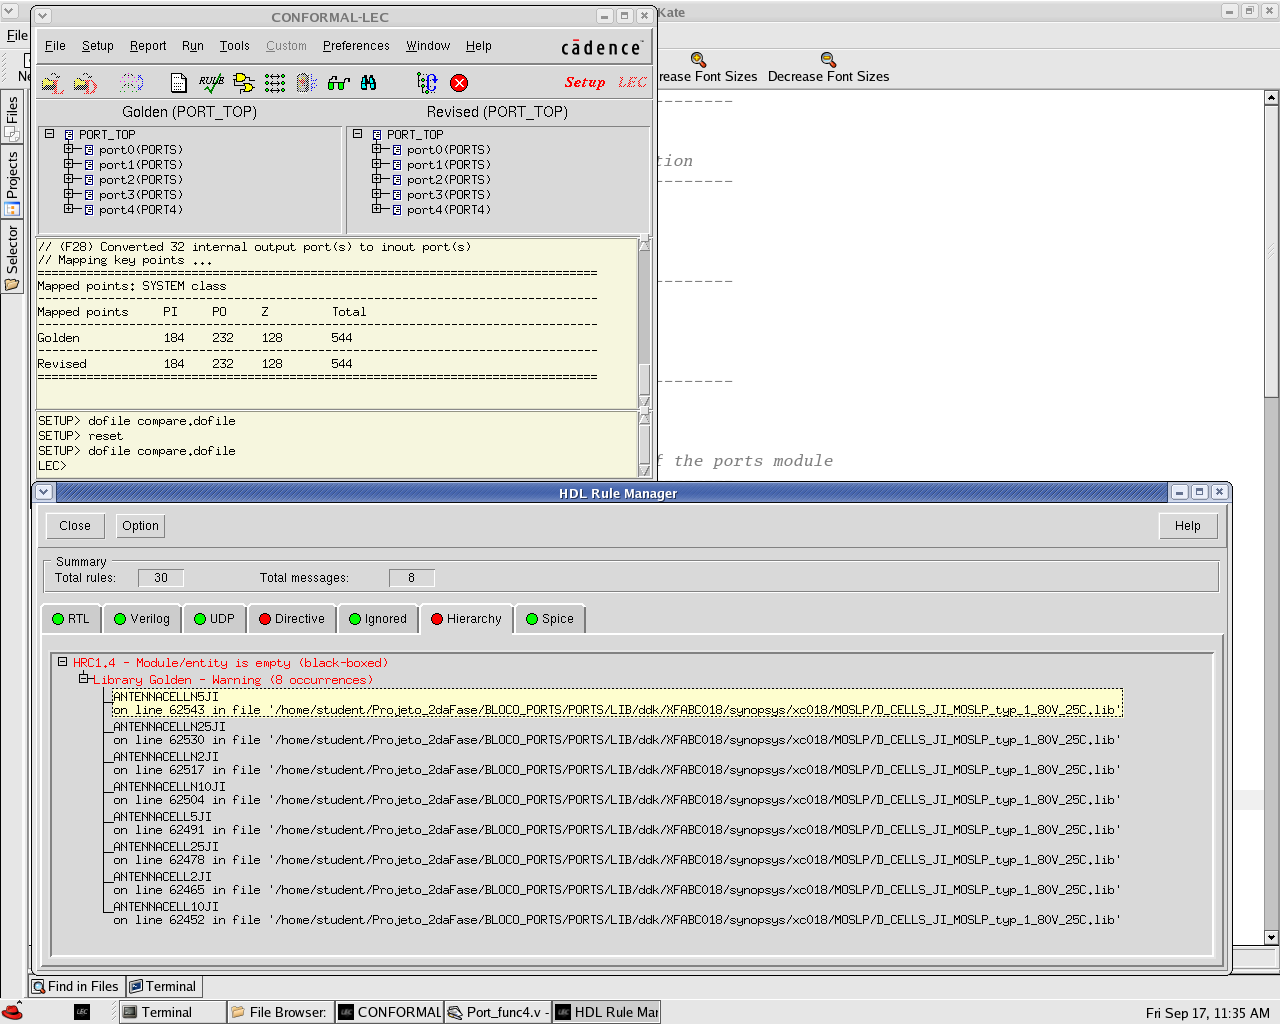
ports/design/reports/graficos_ports/compare1.png
