pedrofausto/EMC08/ports/design/reports/graficos_ports/compare.png

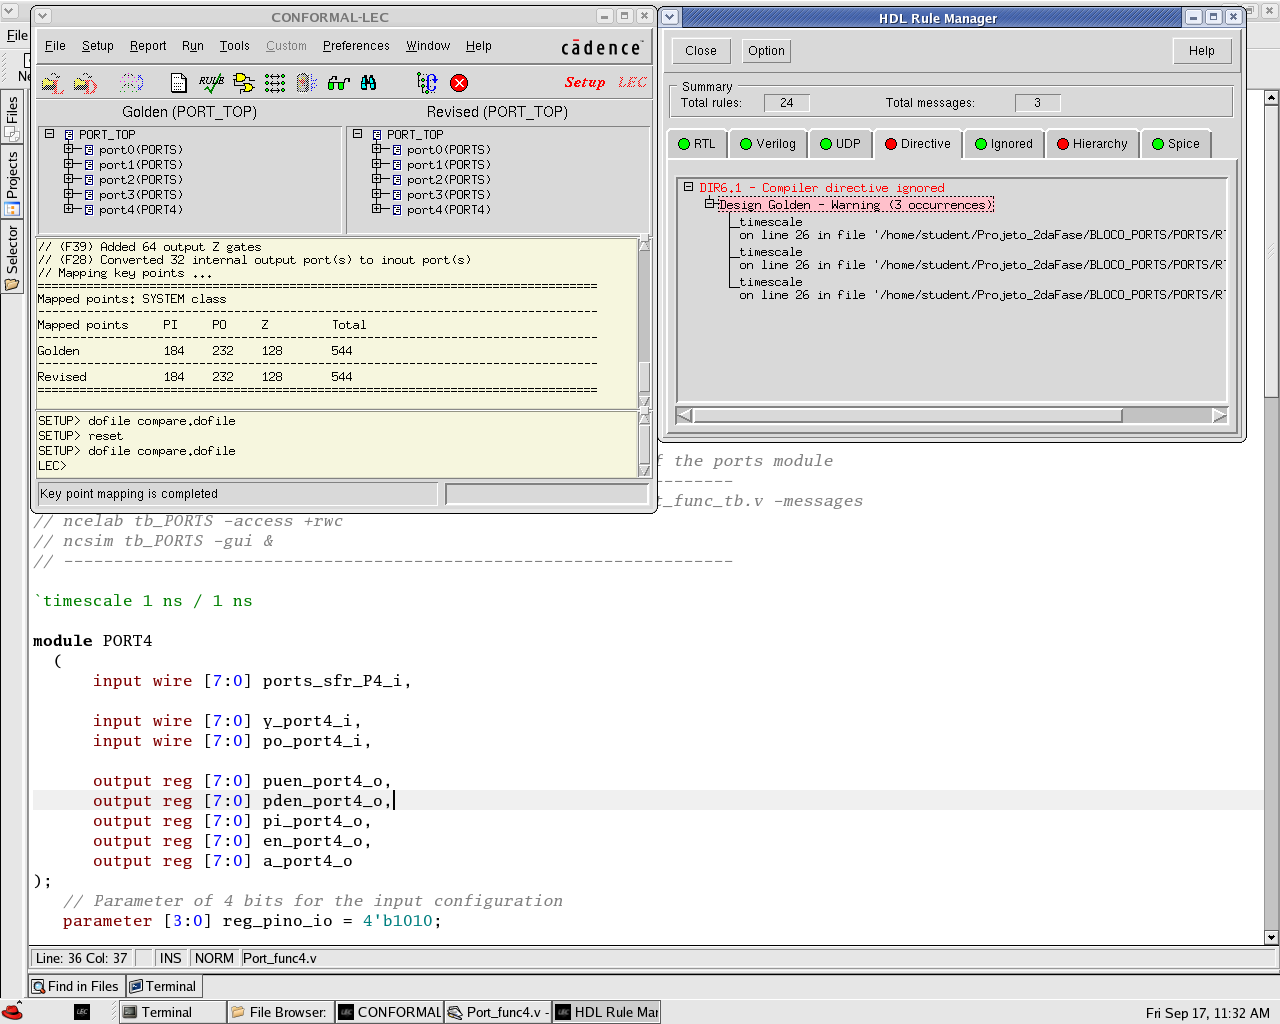
ports/design/reports/graficos_ports/compare.png
