pedrofausto/EMC08/ports/design/reports/graficos_ports/port0_RD.png

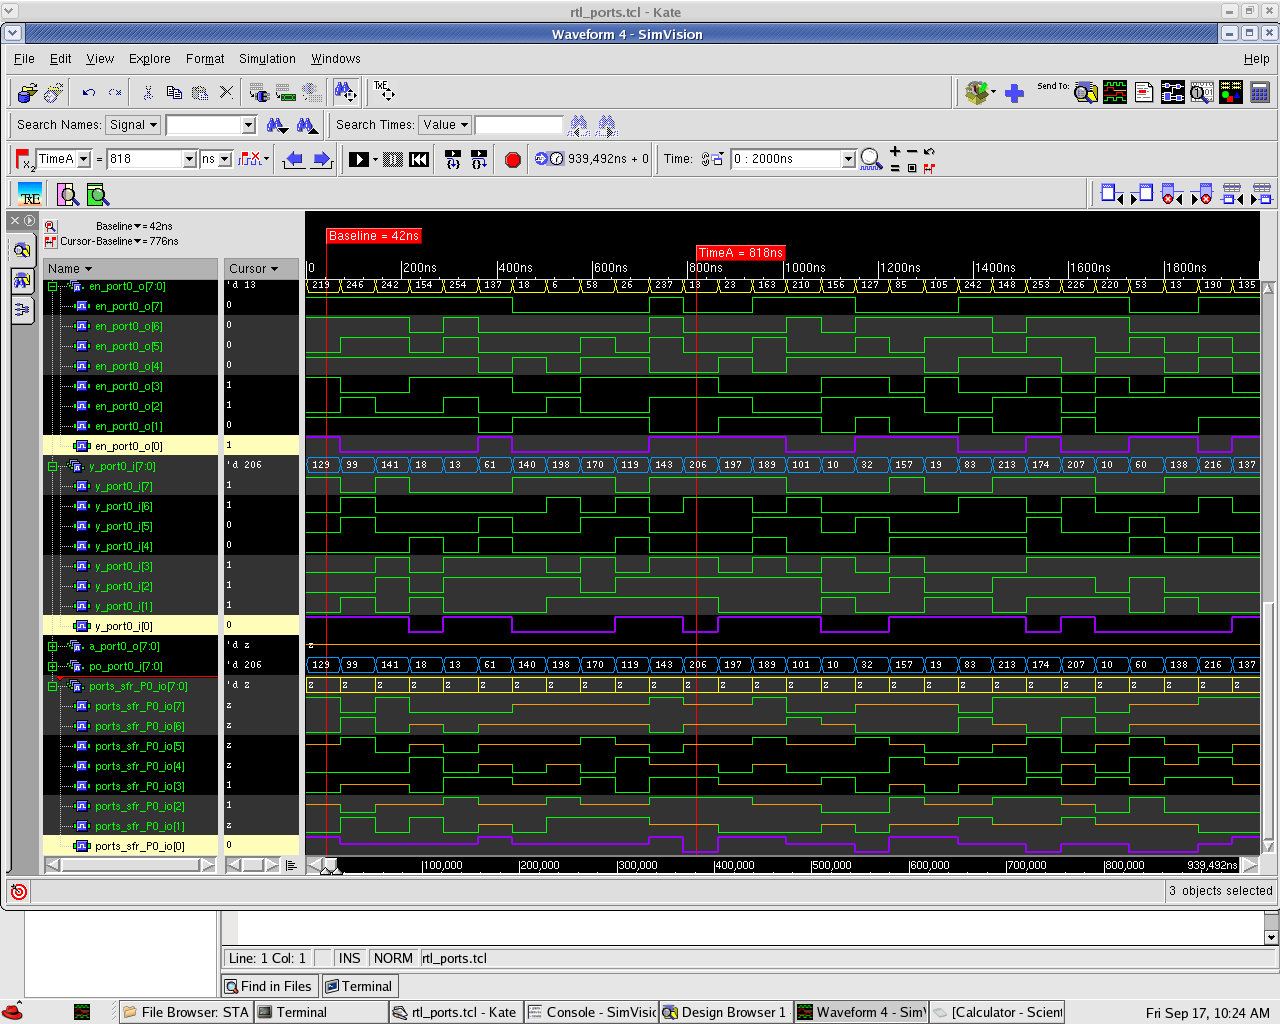
ports/design/reports/graficos_ports/port0_RD.png
