pedrofausto/EMC08/ports/design/reports/graficos_ports/wave_form_ports0.png

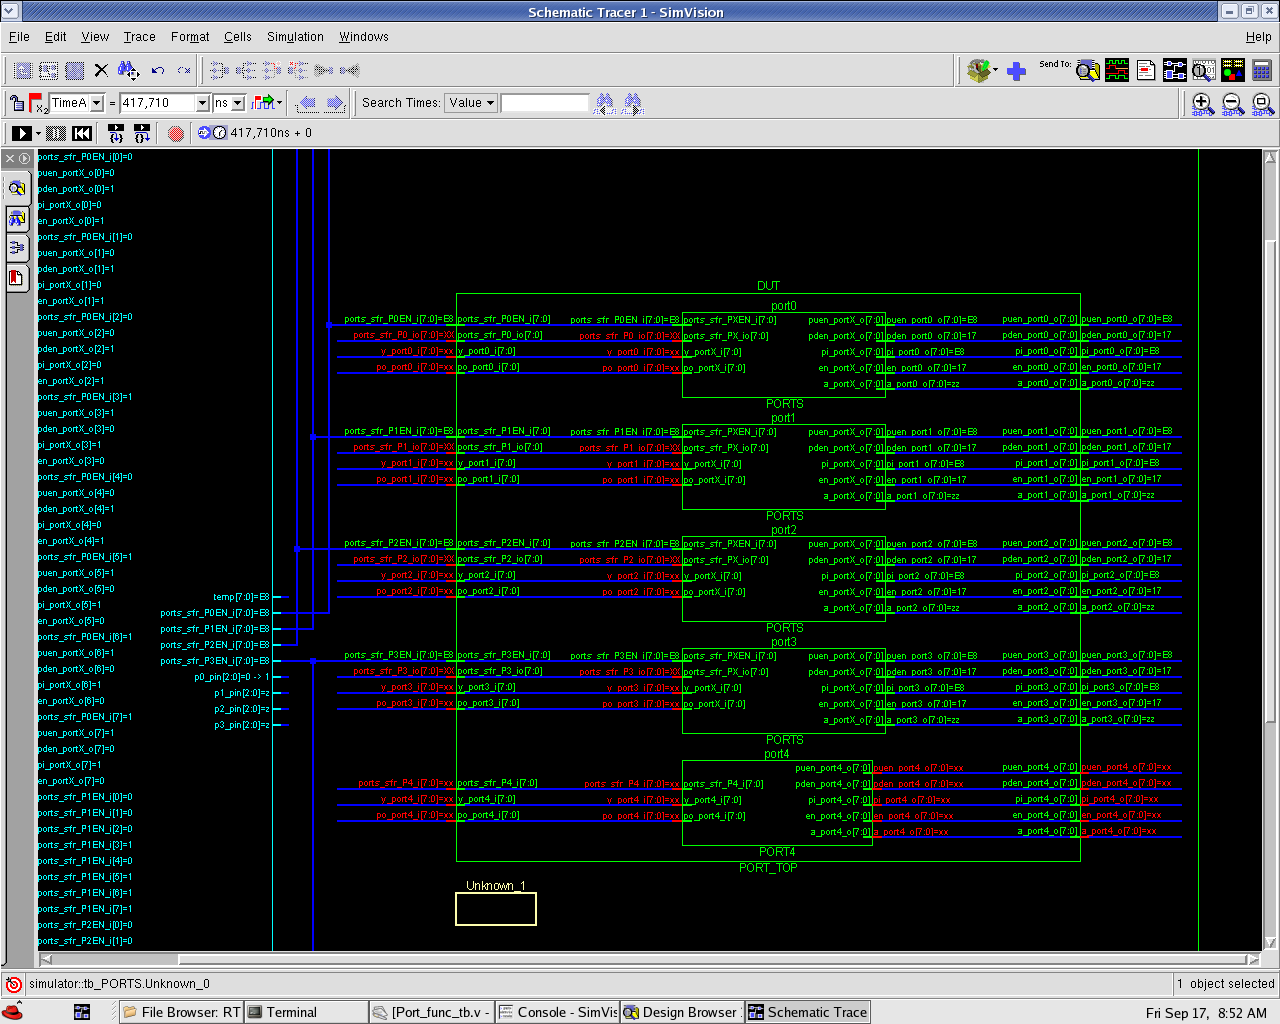
ports/design/reports/graficos_ports/wave_form_ports0.png
