pedrofausto/EMC08/core/verification/testbench/SFR_Controller/README

* Title: Library for the Basic Training Class v6.1.1
* Version: 6.1.1
* Modified: Oct-2007
* Description:
This is the library for the 5-day Specman Basic Training v6.1.1 labs
