pedrofausto/EMC08/ports/design/reports/graficos_ports/verify_conf.png

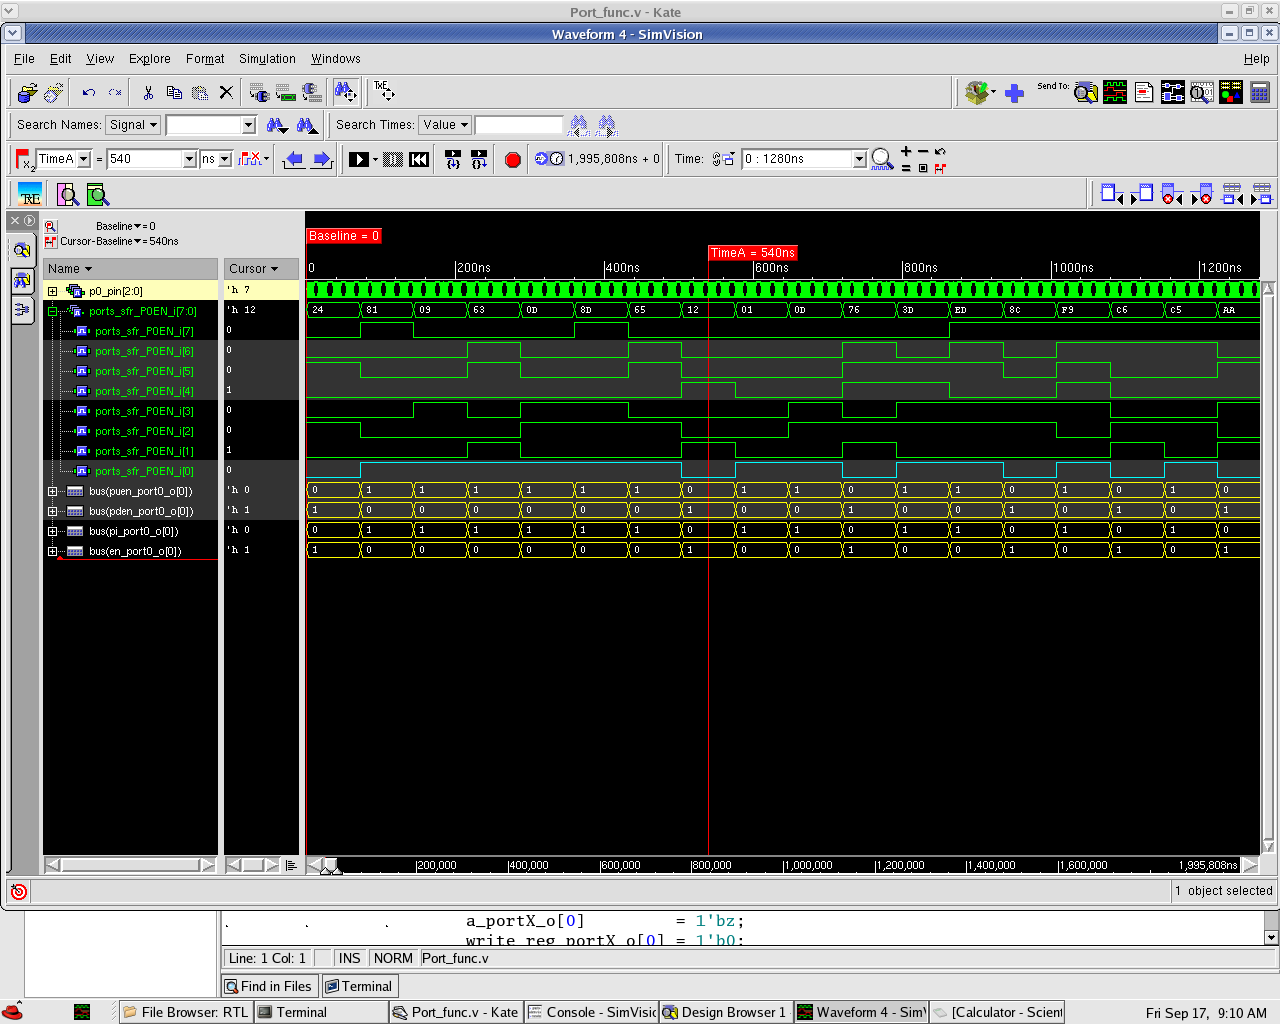
ports/design/reports/graficos_ports/verify_conf.png
