pedrofausto/EMC08/(list of files, drawings)

Other design files:
core/design/rtl_v/waves.shm/waves.dsn
serial/design/rtl_v/receiver/detector/waves.shm/waves.dsn
serial/design/rtl_v/receiver/waves.shm/waves.dsn
serial/design/rtl_v/waves.shm/waves.dsn
serial/verification/testbench_vlog/waves.shm/waves.dsn
top/backend/wrapper/waves.shm/waves.dsn
