pedrofausto/EMC08/serial/design/rtl_v/serial_top_tb_mode2.v

// -------------------------------------------------------------------
// CI Brasil - CT2 Campinas
// Phase II Project
// EMC08 - 8 Bit Microcontroller for Automotive Engine Application
// -------------------------------------------------------------------
// File Name: serial_top_tb_mode0.v
// Module Name: serial
// Author: Harney Abrhaim, Gabriela Mingan
// E-mail: harneybelem@gmail.com ,gabrielamin315@gmail.com
// -------------------------------------------------------------------
// Release History
// Version Date Description
// 1.0 01/09/2010 Initial version
// 2.0 08/09/2010 Test bench to top mode 2 of serial block
// 2.1 10/09/2010 standard signals names
// -------------------------------------------------------------------
// Description
// Implements the serial top mode0 testbench of serial block 
// -------------------------------------------------------------------/
module serial_top_tb_mode2 (); 

parameter PERIOD = 50;

reg serial_clock_i,
    serial_reset_i_b,
    serial_br_i,
    serial_br_trans_i,
    serial_scon0_ri_i,
    serial_scon1_ti_i,
    serial_scon3_tb8_i,
    serial_scon4_ren_i,
    serial_scon7_sm0_i,
    serial_serial_tx_i,
    serial_p3_0_i;
reg [7:0]serial_data_sbuf_i;

wire serial_p3en_0_o,
     serial_p3en_1_o,
     serial_p3_0_o,
     serial_p3_1_o,
     serial_scon0_ri_o,
     serial_scon1_ti_o,
     serial_scon2_rb8_o;
wire [7:0]serial_data_sbuf_o;


// internal wires
wire clear;
reg [4:0]count_internal;

serial_top serial_top_tb_mode2 (
                  .serial_clock_i           (serial_clock_i),
                  .serial_reset_i_b         (serial_reset_i_b),
                  .serial_br_i              (serial_br_i),
                  .serial_br_trans_i        (serial_br_trans_i),
                  .serial_scon0_ri_i        (serial_scon0_ri_i),
                  .serial_scon1_ti_i        (serial_scon1_ti_i),
                  .serial_scon3_tb8_i       (serial_scon3_tb8_i),
                  .serial_scon4_ren_i       (serial_scon4_ren_i),
                  .serial_scon7_sm0_i       (serial_scon7_sm0_i),
                  .serial_serial_tx_i       (serial_serial_tx_i),
                  .serial_data_sbuf_i       (serial_data_sbuf_i),
                  .serial_p3_0_i            (serial_p3_0_i),
                  
                  .serial_p3en_0_o          (serial_p3en_0_o),
                  .serial_p3en_1_o          (serial_p3en_1_o),
                  .serial_p3_0_o            (serial_p3_0_o),
                  .serial_p3_1_o            (serial_p3_1_o),
                  .serial_scon0_ri_o        (serial_scon0_ri_o),
                  .serial_scon1_ti_o        (serial_scon1_ti_o),
                  .serial_scon2_rb8_o       (serial_scon2_rb8_o),
                  .serial_data_sbuf_o       (serial_data_sbuf_o)
                  ); 

always 
begin
   serial_clock_i <= 1'b1;
   #(PERIOD);
   serial_clock_i <= 1'b0;
   #(PERIOD); 
end

always 
begin
   serial_br_trans_i <= 1'b0;
   #(PERIOD*2);
   serial_br_trans_i <= 1'b1;
   #(PERIOD*2); 
end

always 
begin
   serial_br_i <= 1'b0;
   #(PERIOD*32);
   serial_br_i <= 1'b1;
   #(PERIOD*32); 
end



initial
begin
    
    @(posedge serial_clock_i);
    serial_reset_i_b = 1'b0;
    
    serial_scon0_ri_i         = 1'b0;
    serial_scon1_ti_i         = 1'b0;
    serial_scon3_tb8_i          = 1'b0;
    serial_scon4_ren_i          = 1'b0;
    serial_scon7_sm0_i         = 1'b1;
    serial_serial_tx_i          = 1'b0;
    serial_p3_0_i             = 1'b1; //stop bit =1
    serial_data_sbuf_i        = 8'd0;
    
    @(posedge serial_clock_i);
    serial_reset_i_b = 1'b1;
    
    /////////////// test case 1 - RECEIVING 01010101 - rb8 = 0 ///////////
    
   @(posedge serial_clock_i);   @(posedge serial_clock_i);   @(posedge serial_clock_i);     @(posedge serial_clock_i);   @(posedge serial_clock_i);   @(posedge serial_clock_i);

   #1;serial_scon4_ren_i            = 1'b1; // begins the reception
   #1;serial_scon0_ri_i           = 1'b0;
 
   @(posedge serial_clock_i);@(posedge serial_clock_i);@(posedge serial_clock_i);@(posedge serial_clock_i);
   @(posedge serial_clock_i);@(posedge serial_clock_i);@(posedge serial_clock_i);@(posedge serial_clock_i);
   @(posedge serial_clock_i);@(posedge serial_clock_i);@(posedge serial_clock_i);@(posedge serial_clock_i);
   @(posedge serial_clock_i);@(posedge serial_clock_i);@(posedge serial_clock_i);@(posedge serial_clock_i); 

   #2; serial_p3_0_i = 1'b1;
  
   @(posedge serial_clock_i);@(posedge serial_clock_i);
   
   #2; serial_p3_0_i = 1'b0; // start bit
   
   @(posedge serial_clock_i);@(posedge serial_clock_i);@(posedge serial_clock_i);@(posedge serial_clock_i);
   @(posedge serial_clock_i);@(posedge serial_clock_i);@(posedge serial_clock_i);@(posedge serial_clock_i);
   @(posedge serial_clock_i);@(posedge serial_clock_i);@(posedge serial_clock_i);@(posedge serial_clock_i);
   
   @(posedge serial_clock_i);@(posedge serial_clock_i);@(posedge serial_clock_i);@(posedge serial_clock_i);
   @(posedge serial_clock_i);@(posedge serial_clock_i);@(posedge serial_clock_i);@(posedge serial_clock_i);
   @(posedge serial_clock_i);@(posedge serial_clock_i);@(posedge serial_clock_i);@(posedge serial_clock_i);
   @(posedge serial_clock_i);@(posedge serial_clock_i);@(posedge serial_clock_i);@(posedge serial_clock_i);
   
   @(posedge serial_clock_i);@(posedge serial_clock_i);@(posedge serial_clock_i);@(posedge serial_clock_i);
   @(posedge serial_clock_i);@(posedge serial_clock_i);@(posedge serial_clock_i);@(posedge serial_clock_i);
   @(posedge serial_clock_i);@(posedge serial_clock_i);@(posedge serial_clock_i);@(posedge serial_clock_i);
   @(posedge serial_clock_i);@(posedge serial_clock_i);@(posedge serial_clock_i);@(posedge serial_clock_i);
   
   #1;serial_p3_0_i = 1'b0; // data 0
   
   @(posedge serial_clock_i);@(posedge serial_clock_i);@(posedge serial_clock_i);@(posedge serial_clock_i);
   @(posedge serial_clock_i);@(posedge serial_clock_i);@(posedge serial_clock_i);@(posedge serial_clock_i);
   @(posedge serial_clock_i);@(posedge serial_clock_i);@(posedge serial_clock_i);@(posedge serial_clock_i);
   @(posedge serial_clock_i);@(posedge serial_clock_i);@(posedge serial_clock_i);@(posedge serial_clock_i);
   
   @(posedge serial_clock_i);@(posedge serial_clock_i);@(posedge serial_clock_i);@(posedge serial_clock_i);
   @(posedge serial_clock_i);@(posedge serial_clock_i);@(posedge serial_clock_i);@(posedge serial_clock_i);
   @(posedge serial_clock_i);@(posedge serial_clock_i);@(posedge serial_clock_i);@(posedge serial_clock_i);
   @(posedge serial_clock_i);@(posedge serial_clock_i);@(posedge serial_clock_i);@(posedge serial_clock_i);
   
   #1;serial_p3_0_i = 1'b1; // data 2
   
   @(posedge serial_clock_i);@(posedge serial_clock_i);@(posedge serial_clock_i);@(posedge serial_clock_i);
   @(posedge serial_clock_i);@(posedge serial_clock_i);@(posedge serial_clock_i);@(posedge serial_clock_i);
   @(posedge serial_clock_i);@(posedge serial_clock_i);@(posedge serial_clock_i);@(posedge serial_clock_i);
   @(posedge serial_clock_i);@(posedge serial_clock_i);@(posedge serial_clock_i);@(posedge serial_clock_i);
   
   @(posedge serial_clock_i);@(posedge serial_clock_i);@(posedge serial_clock_i);@(posedge serial_clock_i);
   @(posedge serial_clock_i);@(posedge serial_clock_i);@(posedge serial_clock_i);@(posedge serial_clock_i);
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
   @(posedge serial_clock_i);@(posedge serial_clock_i);@(posedge serial_clock_i);@(posedge serial_clock_i);
   @(posedge serial_clock_i);@(posedge serial_clock_i);@(posedge serial_clock_i);@(posedge serial_clock_i);     

   @(posedge serial_clock_i);@(posedge serial_clock_i);@(posedge serial_clock_i);@(posedge serial_clock_i);
   @(posedge serial_clock_i);@(posedge serial_clock_i);@(posedge serial_clock_i);@(posedge serial_clock_i);
   @(posedge serial_clock_i);@(posedge serial_clock_i);@(posedge serial_clock_i);@(posedge serial_clock_i);
   @(posedge serial_clock_i);@(posedge serial_clock_i);@(posedge serial_clock_i);@(posedge serial_clock_i);
   
   #1; serial_p3_0_i = 1'b1; //stop bit
   
   @(posedge serial_clock_i);@(posedge serial_clock_i);@(posedge serial_clock_i);
   
   #1;serial_scon4_ren_i            = 1'b0;
   
   @(posedge serial_clock_i);@(posedge serial_clock_i);@(posedge serial_clock_i);@(posedge serial_clock_i);
   @(posedge serial_clock_i);@(posedge serial_clock_i);@(posedge serial_clock_i);@(posedge serial_clock_i);
   @(posedge serial_clock_i);@(posedge serial_clock_i);@(posedge serial_clock_i);@(posedge serial_clock_i);
   @(posedge serial_clock_i);   @(posedge serial_clock_i);  
   
   
   /////////////// test case 2 - RECEIVING 11111111 - rb8 = 1 ///////////
    
   @(posedge serial_clock_i);   @(posedge serial_clock_i);   @(posedge serial_clock_i);     @(posedge serial_clock_i);   @(posedge serial_clock_i);   @(posedge serial_clock_i);

   #1;serial_scon4_ren_i            = 1'b1; // begins the reception
   #1;serial_scon0_ri_i           = 1'b0;
 
   @(posedge serial_clock_i);@(posedge serial_clock_i);@(posedge serial_clock_i);@(posedge serial_clock_i);
   @(posedge serial_clock_i);@(posedge serial_clock_i);@(posedge serial_clock_i);@(posedge serial_clock_i);
   @(posedge serial_clock_i);@(posedge serial_clock_i);@(posedge serial_clock_i);@(posedge serial_clock_i);
   @(posedge serial_clock_i);@(posedge serial_clock_i);@(posedge serial_clock_i);@(posedge serial_clock_i); 

   #2; serial_p3_0_i = 1'b1;
  
   @(posedge serial_clock_i);@(posedge serial_clock_i); @(posedge serial_clock_i);
   
   #2; serial_p3_0_i = 1'b0; // start bit
   
   @(posedge serial_clock_i);@(posedge serial_clock_i);@(posedge serial_clock_i);@(posedge serial_clock_i);
   @(posedge serial_clock_i);@(posedge serial_clock_i);@(posedge serial_clock_i);@(posedge serial_clock_i);
   @(posedge serial_clock_i);@(posedge serial_clock_i);@(posedge serial_clock_i);@(posedge serial_clock_i);
   
   @(posedge serial_clock_i);@(posedge serial_clock_i);@(posedge serial_clock_i);@(posedge serial_clock_i);
   @(posedge serial_clock_i);@(posedge serial_clock_i);@(posedge serial_clock_i);@(posedge serial_clock_i);
   @(posedge serial_clock_i);@(posedge serial_clock_i);@(posedge serial_clock_i);@(posedge serial_clock_i);
   @(posedge serial_clock_i);@(posedge serial_clock_i);@(posedge serial_clock_i);@(posedge serial_clock_i);
   
   @(posedge serial_clock_i);@(posedge serial_clock_i);@(posedge serial_clock_i);@(posedge serial_clock_i);
   @(posedge serial_clock_i);@(posedge serial_clock_i);@(posedge serial_clock_i);@(posedge serial_clock_i);
   @(posedge serial_clock_i);@(posedge serial_clock_i);@(posedge serial_clock_i);@(posedge serial_clock_i);
   @(posedge serial_clock_i);@(posedge serial_clock_i);@(posedge serial_clock_i);@(posedge serial_clock_i);
   
   #1;serial_p3_0_i = 1'b1; // data 0
   
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
   @(posedge serial_clock_i);@(posedge serial_clock_i);@(posedge serial_clock_i);@(posedge serial_clock_i);
    
   #1; serial_p3_0_i = 1'b1; //rb8 
      
   @(posedge serial_clock_i);@(posedge serial_clock_i);@(posedge serial_clock_i);@(posedge serial_clock_i);
   @(posedge serial_clock_i);@(posedge serial_clock_i);@(posedge serial_clock_i);@(posedge serial_clock_i);
   @(posedge serial_clock_i);@(posedge serial_clock_i);@(posedge serial_clock_i);@(posedge serial_clock_i);
   @(posedge serial_clock_i);@(posedge serial_clock_i);@(posedge serial_clock_i);@(posedge serial_clock_i);     

   @(posedge serial_clock_i);@(posedge serial_clock_i);@(posedge serial_clock_i);@(posedge serial_clock_i);
   @(posedge serial_clock_i);@(posedge serial_clock_i);@(posedge serial_clock_i);@(posedge serial_clock_i);
   @(posedge serial_clock_i);@(posedge serial_clock_i);@(posedge serial_clock_i);@(posedge serial_clock_i);
   @(posedge serial_clock_i);@(posedge serial_clock_i);@(posedge serial_clock_i);@(posedge serial_clock_i);
   
   #1; serial_p3_0_i = 1'b1; //stop bit
   
   @(posedge serial_clock_i);@(posedge serial_clock_i);@(posedge serial_clock_i);
   
   #1;serial_scon4_ren_i            = 1'b0;
   
   @(posedge serial_clock_i);@(posedge serial_clock_i);@(posedge serial_clock_i);@(posedge serial_clock_i);
   @(posedge serial_clock_i);@(posedge serial_clock_i);@(posedge serial_clock_i);@(posedge serial_clock_i);
   @(posedge serial_clock_i);@(posedge serial_clock_i);@(posedge serial_clock_i);@(posedge serial_clock_i);
   
   @(posedge serial_clock_i);   @(posedge serial_clock_i);  
   
   /////////////// test case 3 - TRANSMITING 01010101 - tb8 = 0 ///////////
    
   @(posedge serial_clock_i);   @(posedge serial_clock_i);   @(posedge serial_clock_i);     @(posedge serial_clock_i);   @(posedge serial_clock_i);   @(posedge serial_clock_i);

   
   serial_scon3_tb8_i          = 1'b0;
   serial_scon7_sm0_i         = 1'b1;
   serial_serial_tx_i          = 1'b0;
   serial_p3_0_i             = 1'b0; //stop bit =1
   serial_data_sbuf_i        = 8'b00000000;
      
 
   @(posedge serial_clock_i);@(posedge serial_clock_i);@(posedge serial_clock_i);@(posedge serial_clock_i);
   @(posedge serial_clock_i);@(posedge serial_clock_i);@(posedge serial_clock_i);@(posedge serial_clock_i);
   @(posedge serial_clock_i);@(posedge serial_clock_i);@(posedge serial_clock_i);@(posedge serial_clock_i);
   @(posedge serial_clock_i);@(posedge serial_clock_i);@(posedge serial_clock_i);@(posedge serial_clock_i); 

   serial_serial_tx_i          = 1'b1;
   serial_data_sbuf_i        = 8'b01010101;
  
   @(posedge serial_clock_i);
   
   serial_serial_tx_i          = 1'b0;
      
   @(posedge serial_clock_i);@(posedge serial_clock_i);@(posedge serial_clock_i);@(posedge serial_clock_i);
   @(posedge serial_clock_i);@(posedge serial_clock_i);@(posedge serial_clock_i);@(posedge serial_clock_i);
   @(posedge serial_clock_i);@(posedge serial_clock_i);@(posedge serial_clock_i);@(posedge serial_clock_i);
   
   @(posedge serial_clock_i);@(posedge serial_clock_i);@(posedge serial_clock_i);@(posedge serial_clock_i);
   @(posedge serial_clock_i);@(posedge serial_clock_i);@(posedge serial_clock_i);@(posedge serial_clock_i);
   @(posedge serial_clock_i);@(posedge serial_clock_i);@(posedge serial_clock_i);@(posedge serial_clock_i);
   @(posedge serial_clock_i);@(posedge serial_clock_i);@(posedge serial_clock_i);@(posedge serial_clock_i);
   
   @(posedge serial_clock_i);@(posedge serial_clock_i);@(posedge serial_clock_i);@(posedge serial_clock_i);
   @(posedge serial_clock_i);@(posedge serial_clock_i);@(posedge serial_clock_i);@(posedge serial_clock_i);
   @(posedge serial_clock_i);@(posedge serial_clock_i);@(posedge serial_clock_i);@(posedge serial_clock_i);
   @(posedge serial_clock_i);@(posedge serial_clock_i);@(posedge serial_clock_i);@(posedge serial_clock_i);
   
   // data 0
   
   @(posedge serial_clock_i);@(posedge serial_clock_i);@(posedge serial_clock_i);@(posedge serial_clock_i);
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
   @(posedge serial_clock_i);@(posedge serial_clock_i);@(posedge serial_clock_i);@(posedge serial_clock_i); 
   @(posedge serial_clock_i);@(posedge serial_clock_i);@(posedge serial_clock_i);@(posedge serial_clock_i); 
   @(posedge serial_clock_i);@(posedge serial_clock_i);@(posedge serial_clock_i);@(posedge serial_clock_i);
   @(posedge serial_clock_i);@(posedge serial_clock_i);@(posedge serial_clock_i);@(posedge serial_clock_i);
   @(posedge serial_clock_i);@(posedge serial_clock_i);@(posedge serial_clock_i);@(posedge serial_clock_i); 
   
        
    $finish(0);    
        
end




endmodule
