pedrofausto/EMC08/ports/verification/testbench/ports_verification.v

// -------------------------------------------------------------------
// CI Brasil - CT2 Campinas
// Phase II Project
// EMC08 - 8 Bit Microcontroller for Automotive Engine Application
// -------------------------------------------------------------------
// File Name: verification_ports.v
// Module Name: tb_verification_ports
// Author: Valeria Ap. Pereira and Jonatas Valentim Ferrari
// E-mail: valeriapereira85@yahoo.com.br and jonatasferrari@gmail.com
// -------------------------------------------------------------------
// Release History
// Version Date Description
// 1.0 10/09/2010 Initial version
// -------------------------------------------------------------------
// Description
// In this file was created tasks to verify the features described
// in verification guide.
// -------------------------------------------------------------------

`timescale 1ns/10ps
`include "verilog.v"
`include "VLG_xc018_IO_PRIMITIVES.v"

module tb_ports_verification;

reg [7:0] ports_sfr_P0EN_i;   
reg [7:0] ports_sfr_P1EN_i;   
reg [7:0] ports_sfr_P2EN_i;   
reg [7:0] ports_sfr_P3EN_i;     
   
reg [7:0] ports_sfr_P0_i;
reg [7:0] ports_sfr_P1_i;
reg [7:0] ports_sfr_P2_i;
reg [7:0] ports_sfr_P3_i;   
reg [7:0] ports_sfr_P4_i;
   
wire [7:0] y_port0_i;
wire [7:0] y_port1_i;
wire [7:0] y_port2_i;
wire [7:0] y_port3_i;
   
wire [7:0] ports_sfr_P0_o;
wire [7:0] ports_sfr_P1_o;
wire [7:0] ports_sfr_P2_o;
wire [7:0] ports_sfr_P3_o;
 
wire [7:0] en_port0_o;
wire [7:0] en_port1_o;
wire [7:0] en_port2_o;
wire [7:0] en_port3_o;

wire [7:0] a_port0_o;
wire [7:0] a_port1_o;
wire [7:0] a_port2_o;
wire [7:0] a_port3_o;
wire [7:0] a_port4_o;

reg vddo;
reg vddr;
reg vdd ;
reg gndo;
reg gndr;
reg puen;
reg pden;
reg en  ;
reg pi  ;
wire y  ;
wire po ;

wire [7:0] pad_port0 ;
wire [7:0] pad_port1 ;
wire [7:0] pad_port2 ;
wire [7:0] pad_port3 ;
wire [7:0] pad_port4 ;

reg  [7:0] temp_pad_port0 ;
reg  [7:0] temp_pad_port1 ;
reg  [7:0] temp_pad_port2 ;
reg  [7:0] temp_pad_port3 ;
reg  [7:0] temp_pad_port4 ;

reg       random_bit ;
reg [7:0] random_1   ;
reg [7:0] random_2   ;
reg [7:0] random_3   ;
reg [7:0] random_4   ;
reg [7:0] random_5   ;  
reg [7:0] random_6   ;
reg [7:0] random_7   ;
reg [7:0] random_8   ;
reg [7:0] random_9   ;

reg [2:0] p0_pin ;
reg [2:0] p1_pin ;
reg [2:0] p2_pin ;
reg [2:0] p3_pin ;
reg [2:0] p4_pin ;

// ------ Instanciation --------------------------------------------------

PORT_TOP DUT (
 .ports_sfr_P0EN_i (ports_sfr_P0EN_i),
 .ports_sfr_P1EN_i (ports_sfr_P1EN_i),
 .ports_sfr_P2EN_i (ports_sfr_P2EN_i),
 .ports_sfr_P3EN_i (ports_sfr_P3EN_i),
 
 .ports_sfr_P0_i   (ports_sfr_P0_i  ),
 .ports_sfr_P1_i   (ports_sfr_P1_i  ),
 .ports_sfr_P2_i   (ports_sfr_P2_i  ),
 .ports_sfr_P3_i   (ports_sfr_P3_i  ),
 .ports_sfr_P4_i   (ports_sfr_P4_i  ),

 .y_port0_i        (y_port0_i       ),
 .y_port1_i        (y_port1_i       ),
 .y_port2_i        (y_port2_i       ),
 .y_port3_i        (y_port3_i       ),
 
 .ports_sfr_P0_o   (ports_sfr_P0_o  ),
 .ports_sfr_P1_o   (ports_sfr_P1_o  ),
 .ports_sfr_P2_o   (ports_sfr_P2_o  ),
 .ports_sfr_P3_o   (ports_sfr_P3_o  ),
 
 .en_port0_o       (en_port0_o      ),
 .en_port1_o       (en_port1_o      ),
 .en_port2_o       (en_port2_o      ),
 .en_port3_o       (en_port3_o      ),
 
 .a_port0_o        (a_port0_o       ),
 .a_port1_o        (a_port1_o       ),
 .a_port2_o        (a_port2_o       ),
 .a_port3_o        (a_port3_o       ),
 .a_port4_o        (a_port4_o       )
);

// ------ Port 0 Instanciation --------------------------------------------

BBCUD8P PORT0_0 (
 .VDDO (vddo          ),
 .VDDR (vddr          ),
 .VDD  (vdd           ),
 .GNDO (gndo          ),
 .GNDR (gndr          ),
 .PUEN (puen          ),
 .PDEN (pden          ),
 .PI   (pi            ),
 .EN   (en_port0_o[0] ),
 .A    (a_port0_o[0]  ),
 .PAD  (pad_port0[0]  ),
 .Y    (y_port0_i[0]  ),
 .PO   (po            ) 
);

BBCUD8P PORT0_1 (
 .VDDO (vddo          ),
 .VDDR (vddr          ),
 .VDD  (vdd           ),
 .GNDO (gndo          ),
 .GNDR (gndr          ),
 .PUEN (puen          ),
 .PDEN (pden          ),
 .PI   (pi            ),
 .EN   (en_port0_o[1] ),
 .A    (a_port0_o[1]  ),
 .PAD  (pad_port0[1]  ),
 .Y    (y_port0_i[1]  ),
 .PO   (po            ) 
);

BBCUD8P PORT0_2 (
 .VDDO (vddo          ),
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
   Checker_PAD_Port3 (ports_sfr_P3EN_i[6], en_port3_o[6], pad_port3, ports_sfr_P3_i[6]);
   
   Checker_PAD_Port4 (pad_port4, ports_sfr_P4_i[6]);
      
   #10
   p0_pin = 3'd7;   
   p1_pin = 3'd7;     
   p2_pin = 3'd7;     
   p3_pin = 3'd7;     
   p4_pin = 3'd7;    
   
   Checker_P0EN (ports_sfr_P0EN_i[7], en_port0_o[7]);
   Checker_P1EN (ports_sfr_P1EN_i[7], en_port1_o[7]);
   Checker_P2EN (ports_sfr_P2EN_i[7], en_port2_o[7]);
   Checker_P3EN (ports_sfr_P3EN_i[7], en_port3_o[7]);
   
   Checker_SFR_P0 (ports_sfr_P0EN_i[7], en_port0_o[7], temp_pad_port0, ports_sfr_P0_o[7]);
   Checker_SFR_P1 (ports_sfr_P1EN_i[7], en_port1_o[7], temp_pad_port1, ports_sfr_P1_o[7]);
   Checker_SFR_P2 (ports_sfr_P2EN_i[7], en_port2_o[7], temp_pad_port2, ports_sfr_P2_o[7]);
   Checker_SFR_P3 (ports_sfr_P3EN_i[7], en_port3_o[7], temp_pad_port3, ports_sfr_P3_o[7]);
   
   Checker_PAD_Port0 (ports_sfr_P0EN_i[7], en_port0_o[7], pad_port0, ports_sfr_P0_i[7]);
   Checker_PAD_Port1 (ports_sfr_P1EN_i[7], en_port1_o[7], pad_port1, ports_sfr_P1_i[7]);
   Checker_PAD_Port2 (ports_sfr_P2EN_i[7], en_port2_o[7], pad_port2, ports_sfr_P2_i[7]);
   Checker_PAD_Port3 (ports_sfr_P3EN_i[7], en_port3_o[7], pad_port3, ports_sfr_P3_i[7]);
   
   Checker_PAD_Port4 (pad_port4, ports_sfr_P4_i[7]);
      
   #10
   p0_pin = 3'bz;   
   p1_pin = 3'bz;     
   p2_pin = 3'bz;     
   p3_pin = 3'bz;     
   p4_pin = 3'bz;  

end 

endmodule
