pedrofausto/EMC08/core/design/rtl_v/ROM4096X8.v

//************************************************************************/
// Copyright        : (c) All Rights Reserved
// Company          : X-FAB Semiconductor Foundries AG 
// Address          : Haarbergstr. 67,  D-99097 Erfurt, Germany 
//
// File             : ROM4096X8.v
// Description      : Verilog simulation file
//                  : ROM ROM4096X8
//
// Technology       : xh018 LP3MOS 1.8/3.3 low power CMOS module
// Model version    : V 1.1.1
// Last Modified by : etu
// Created by       :	X-FAB FRONTEND MEMORY COMPILER
//                  :      0.18um ROM XFMC V1.1
// on               : Tue Jun 22 19:31:19 2010
//
// Comment          : If the ATPG tool TetraMAX is used then the following
//		      compiler directive must be set before reading this file:
//
//		      `define ATPG_RUN 
//
//		      To handle negative values of timing checks ($setuphold) the Verilog 
//		      simulator must be started with the option +neg_tchk, otherwise the negative 
//		      values of timing checks are automaticly set to 0.
//		     Also the following compiler directive must be set before reading this file:
//
//		      `define NEG_TCHK 
//
//		      Reading of memory outside of physical address range returns logic "1" data.
//		      The parameter DATA_OUTSIDE_ADDRESS_RANGE controls model behaviour in case of physical address overflow.
//		      This parameter must be set to 8'hX in order to control addressing outside of address space
//		      otherwise 8'hFF
//
//************************************************************************/
//######################################################################################
//#  Copyright (c) X-FAB Semiconductor Foundries AG . All rights reserved.
//#  This Memory Compiler data and the associated documentation are
//#  confidential and proprietary to X-FAB Semiconductor Foundries AG.
//#
//#  DISCLAIMER
//#  The information contained herein is provided by X-FAB Semiconductor
//#  Foundries AG  on an "AS IS" basis without any warranty.
//#
//#  X-FAB Semiconductor Foundries AG disclaims any representation that
//#  the information does not infringe any intellectual property rights or proprietary
//#  rights of any third parties.  There are no other warranties given by
//#  X-FAB, whether express, implied or statutory, including, without limitation,
//#  implied warranties of merchantability and fitness for a particular purpose.
//#
//# In no event X-FAB will be liable or responsible for any expense, losses, damages,
//# or action incurred or undertaken as a result of the receipt of the information.
//#
//#  X-FAB Semiconductor Foundries AG  reserves the right to make changes
//#  to the information at any time and without notice.
//#
//######################################################################################

`resetall
`celldefine
`suppress_faults
`enable_portfaults
`expand_vectornets
`timescale 1ns/10ps
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
